liveboxandy/ZX-Max-128-Issue-5/ZX Max 128 Issue 5 PCB BTM.png

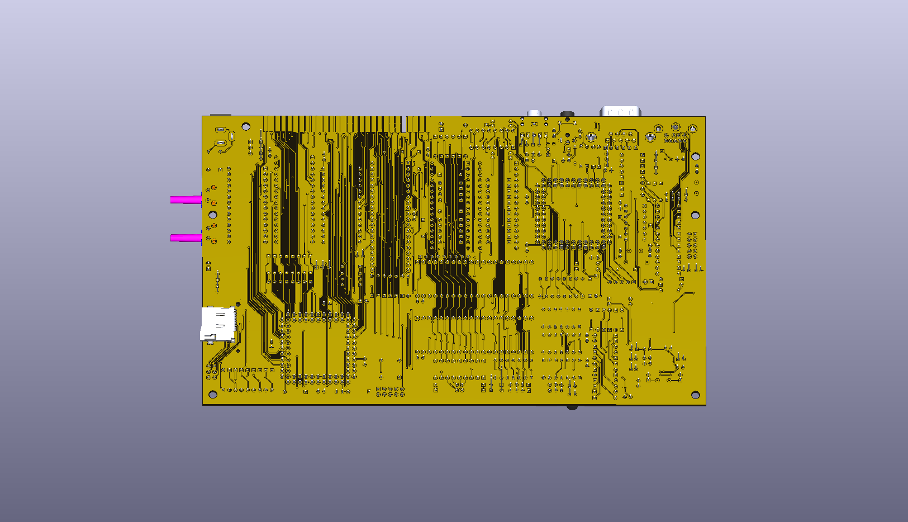
ZX Max 128 Issue 5 PCB BTM.png
