liveboxandy/ZX-Max-128-Issue-5/ZX Max 128 Issue 5 PCB.jpg

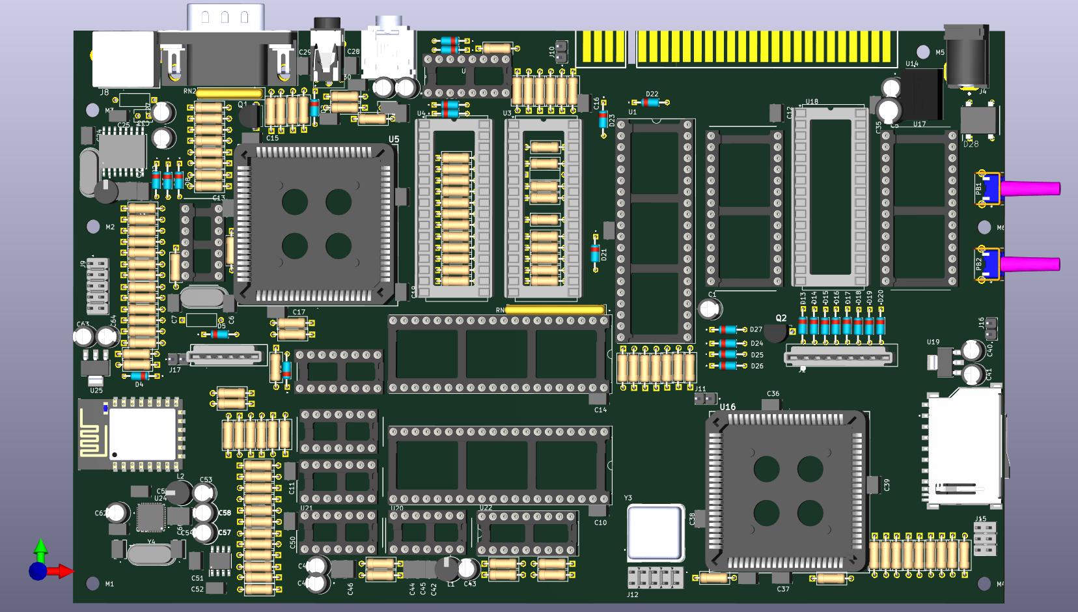
ZX Max 128 Issue 5 PCB.jpg
