liveboxandy/ZX-Max-128-Issue-5/Step/QFN-40 (6x6x0.9).step

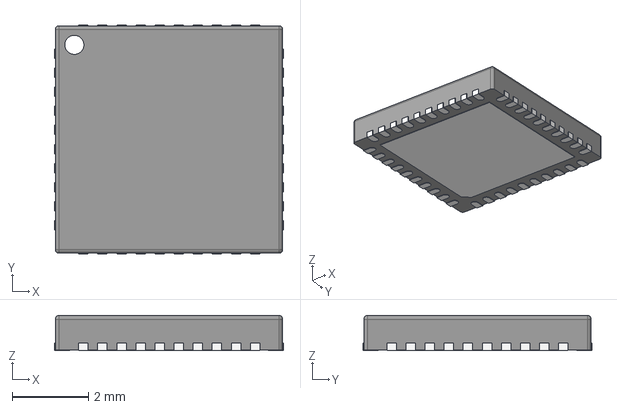
[picture p3: CAD file, 2026-07-04]
Step/QFN-40 (6x6x0.9).step
6.00 x 6.00 x 0.92 mm
