liveboxandy/ZX-Max-128-Issue-5/Step/D_DO-35_SOD27_P7.62mm_Horizontal.step

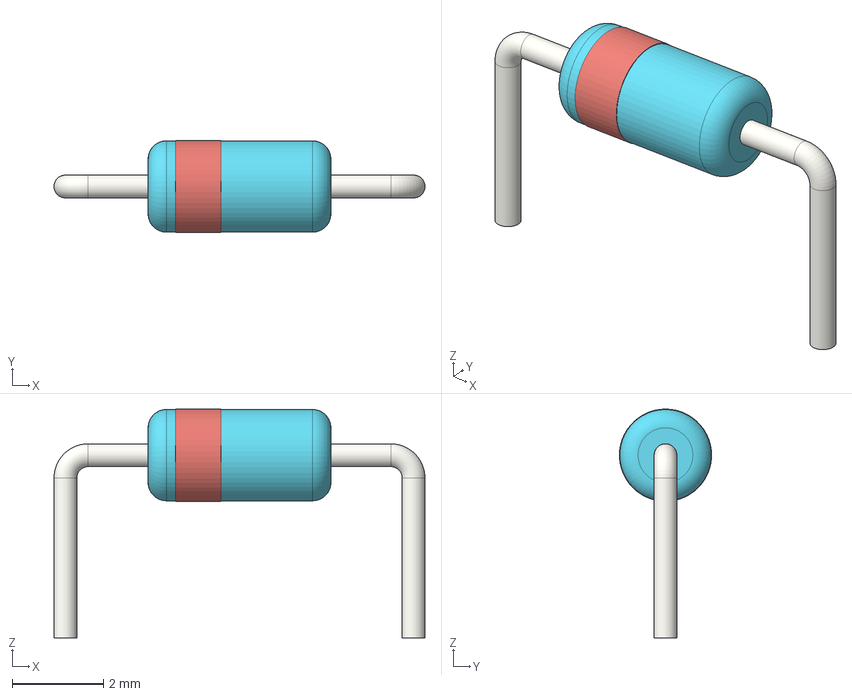
[picture p4: CAD file, 2026-07-04]
Step/D_DO-35_SOD27_P7.62mm_Horizontal.step
8.12 x 2.02 x 5.01 mm
