liveboxandy/ZX-Max-128-Issue-5/Step/Diode Bridge Rectifier DF02M.stp

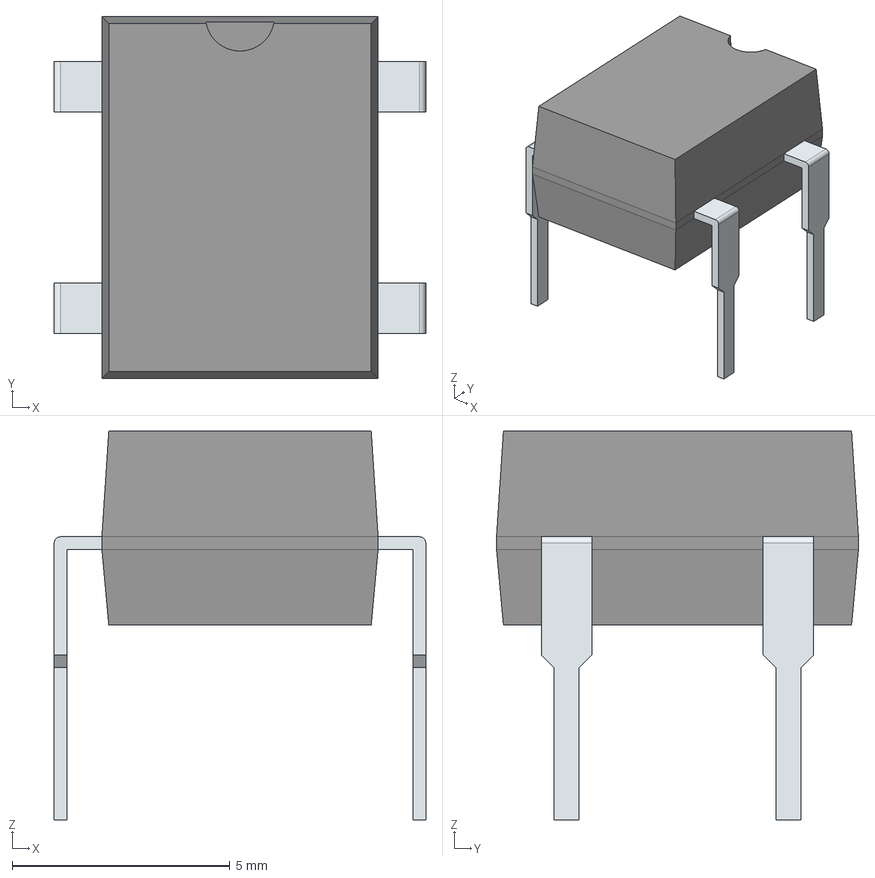
[picture p5: CAD file, 2026-07-04]
Step/Diode Bridge Rectifier DF02M.stp
8.54 x 8.32 x 8.93 mm
PinsArrayLR
