liveboxandy/ZX-Max-128-Issue-5/Step/DIP-40_W15.24mm.step

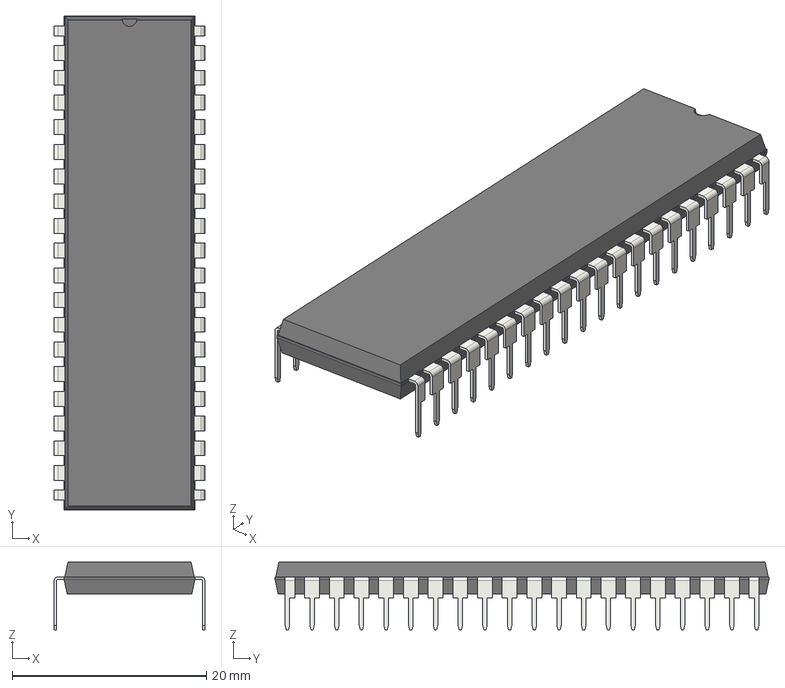
[picture p6: CAD file, 2026-07-04]
Step/DIP-40_W15.24mm.step
15.5 x 50.8 x 6.98 mm
