liveboxandy/ZX-Max-128-Issue-5/Step/Audio Connector SJ1-3525N.step

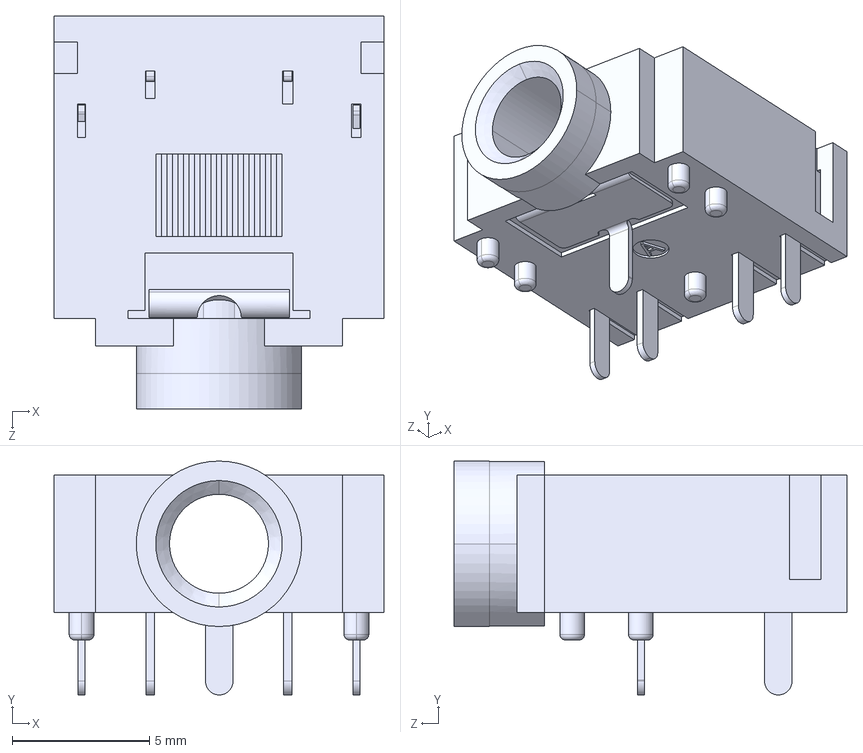
[picture p7: CAD file, 2026-07-04]
Step/Audio Connector SJ1-3525N.step
12.0 x 8.51 x 14.3 mm
