liveboxandy/ZX-Max-128-Issue-5/Step/R-78E5.0-1.0.step

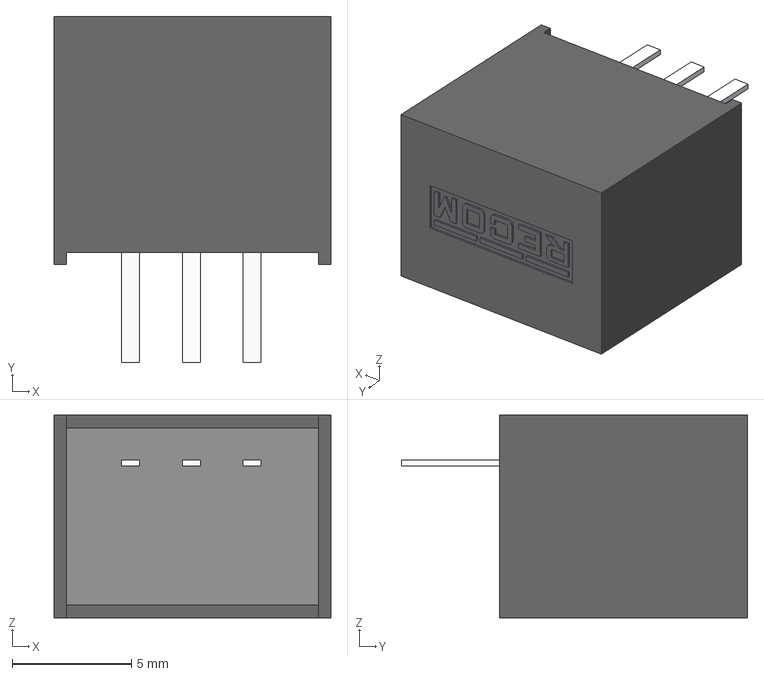
[picture p8: CAD file, 2026-07-04]
Step/R-78E5.0-1.0.step
11.6 x 14.5 x 8.50 mm
