liveboxandy/ZX-Max-128-Issue-5/Step/SN74HC04N.stp

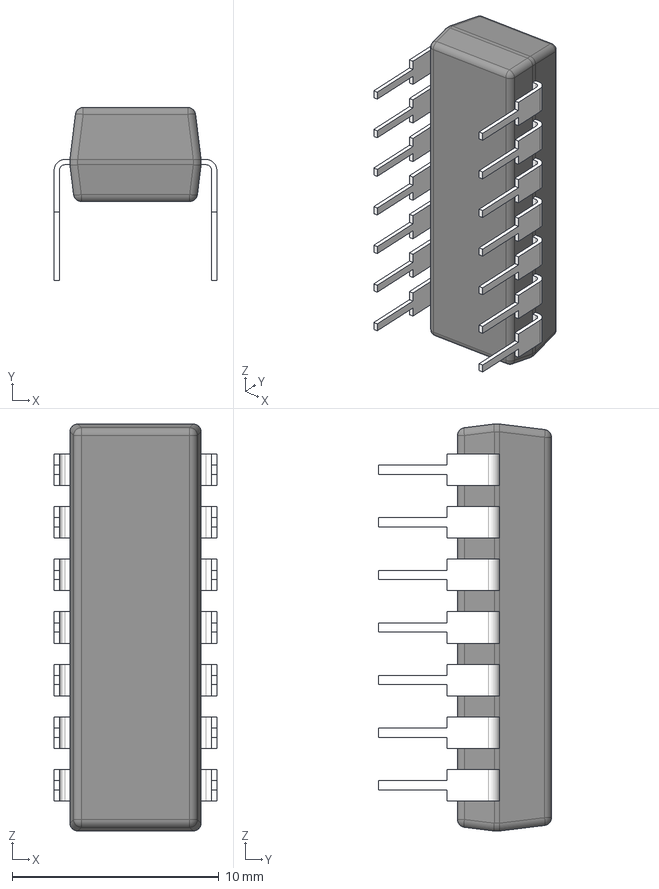
[picture p9: CAD file, 2026-07-04]
Step/SN74HC04N.stp
7.87 x 8.37 x 19.7 mm
BODY_N0014A_AF0
LEAD_N0014A_AF1
LEAD_N0014A x 10
LEAD_N0014A_AF3
LEAD_N0014A_AF0
LEAD_N0014A_AF2
