liveboxandy/ZX-Max-128-Issue-5/Step/Inductor rlb0608.stp

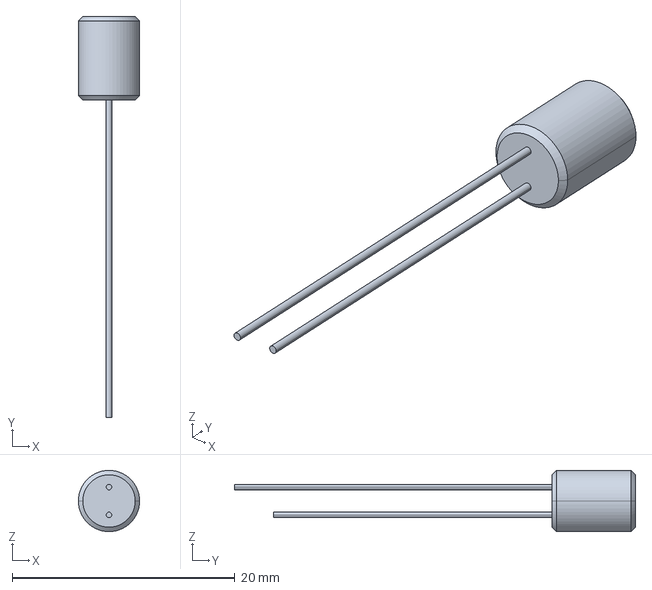
[picture p10: CAD file, 2026-07-04]
Step/Inductor rlb0608.stp
5.50 x 36.0 x 5.50 mm
