liveboxandy/ZX-Max-128-Issue-5/Step/4606X-101-103LF.STEP

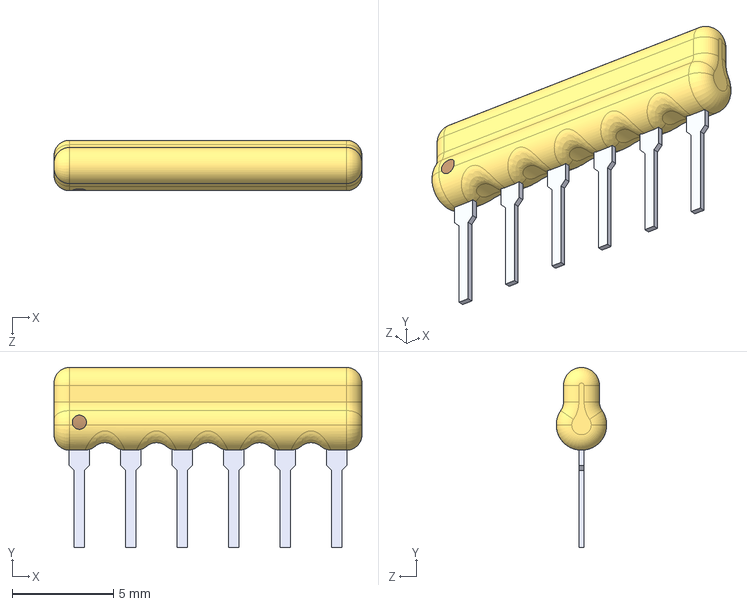
[picture p11: CAD file, 2026-07-04]
Step/4606X-101-103LF.STEP
15.2 x 8.88 x 2.49 mm
