liveboxandy/ZX-Max-128-Issue-5/Step/DIP-32_W15.24mm_Socket-1.stp

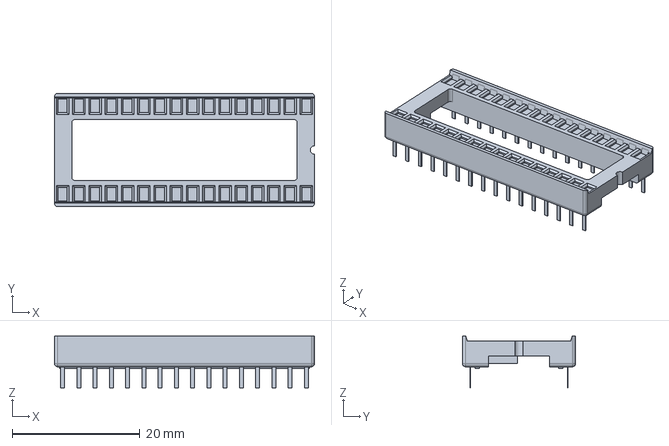
[picture p12: CAD file, 2026-07-04]
Step/DIP-32_W15.24mm_Socket-1.stp
40.6 x 17.7 x 8.10 mm
