liveboxandy/ZX-Max-128-Issue-5/Step/KMDGX-9S-BS-1.stp

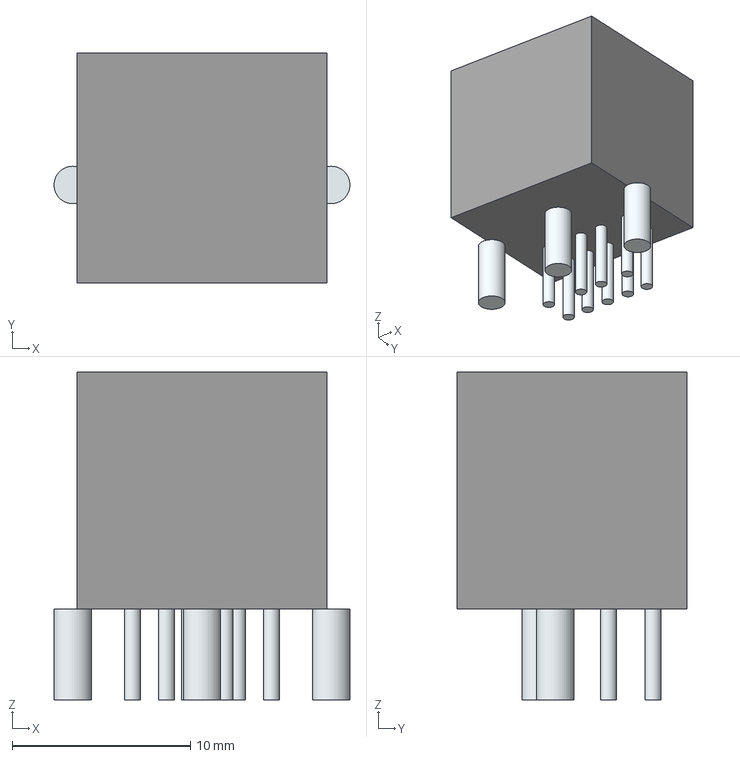
[picture p13: CAD file, 2026-07-04]
Step/KMDGX-9S-BS-1.stp
16.6 x 12.9 x 18.4 mm
Leads
