liveboxandy/ZX-Max-128-Issue-5/Step/Switch 6mm RA SKHHNHA010.stp

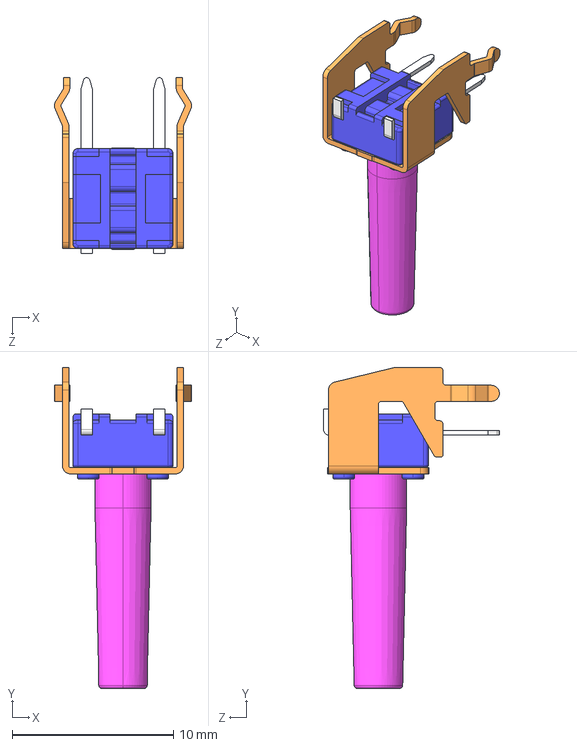
[picture p14: CAD file, 2026-07-04]
Step/Switch 6mm RA SKHHNHA010.stp
8.50 x 19.9 x 10.9 mm
