liveboxandy/ZX-Max-128-Issue-5/Step/Resistor.08.88.step

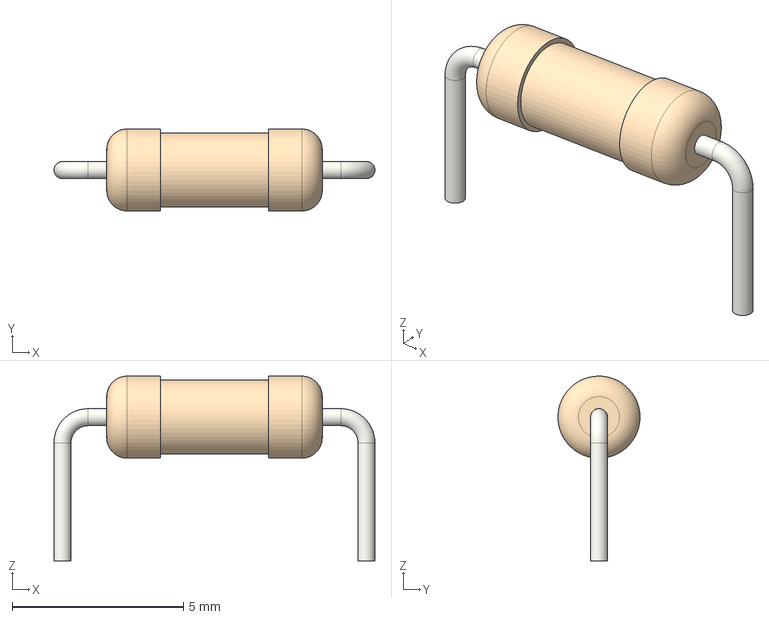
[picture p15: CAD file, 2026-07-04]
Step/Resistor.08.88.step
9.38 x 2.40 x 5.40 mm
