liveboxandy/ZX-Max-128-Issue-5/Step/ESP8266-12E_ESP-12E.step

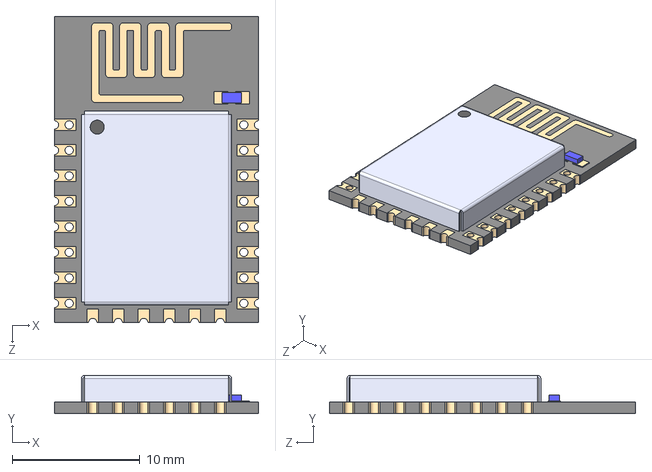
[picture p17: CAD file, 2026-07-04]
Step/ESP8266-12E_ESP-12E.step
16.0 x 3.00 x 24.0 mm
