liveboxandy/ZX-Max-128-Issue-5/Step/SN74HC174N.stp

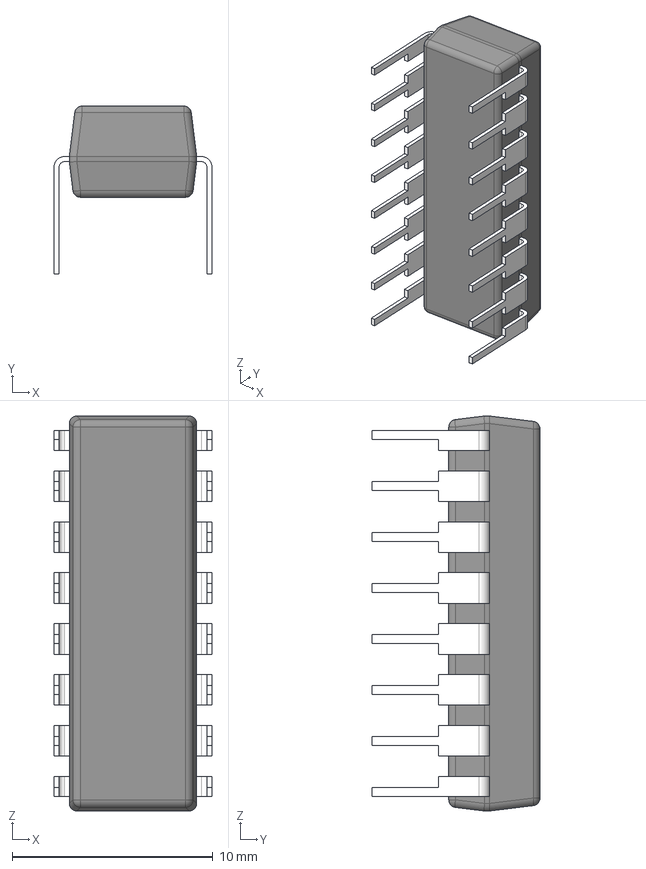
[picture p18: CAD file, 2026-07-04]
Step/SN74HC174N.stp
7.87 x 8.37 x 19.7 mm
BODY_N0016A_AF0
LEAD_N0016A_AF1
LEAD_N0016A x 10
LEAD_N0016A_AF3
LEAD_N0016A_AF5
LEAD_N0016A_AF0
LEAD_N0016A_AF2
LEAD_N0016A_AF4
