liveboxandy/ZX-Max-128-Issue-5/Step/SDCard ST-TF-003A.step

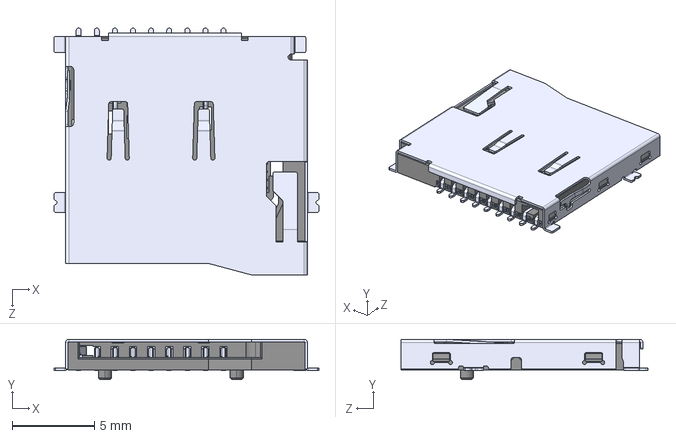
[picture p19: CAD file, 2026-07-04]
Step/SDCard ST-TF-003A.step
16.1 x 2.45 x 15.0 mm
