liveboxandy/ZX-Max-128-Issue-5/Step/IND_BOURNS_RLB0608.step

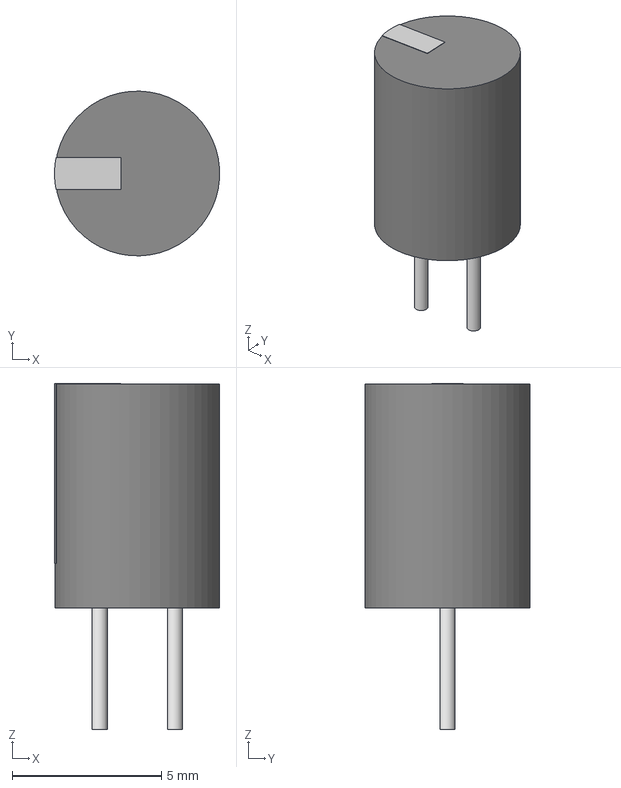
[picture p22: CAD file, 2026-07-04]
Step/IND_BOURNS_RLB0608.step
5.52 x 5.51 x 11.6 mm
