liveboxandy/ZX-Max-128-Issue-5/Step/KMDGX-9S-BS-1_A1.IGS

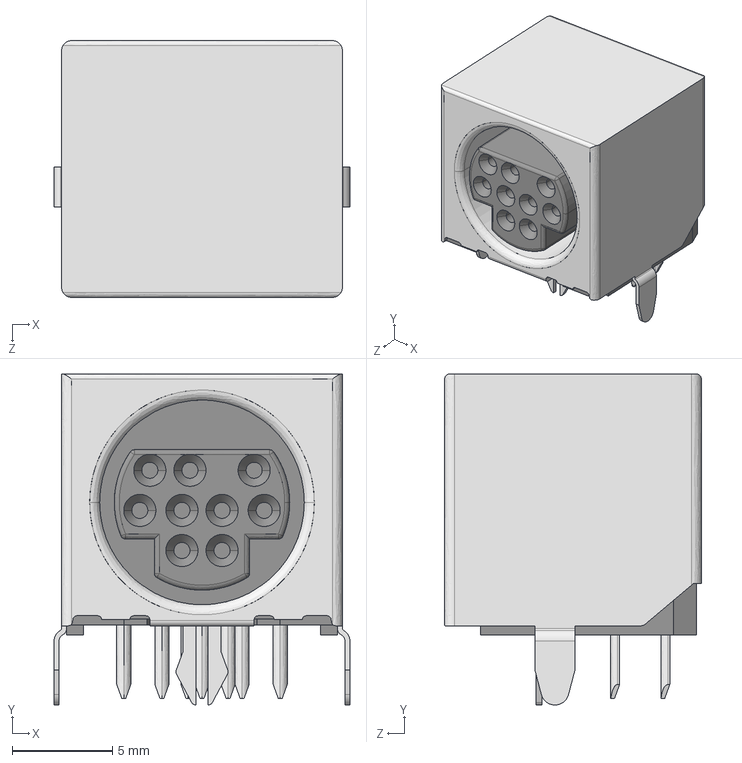
[picture p23: CAD file, 2026-07-04]
Step/KMDGX-9S-BS-1_A1.IGS
14.8 x 16.5 x 12.8 mm
