liveboxandy/ZX-Max-128-Issue-5/Step/DIP-40_W15.24mm_Socket.step

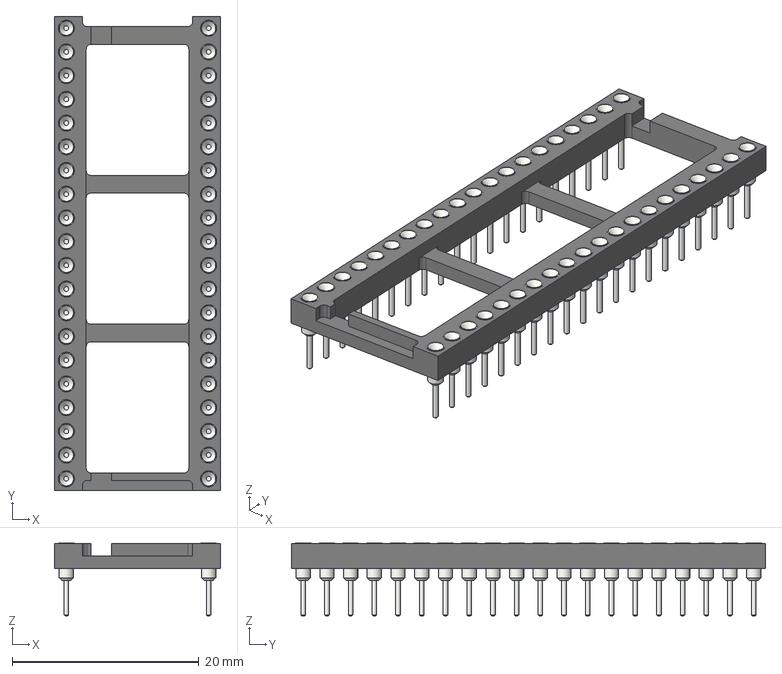
[picture p24: CAD file, 2026-07-04]
Step/DIP-40_W15.24mm_Socket.step
17.8 x 50.8 x 7.79 mm
