liveboxandy/ZX-Max-128-Issue-5/Step/9Pin D MRA Assmannn A-DS_09_A_KG-T4S.step

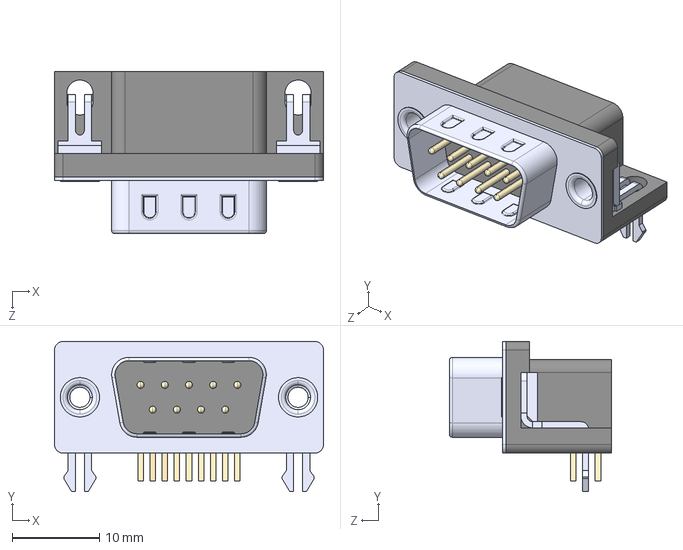
[picture p25: CAD file, 2026-07-04]
Step/9Pin D MRA Assmannn A-DS_09_A_KG-T4S.step
30.8 x 17.2 x 18.6 mm
