liveboxandy/ZX-Max-128-Issue-5/Step/PJ-322.step

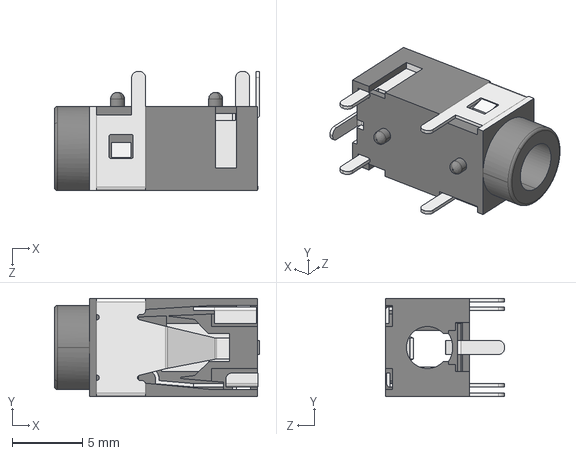
[picture p26: CAD file, 2026-07-04]
Step/PJ-322.step
14.6 x 7.00 x 8.50 mm
