liveboxandy/ZX-Max-128-Issue-5/Step/Voltage Regulator AZ1117IH-3.3TRG1.step

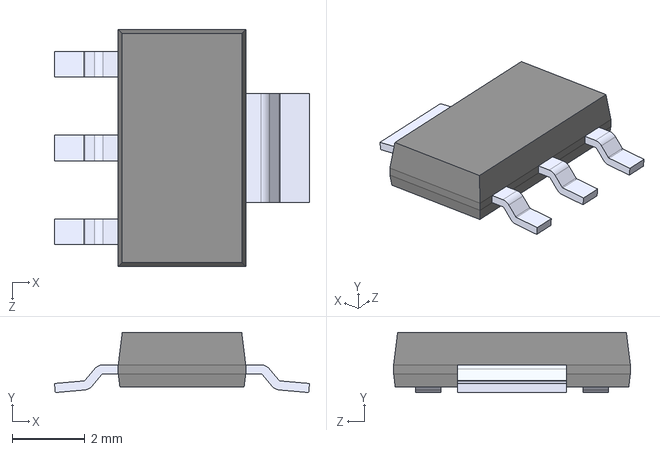
[picture p27: CAD file, 2026-07-04]
Step/Voltage Regulator AZ1117IH-3.3TRG1.step
7.00 x 1.65 x 6.50 mm
