liveboxandy/ZX-Max-128-Issue-5/Step/PLCC-84-AT.stp

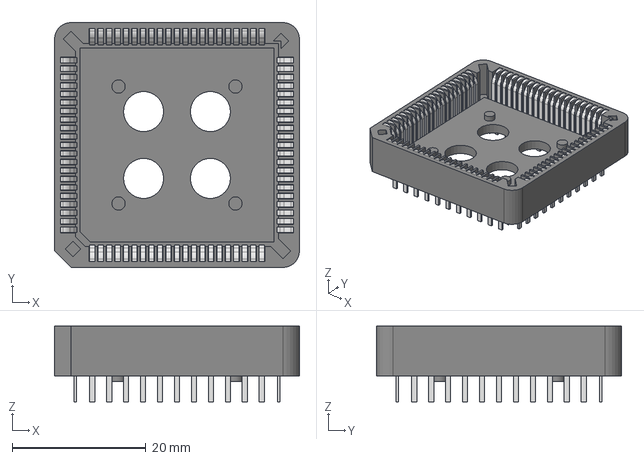
[picture p30: CAD file, 2026-07-04]
Step/PLCC-84-AT.stp
36.7 x 36.7 x 11.3 mm
