liveboxandy/ZX-Max-128-Issue-5/Step/SD Card Connector Wurth 693063020911 (rev1).stp

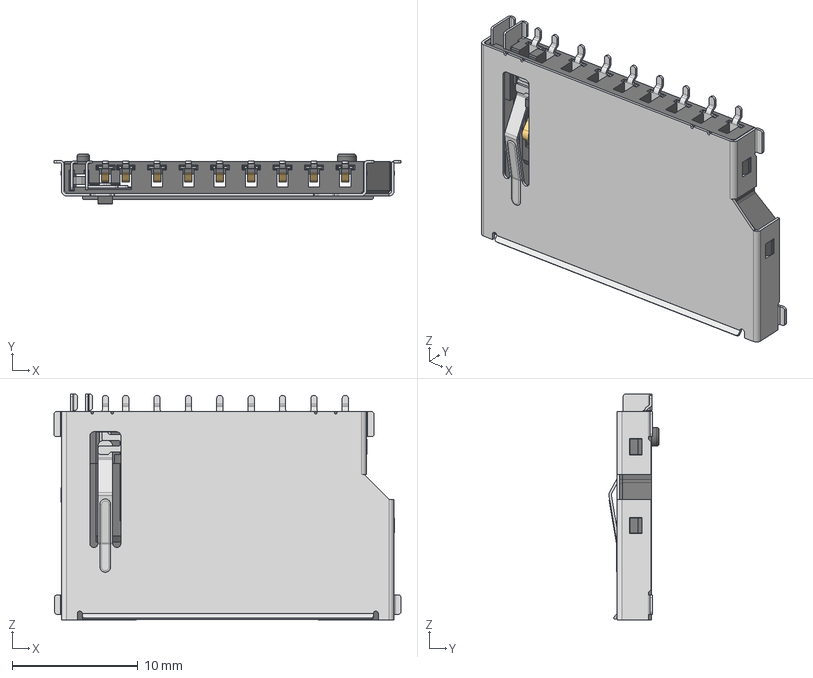
[picture p31: CAD file, 2026-07-04]
Step/SD Card Connector Wurth 693063020911 (rev1).stp
27.6 x 4.00 x 18.0 mm
693063020911_Housing
693063020911_PIN_CONTACT
693063020911_PIN_G x 2
693063020911_PIN_M
693063020911_PIN_P x 5
693063020911_PIN_TG
693063020911_PIN_RETENTION
693063020911_Shielding
