liveboxandy/ZX-Max-128-Issue-5/Step/5-520315-5.stp

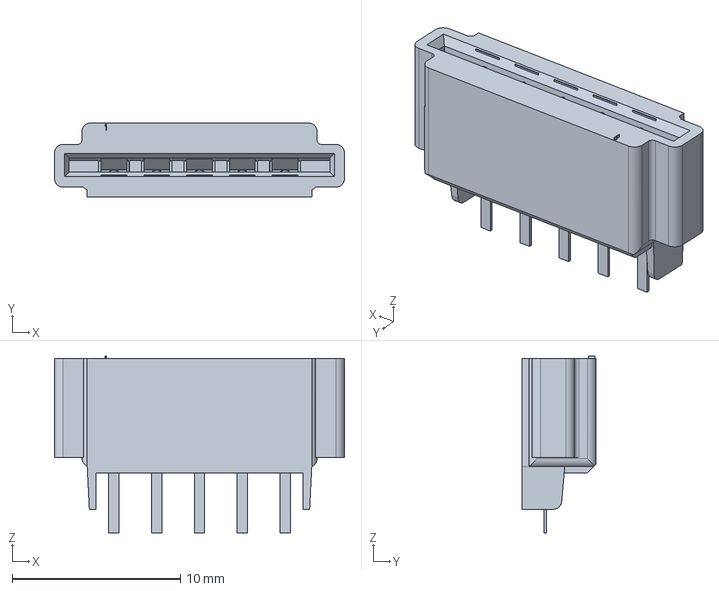
[picture p32: CAD file, 2026-07-04]
Step/5-520315-5.stp
17.2 x 4.39 x 10.5 mm
