liveboxandy/ZX-Max-128-Issue-5/Step/RW_16_ADI.step

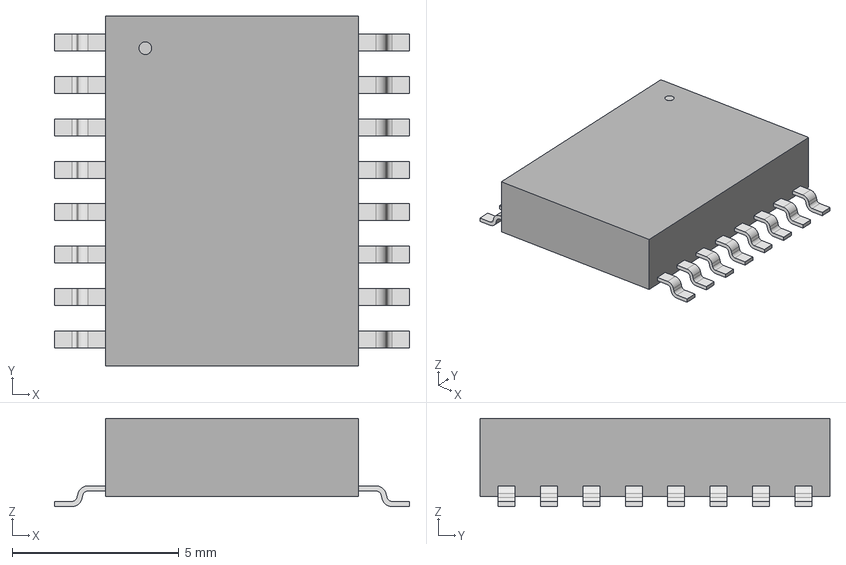
[picture p33: CAD file, 2026-07-04]
Step/RW_16_ADI.step
10.6 x 10.5 x 2.64 mm
