liveboxandy/ZX-Max-128-Issue-5/Step/DIP-16_W7.62mm.step

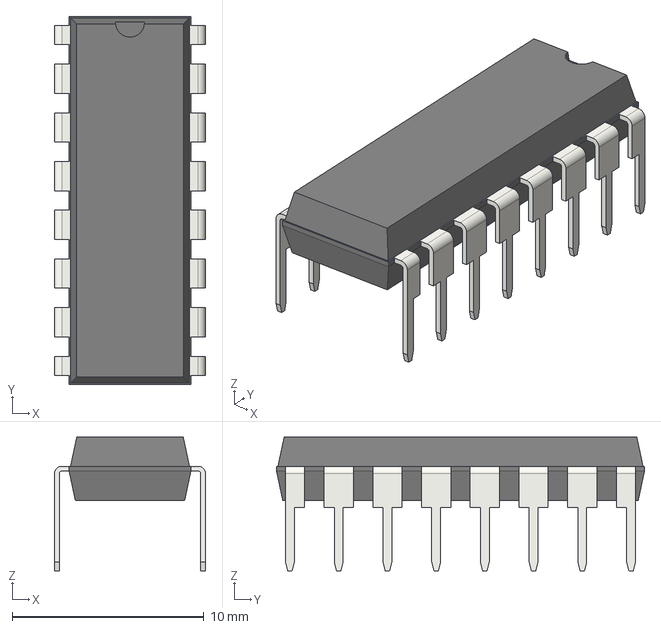
[picture p35: CAD file, 2026-07-04]
Step/DIP-16_W7.62mm.step
7.87 x 19.2 x 6.98 mm
