liveboxandy/ZX-Max-128-Issue-5/Step/DIP-28_W15.24mm.step

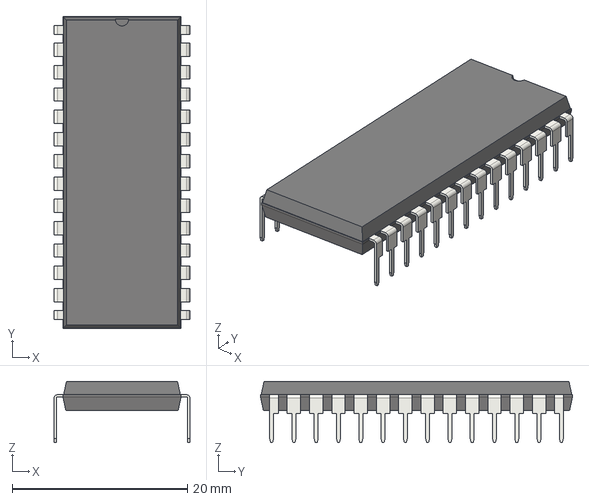
[picture p36: CAD file, 2026-07-04]
Step/DIP-28_W15.24mm.step
15.5 x 35.6 x 6.98 mm
