liveboxandy/ZX-Max-128-Issue-5/Step/Crystal_HC49-4H_Vertical.step

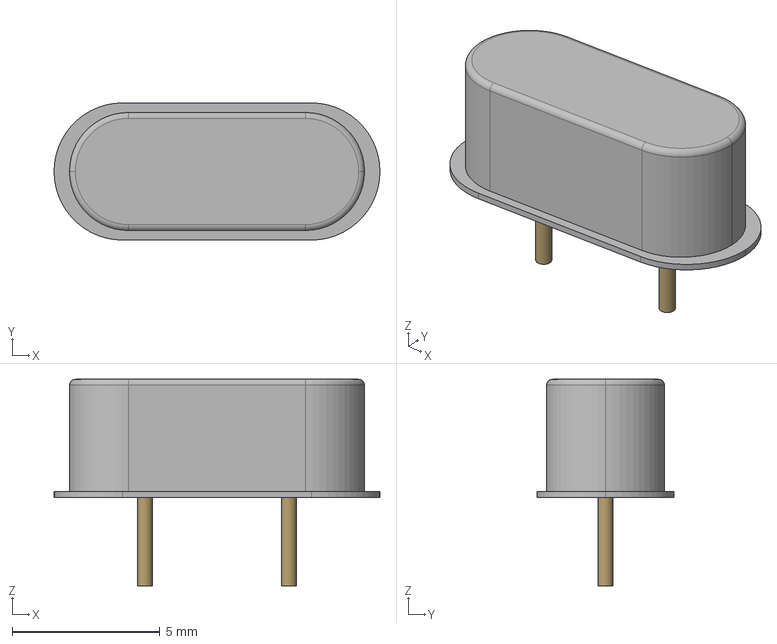
[picture p38: CAD file, 2026-07-04]
Step/Crystal_HC49-4H_Vertical.step
11.1 x 4.65 x 7.00 mm
