liveboxandy/ZX-Max-128-Issue-5/Step/84-PLCC_ALR.step

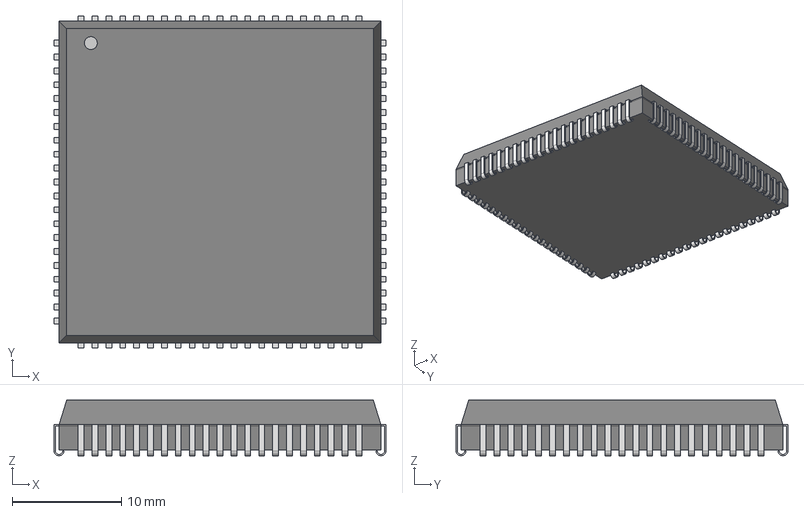
[picture p39: CAD file, 2026-07-04]
Step/84-PLCC_ALR.step
30.4 x 30.4 x 5.08 mm
