liveboxandy/ZX-Max-128-Issue-5/Step/MCP602-E_SN.stp

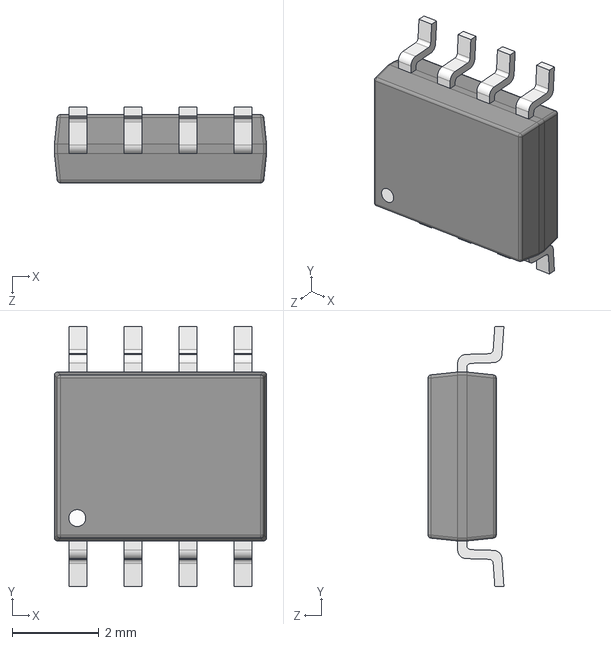
[picture p40: CAD file, 2026-07-04]
Step/MCP602-E_SN.stp
4.90 x 6.00 x 1.75 mm
