liveboxandy/ZX-Max-128-Issue-5/Step/DIP-18_W7.62mm_Socket.step

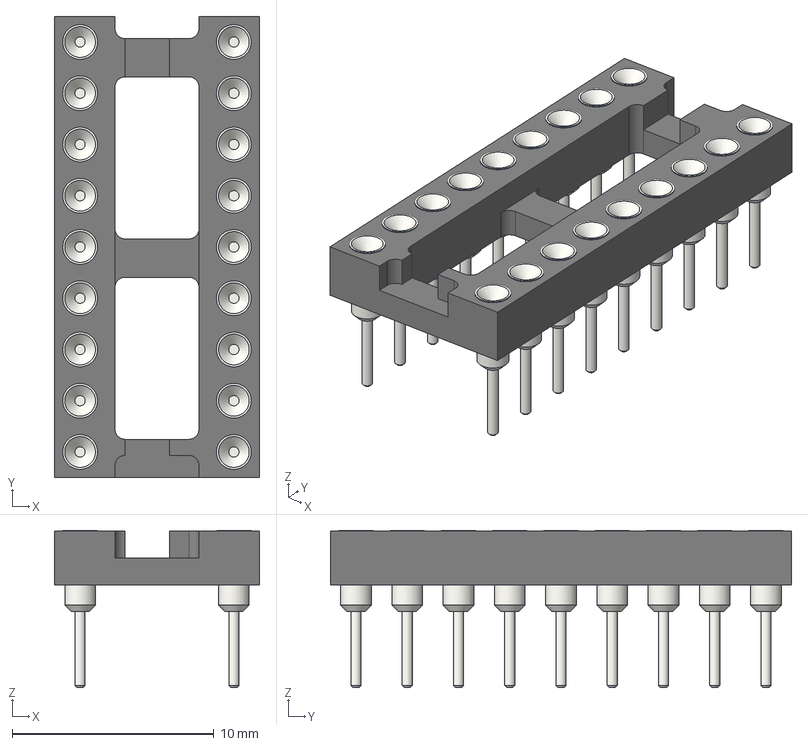
[picture p41: CAD file, 2026-07-04]
Step/DIP-18_W7.62mm_Socket.step
10.2 x 22.9 x 7.79 mm
