liveboxandy/ZX-Max-128-Issue-5/Step/Oscillator 4 Pin 8Mhz ECS-2100A-080.step

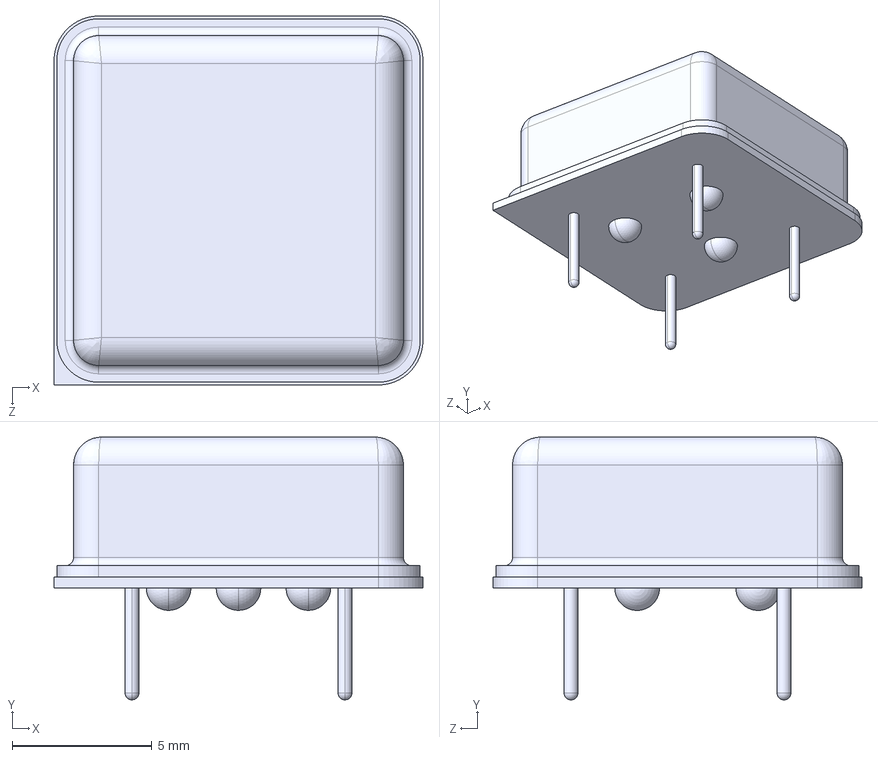
[picture p42: CAD file, 2026-07-04]
Step/Oscillator 4 Pin 8Mhz ECS-2100A-080.step
13.2 x 9.40 x 13.2 mm
