liveboxandy/ZX-Max-128-Issue-5/Step/4609X-101-103LF.step

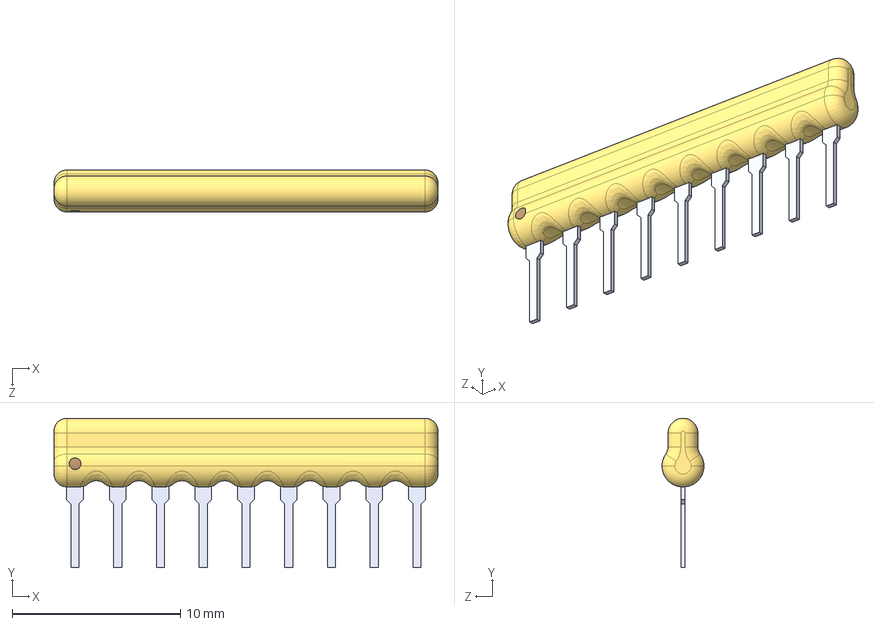
[picture p43: CAD file, 2026-07-04]
Step/4609X-101-103LF.step
22.8 x 8.88 x 2.49 mm
