liveboxandy/ZX-Max-128-Issue-5/Step/Connector Pin-Pin 1x2 M20-9990246.step

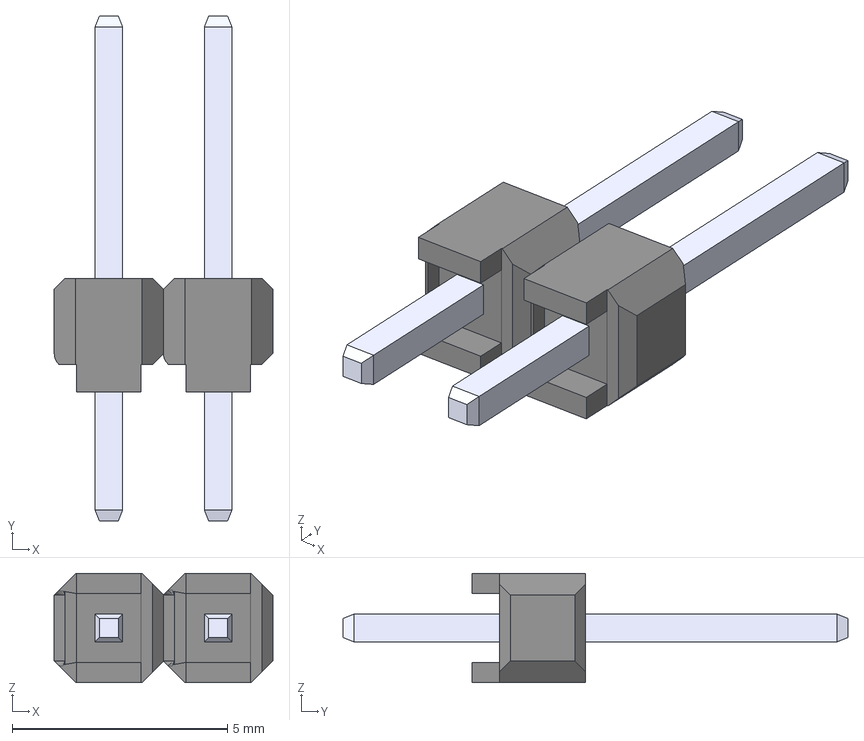
[picture p46: CAD file, 2026-07-04]
Step/Connector Pin-Pin 1x2 M20-9990246.step
5.08 x 11.7 x 2.54 mm
