liveboxandy/ZX-Max-128-Issue-5/Step/BC548BTA.stp

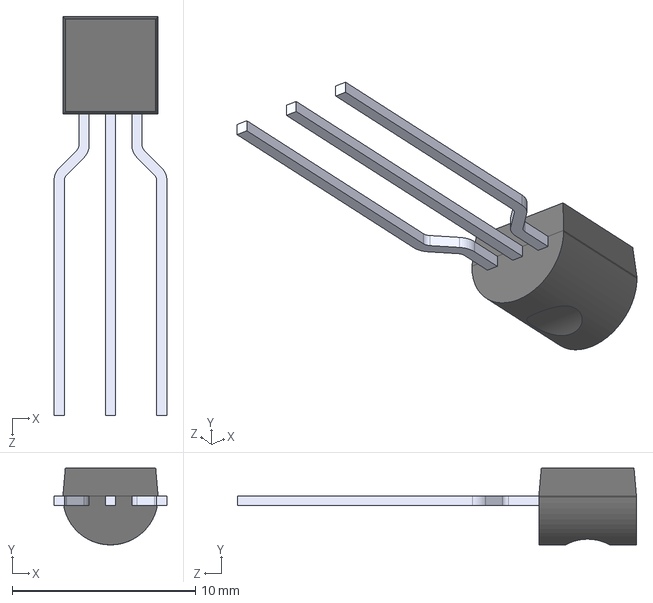
[picture p47: CAD file, 2026-07-04]
Step/BC548BTA.stp
6.16 x 4.19 x 21.8 mm
