liveboxandy/ZX-Max-128-Issue-5/Step/Capacitor 22uF 16V 5x7 EEAGA1C220H.step

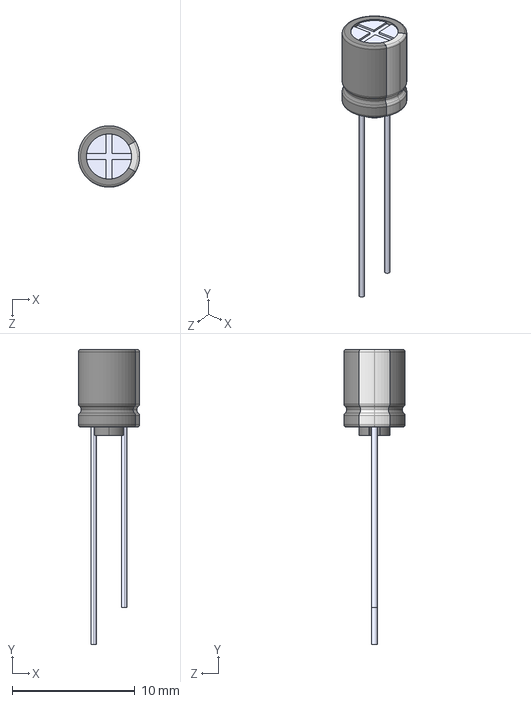
[picture p48: CAD file, 2026-07-04]
Step/Capacitor 22uF 16V 5x7 EEAGA1C220H.step
5.00 x 24.0 x 4.99 mm
