liveboxandy/ZX-Max-128-Issue-5/(list of files, cad)

Other CAD files:
Step/10129381-906002BLF.step
Step/10129381-910002BLF.step
