liveboxandy/ZX-Max-128-Issue-5/ZX Max 128 Issue 5 PCB.png

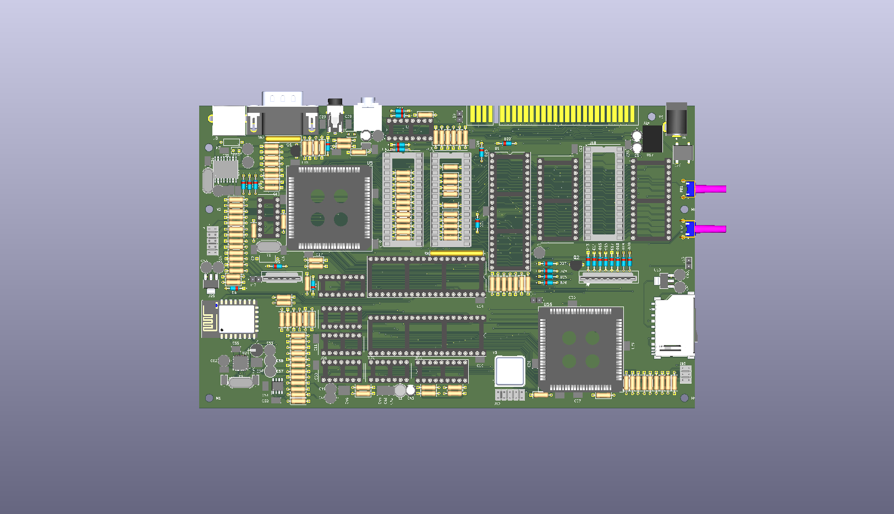
ZX Max 128 Issue 5 PCB.png
