liveboxandy/ZX-Max-128-Issue-5/ZX Max 128 Issue 5 PCB.pdf

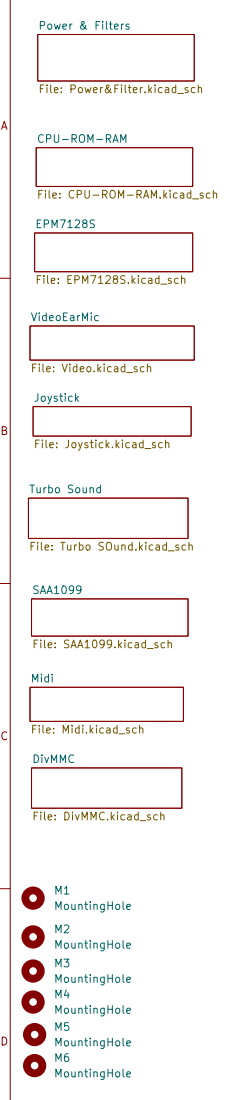
[picture p50: page 1]

File: EPM7128S.kicad_sch Power & Filters File: Power&Filter.kicad_sch DivMMC
Joystick File: Joystick.kicad_sch CPU-ROM-RAM

File: CPU-ROM-RAM.kicad_sch

Turbo Sound
File: SAA1099.kicad_sch M5 MountingHole M3 MountingHole M6 MountingHole M2 MountingHole M4 MountingHole M1 MountingHole

File: DivMMC.kicad_sch Midi File: Midi.kicad_sch SAA1099

Sheet: /
File: ZX Max 128 Issue 5 PCB.kicad_sch
Title:

Size: A4 | Rev:
KiCad E.D.A. 10.0.4 | Id: 1/10

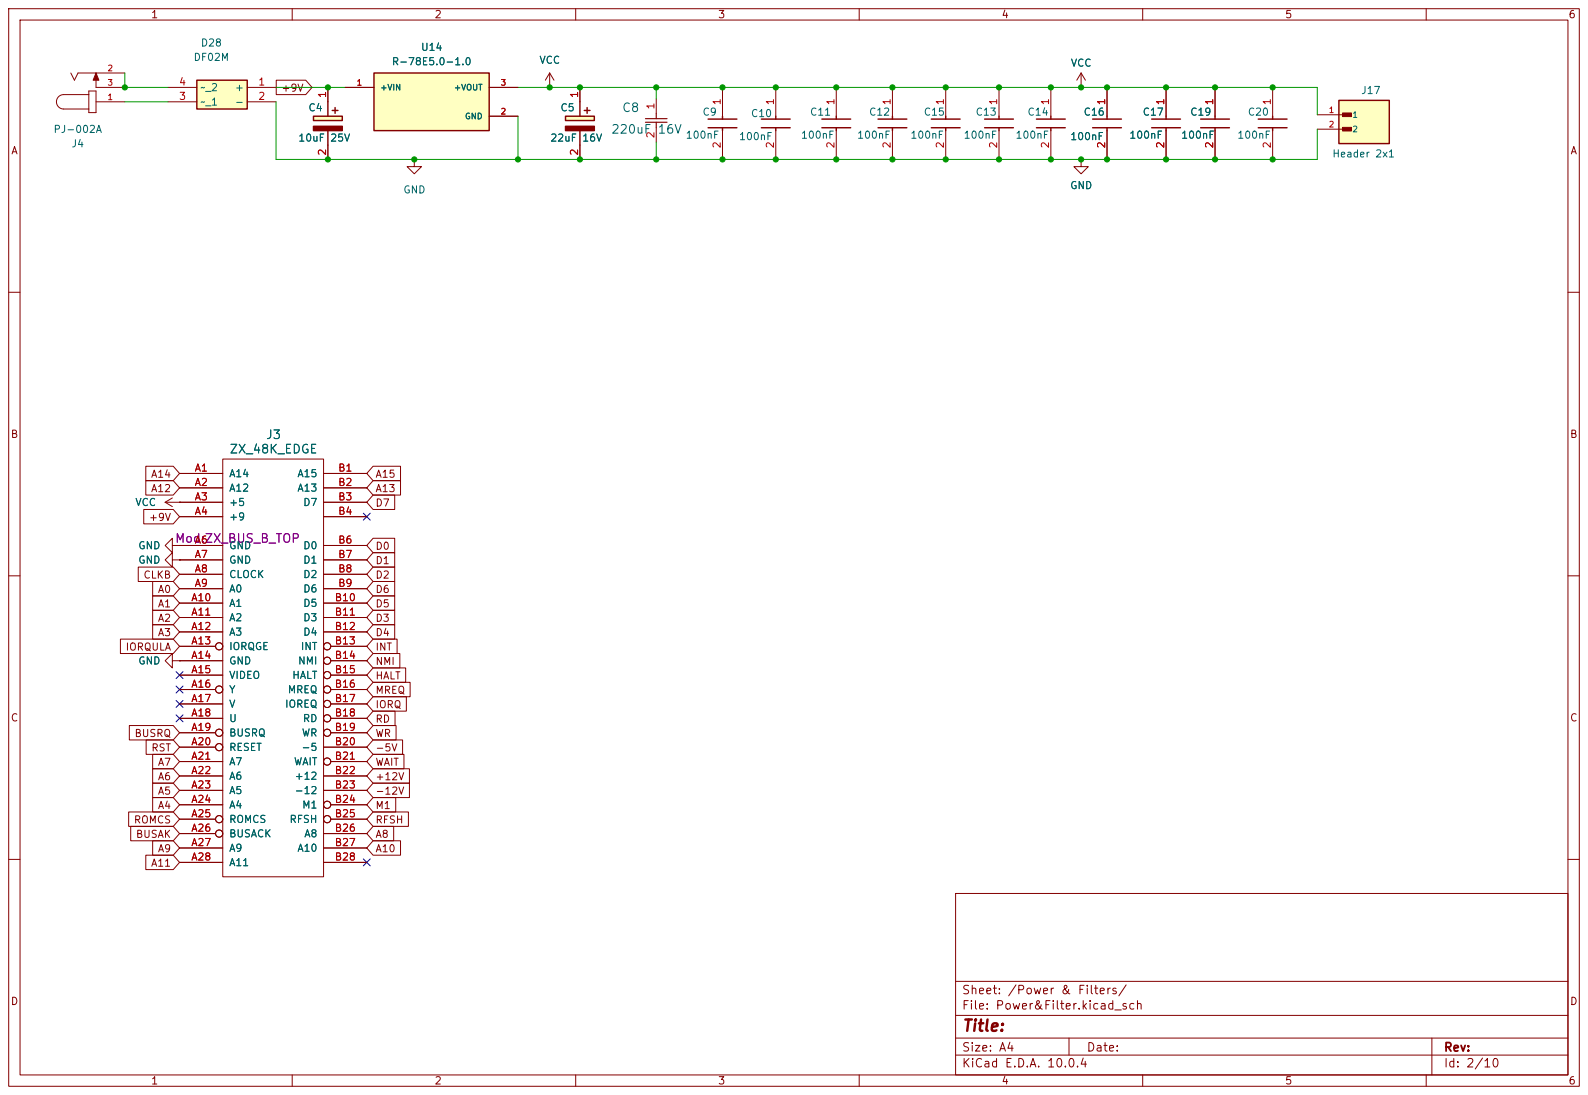
[picture p51: page 2]

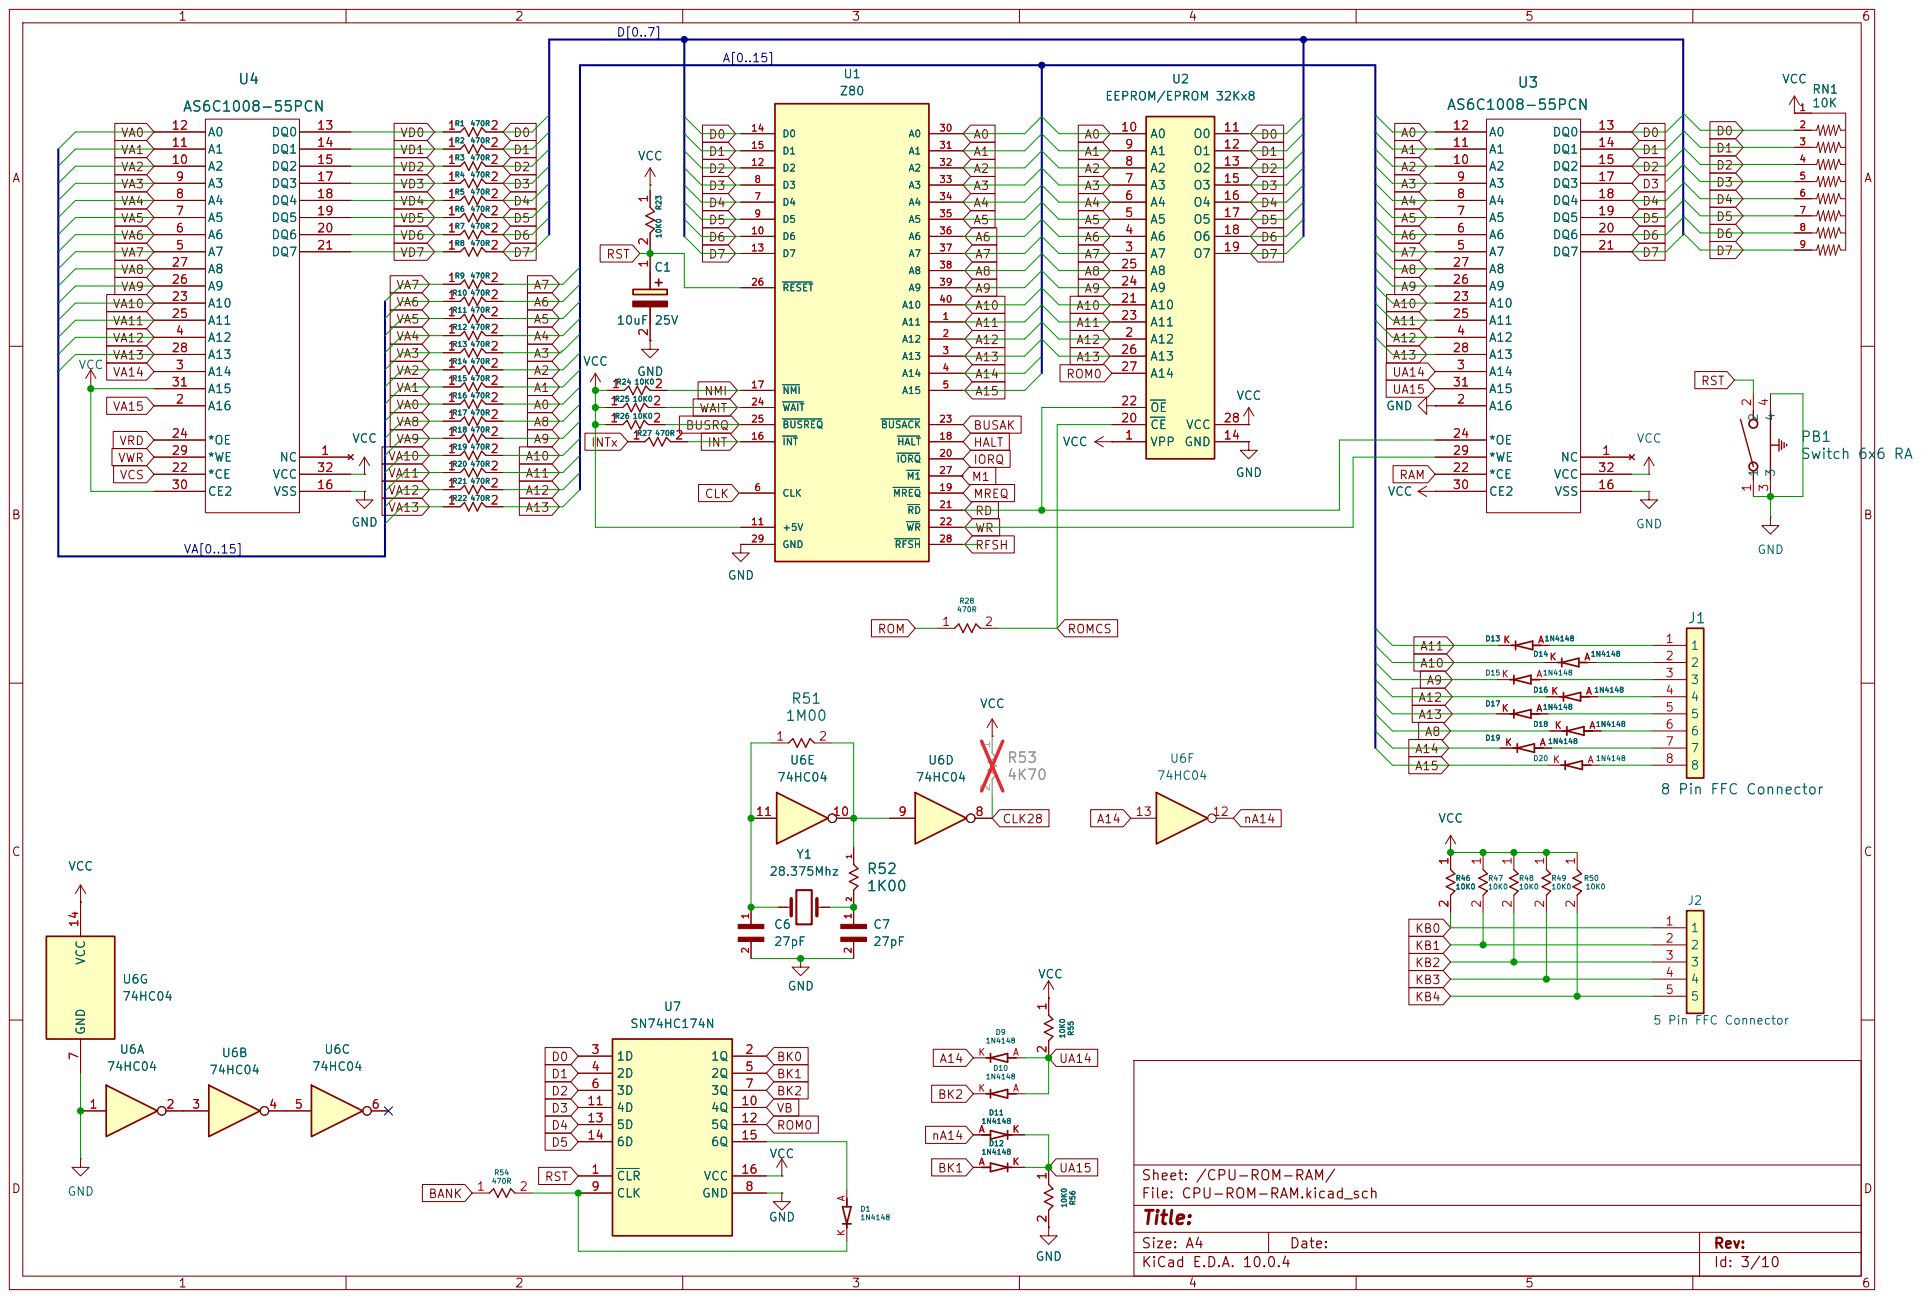
[picture p52: page 3]

Z80 | U2 EEPROM/EPROM 32Kx8 EEPROM/EPROM 32Kx8

8 Pin FFC Connector VCC

Sheet: /CPU-ROM-RAM/
File: CPU-ROM-RAM.kicad_sch
Title:

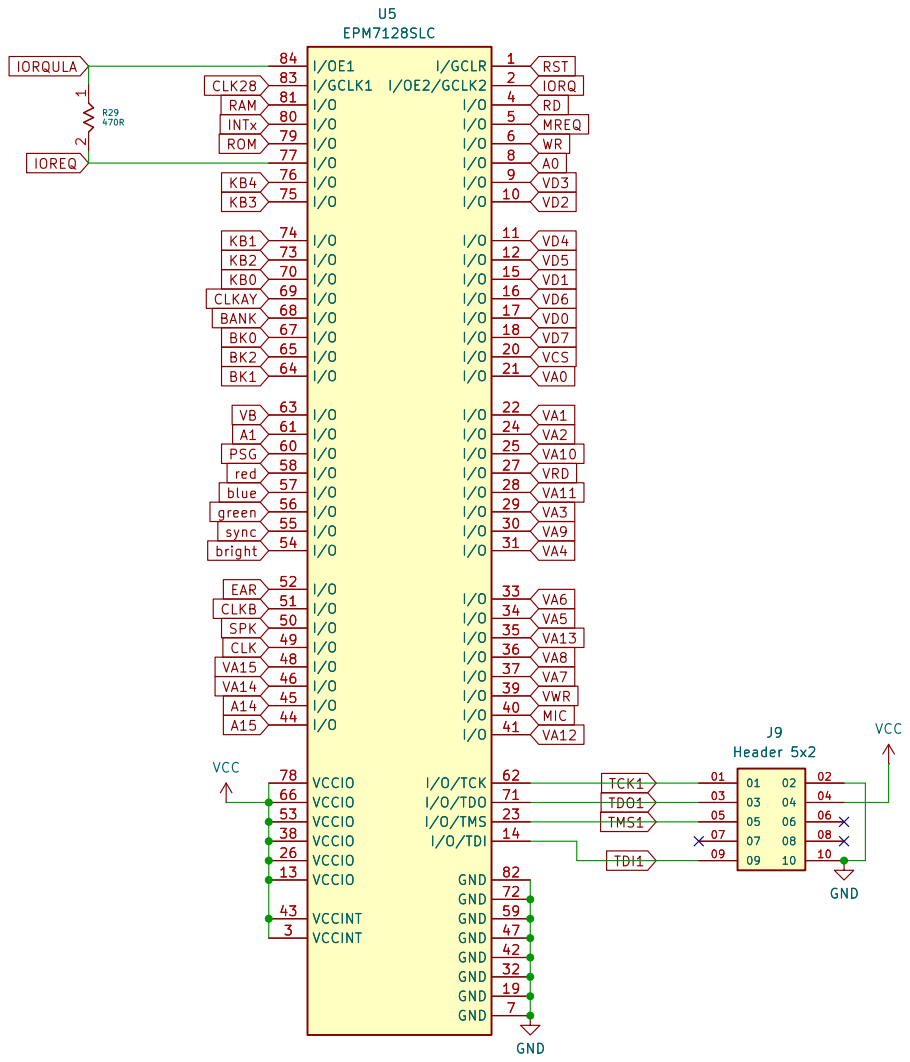
[picture p53: page 4]

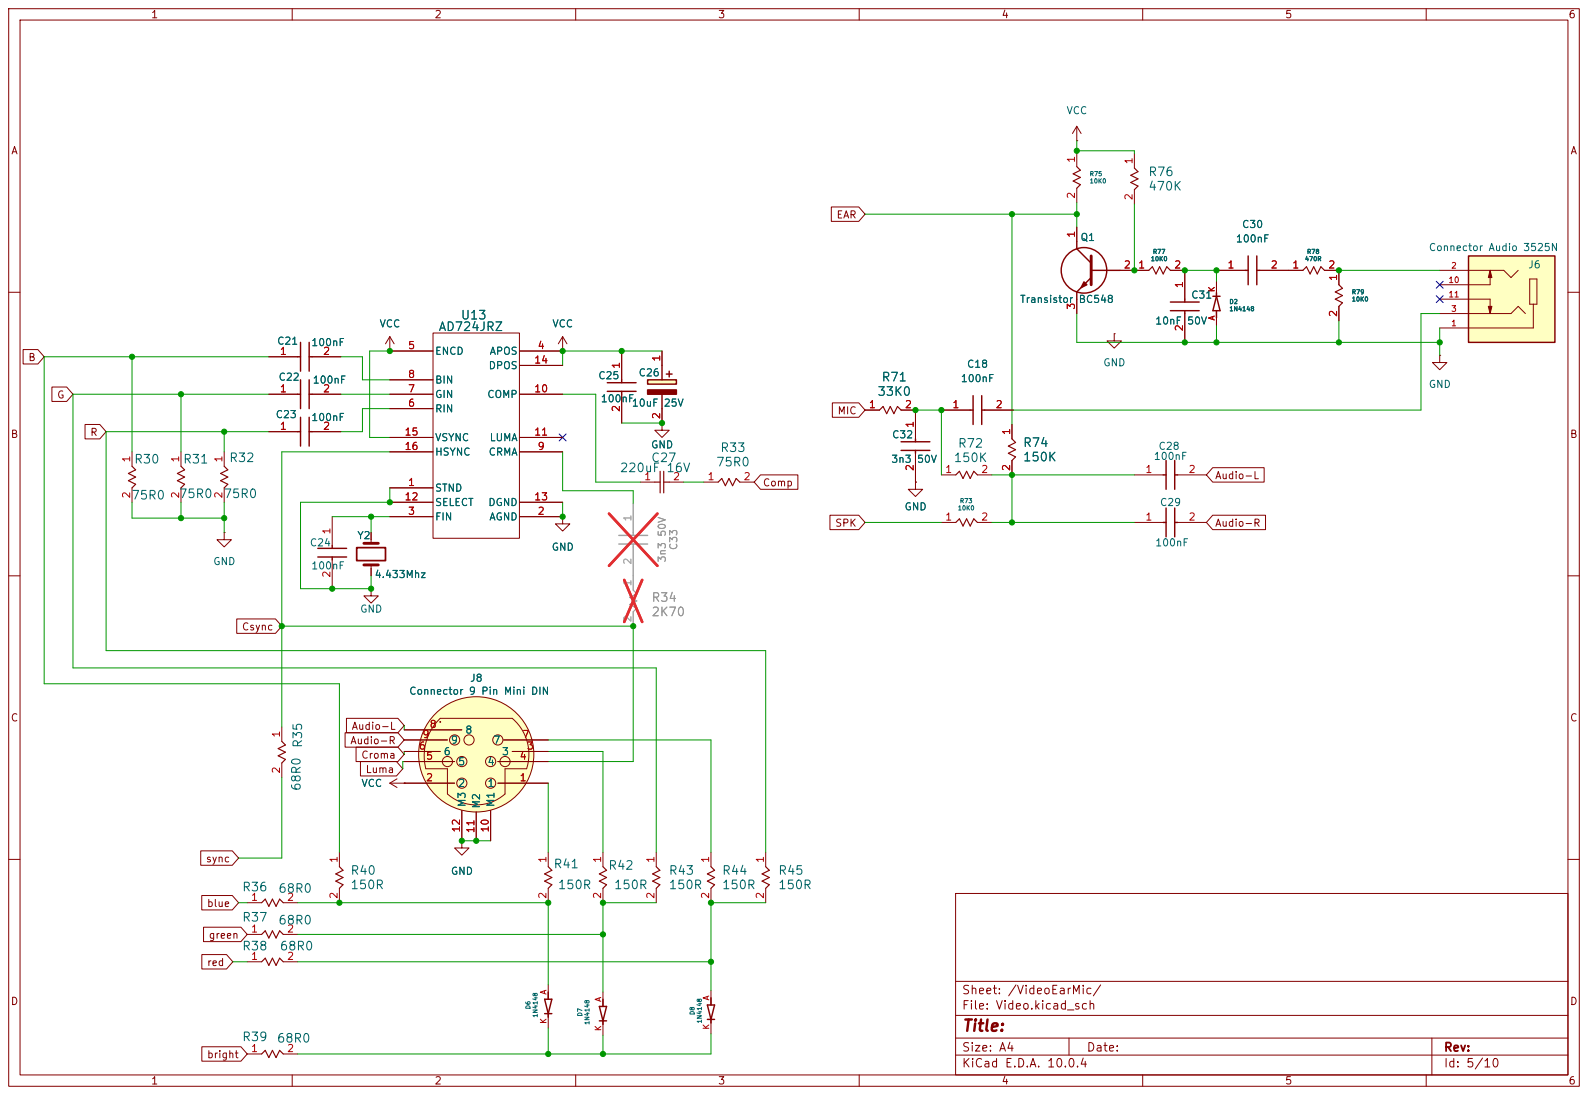
[picture p54: page 5]

J8 Connector 9 Pin Mini DIN

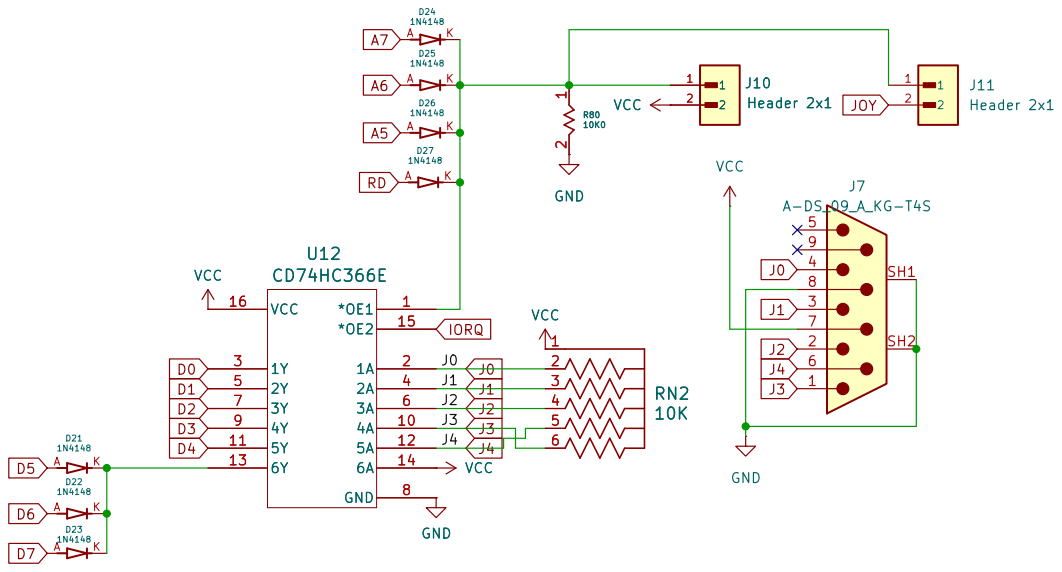
[picture p55: page 6]

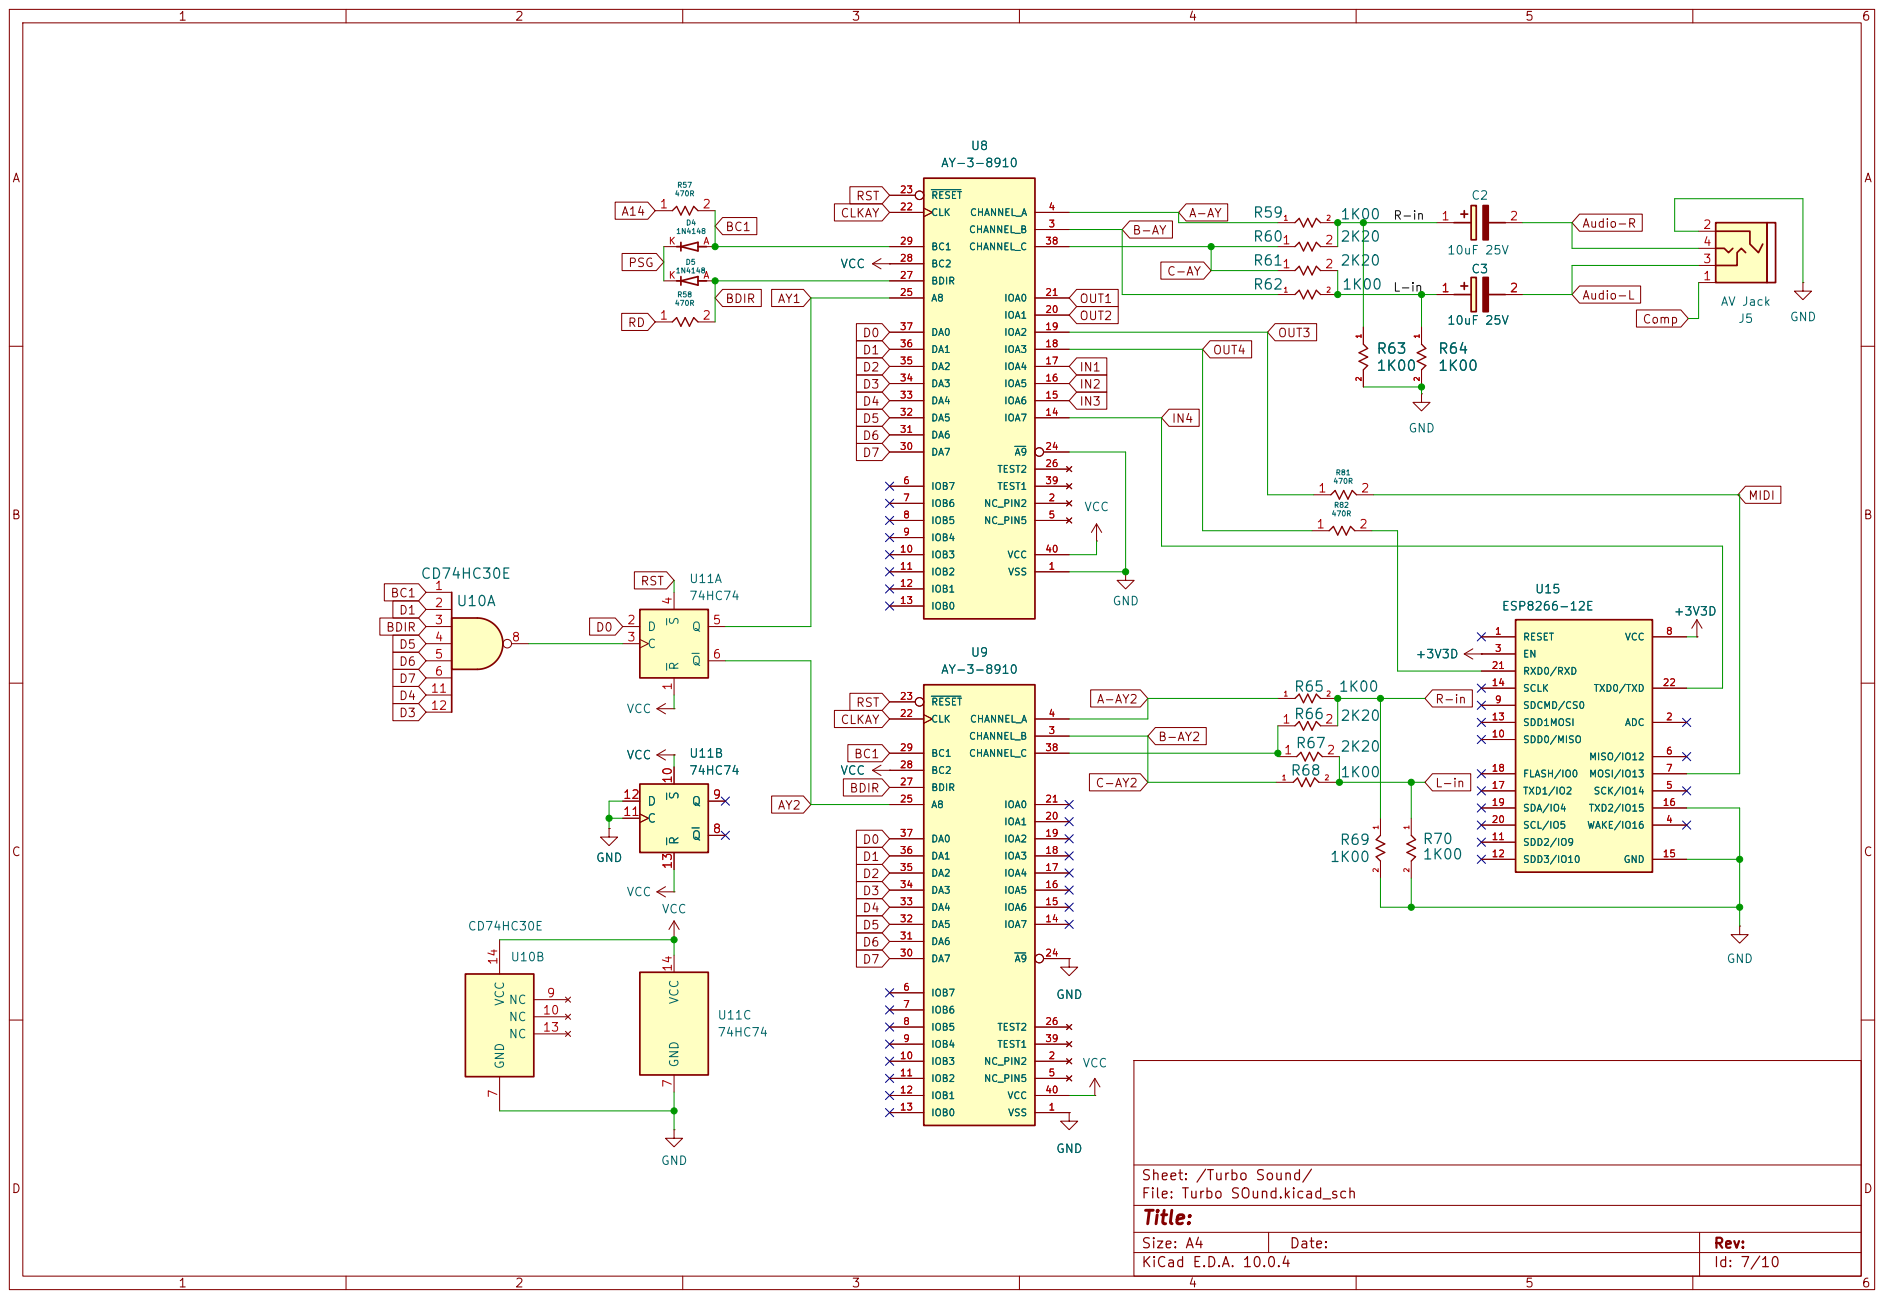
[picture p56: page 7]

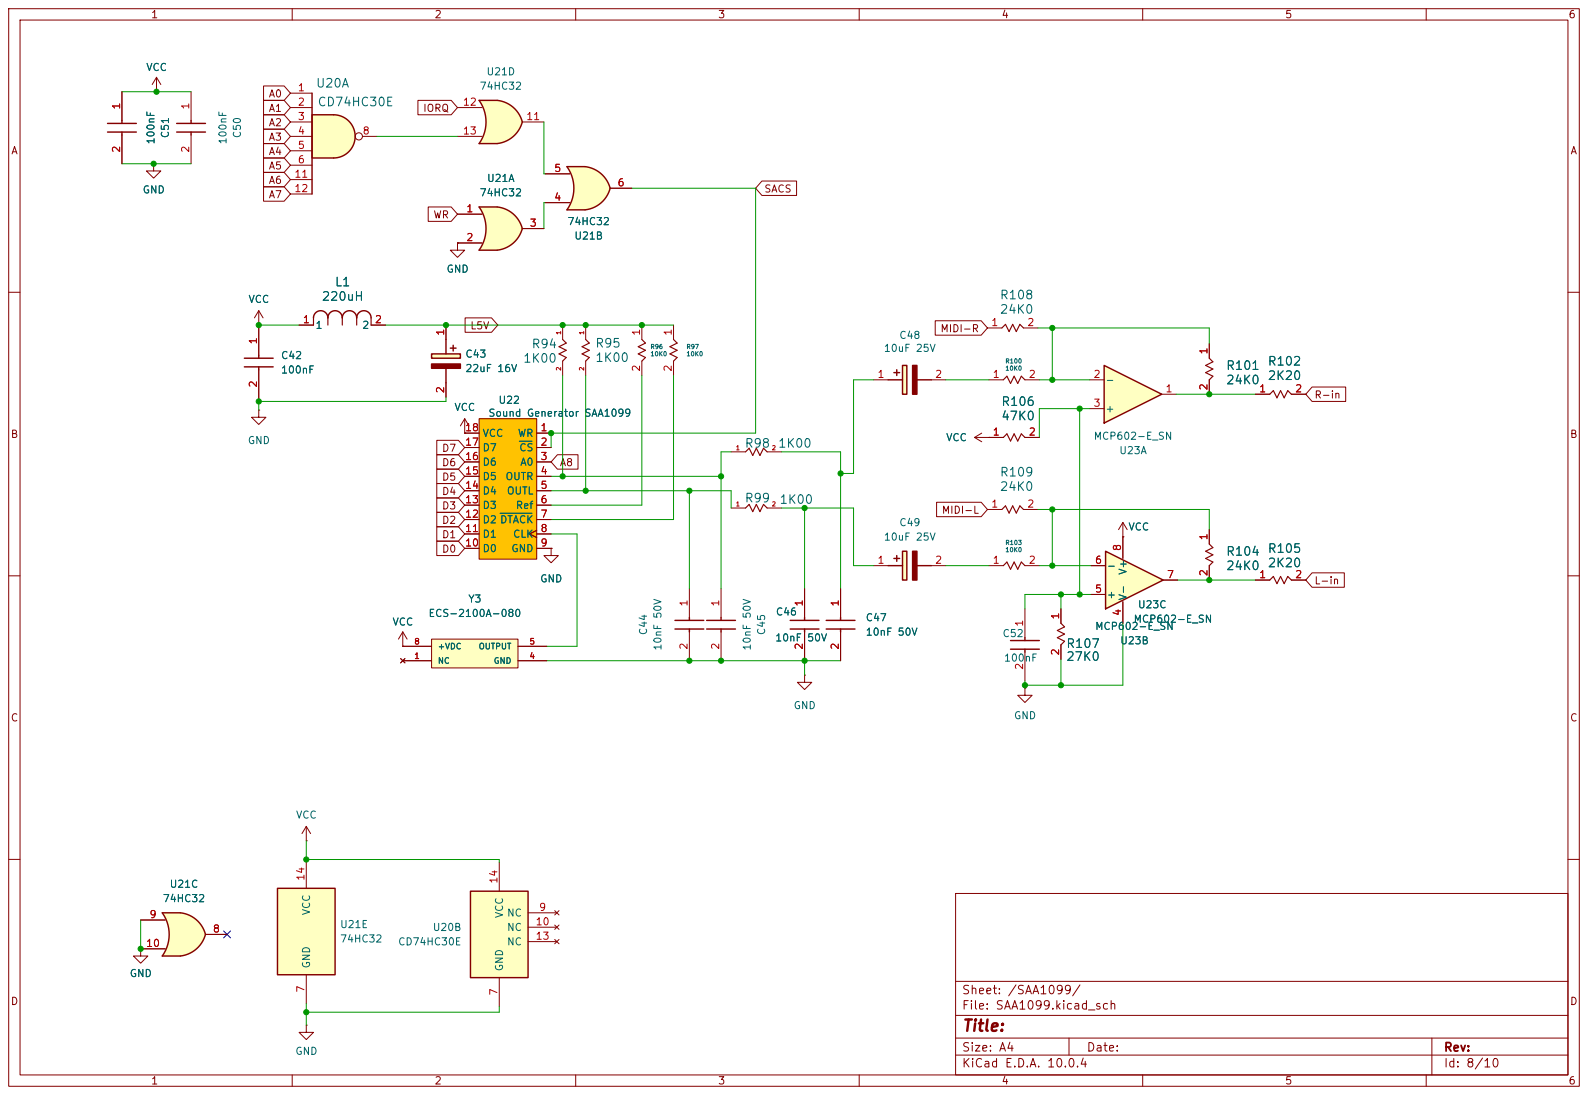
[picture p57: page 8]

7 NC 9 NC 10 NC 13 VCC 14 U20B

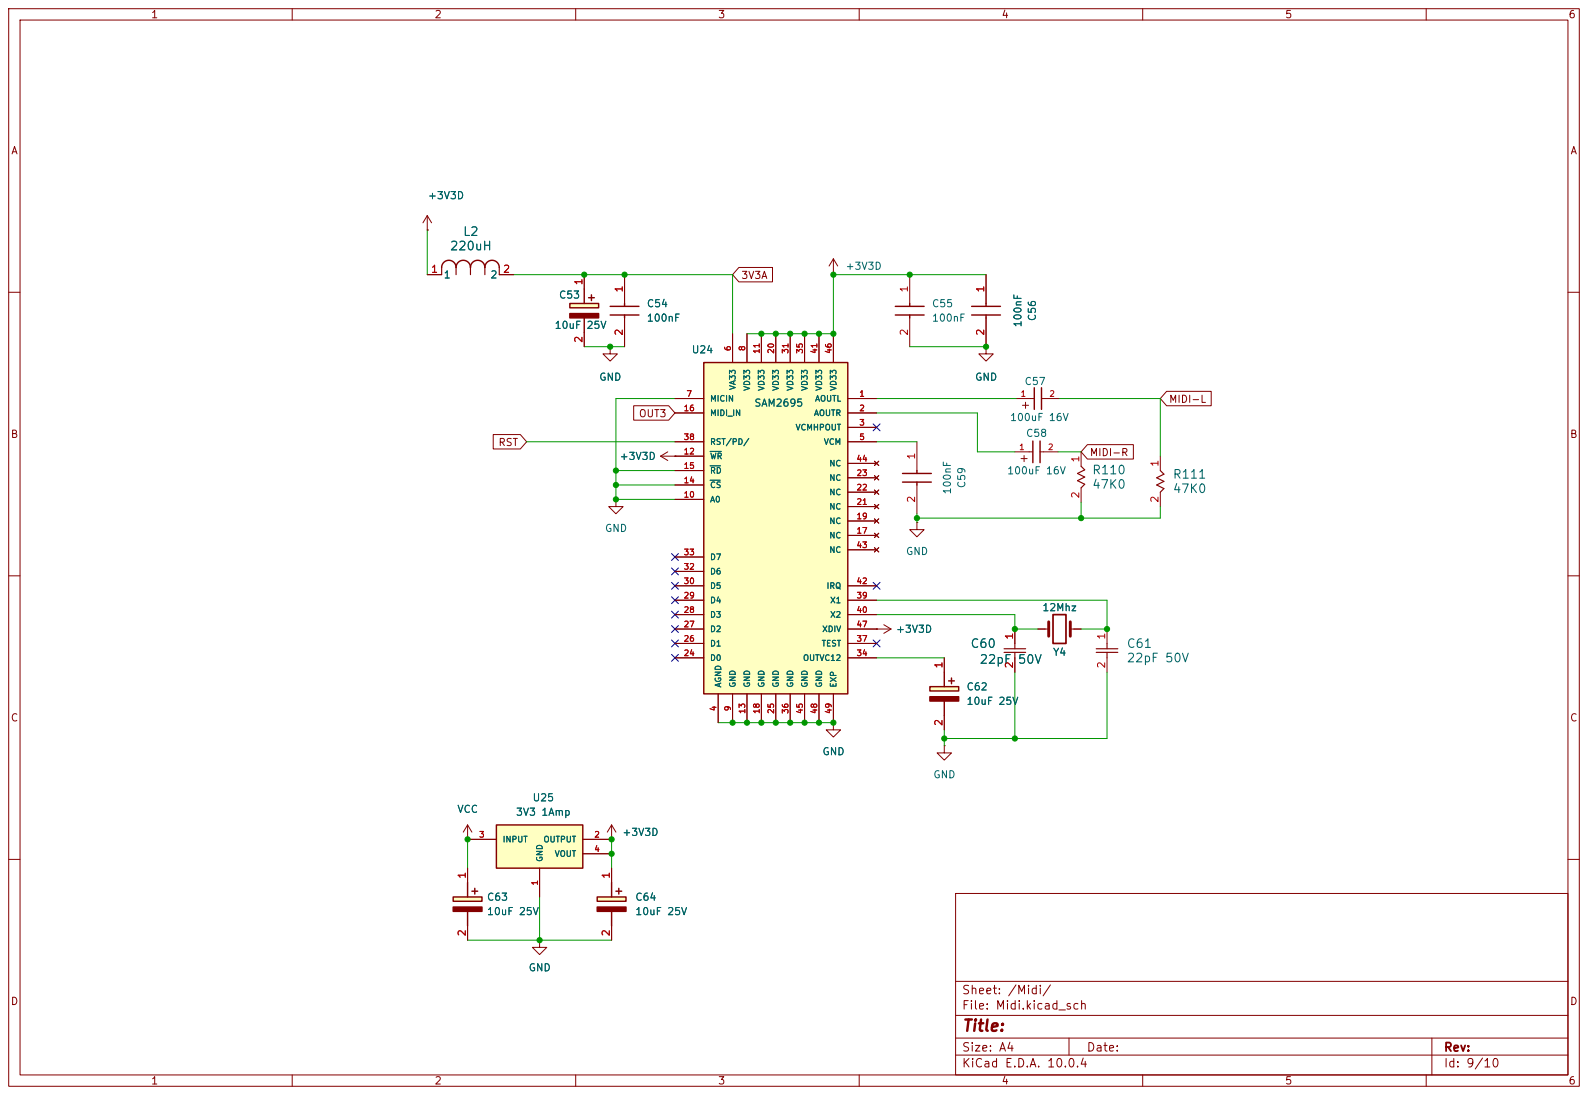
[picture p58: page 9]

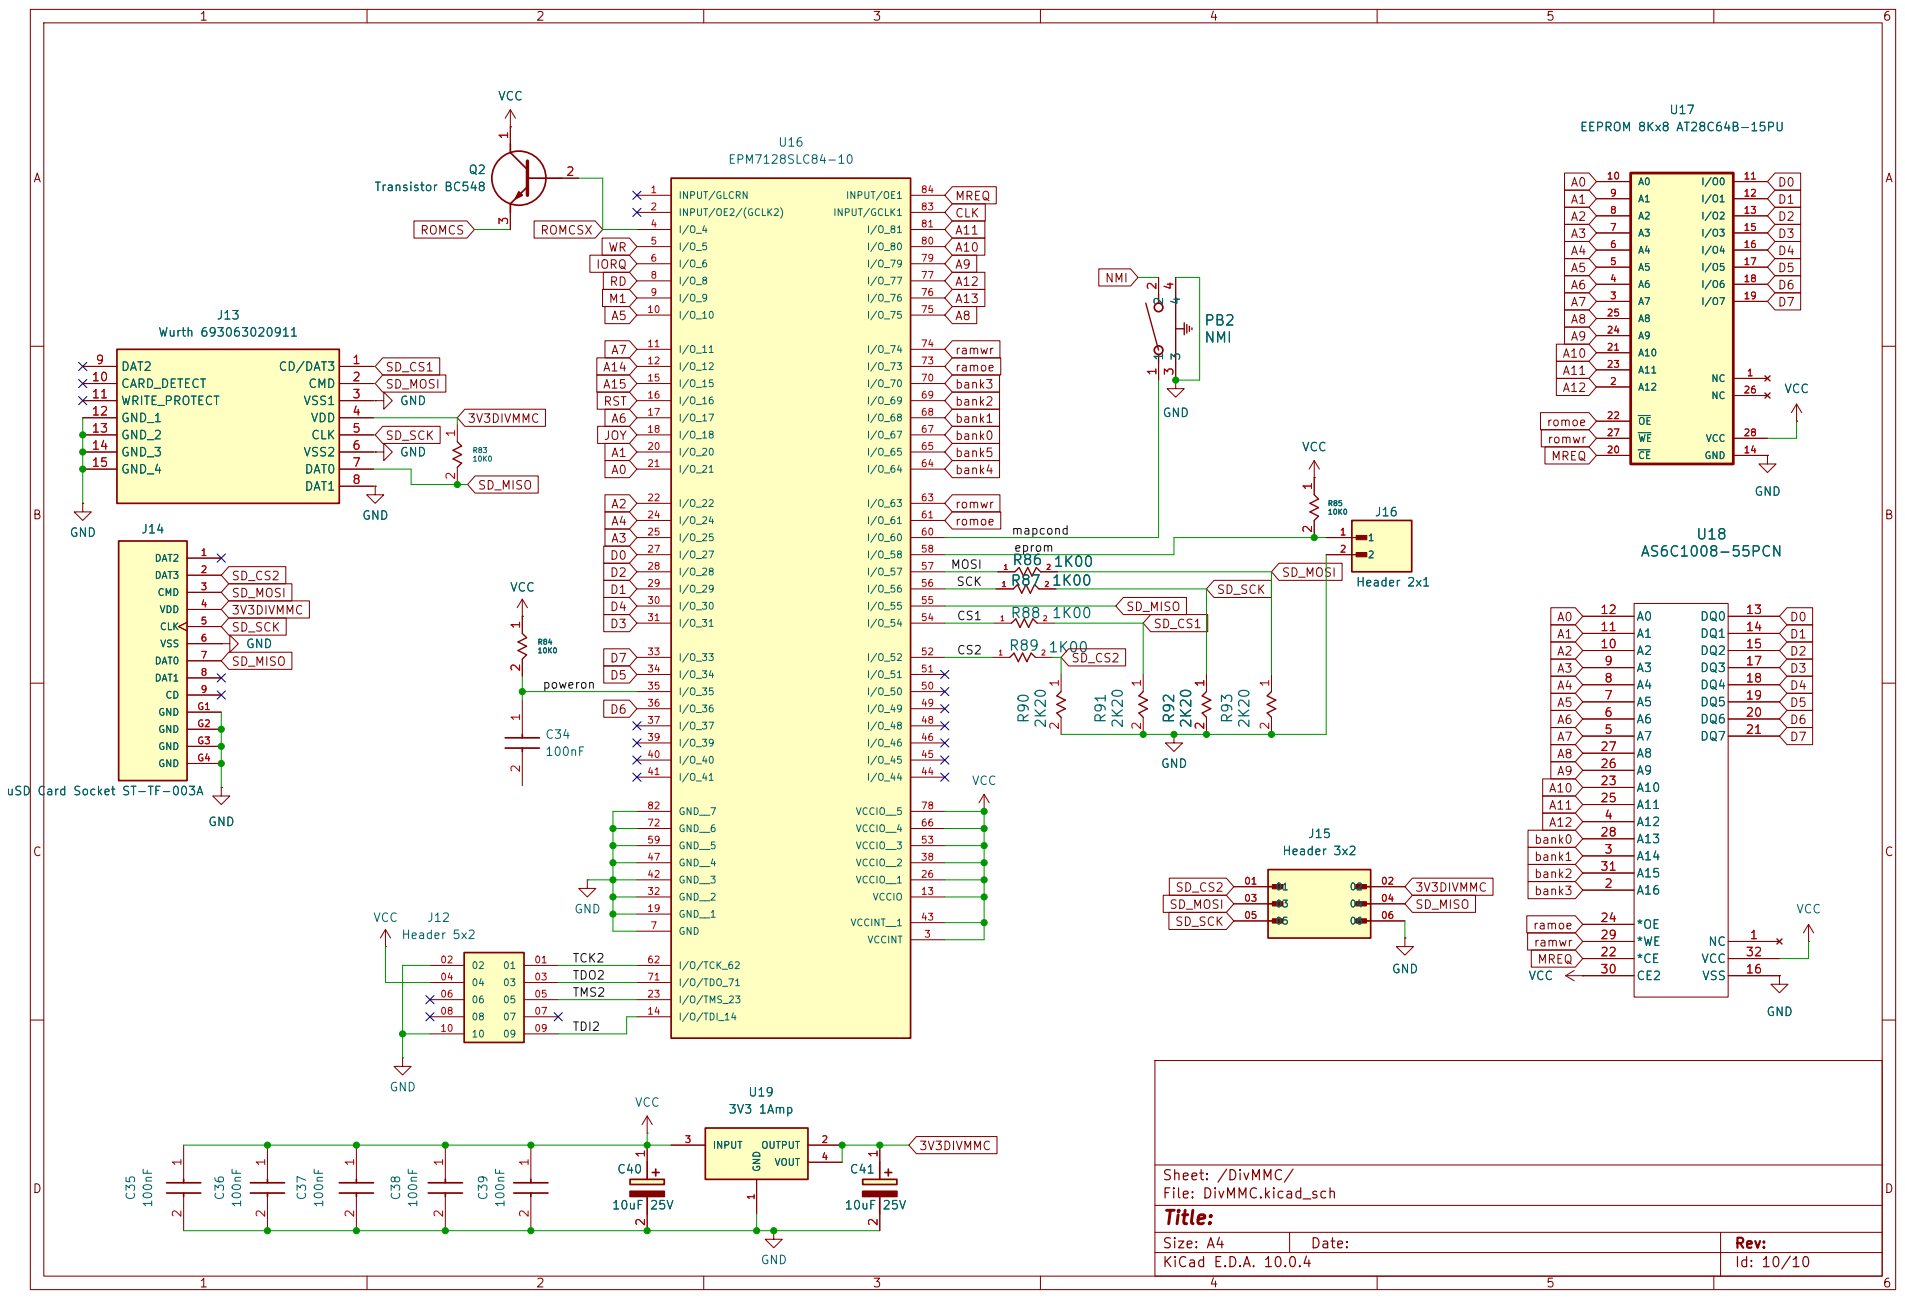
[picture p59: page 10]

uSD Card Socket ST-TF-003A
