liveboxandy/ZX-Max-128-Issue-5/ZX Max 128 Issue 5 PCB.kicad_pcb

## KiCad design ZX Max 128 Issue 5 PCB.kicad_pcb (2026-07-04)

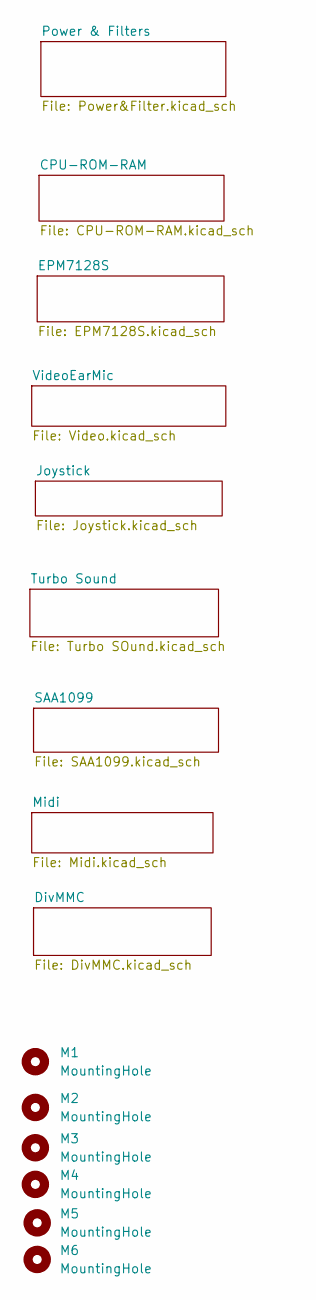
[picture p60: schematic ZX Max 128 Issue 5 PCB.kicad_sch]

Parts:
M1, M2, M3, M4, M5, M6: MountingHole; MountingHole_3.2mm_M3_DIN965

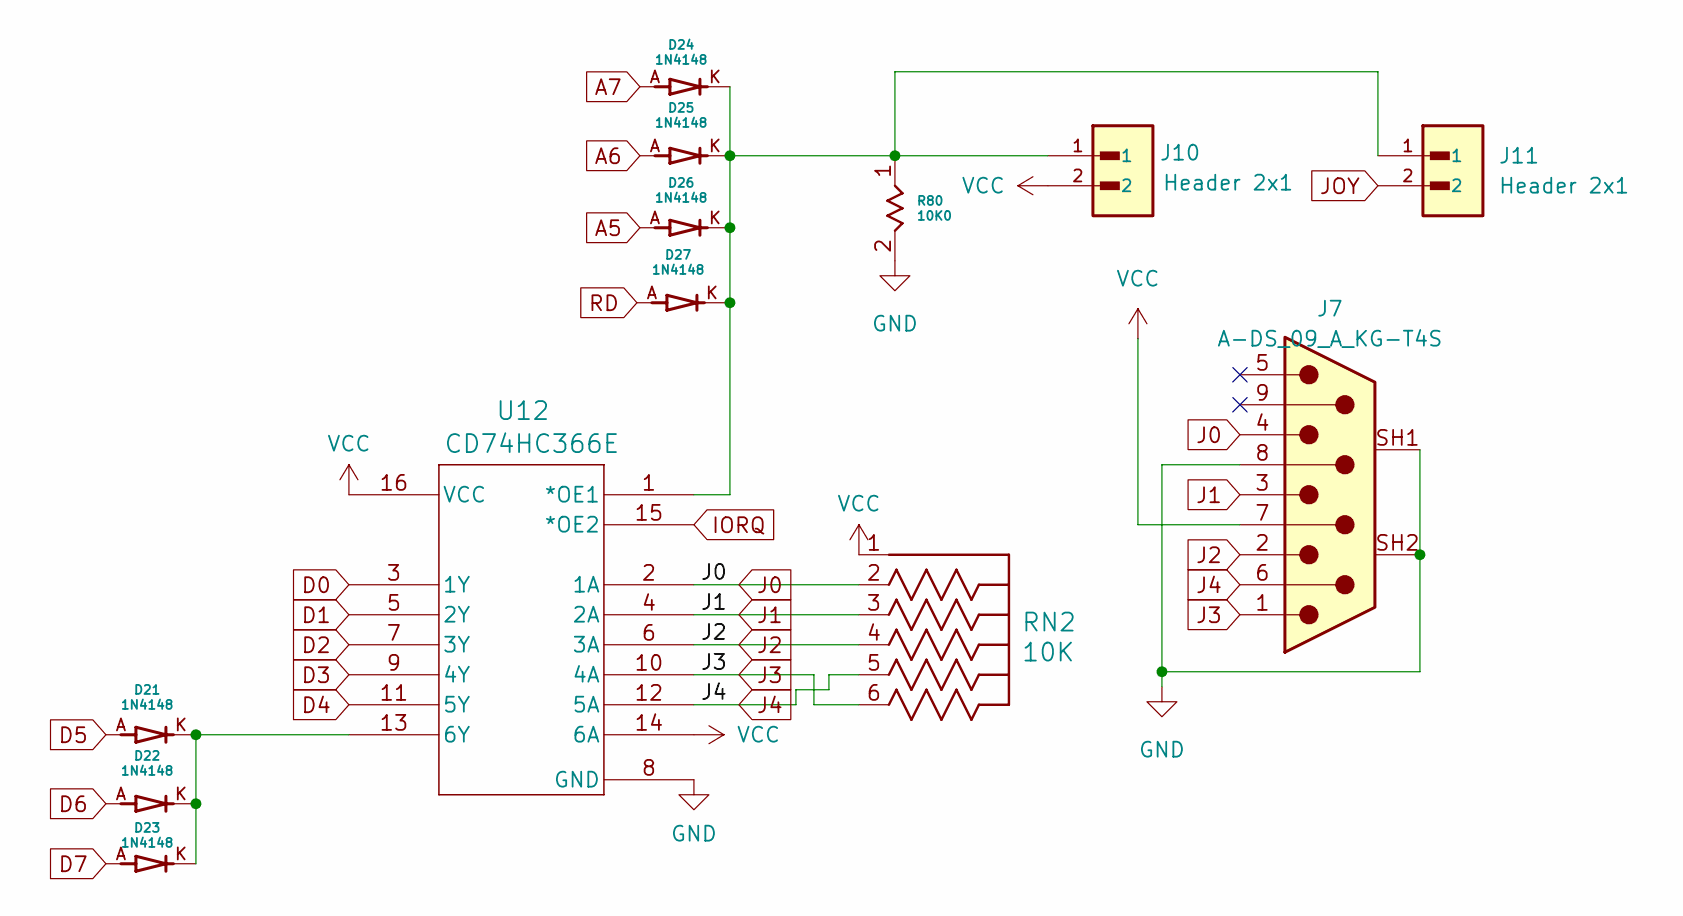
[picture p61: schematic Joystick.kicad_sch]

Parts:
D21, D22, D23, D24, D25, D26, D27: 1N4148; DIOAD753W49L380D172B; PARTREV 5
J7: A-DS_09_A_KG-T4S; ASSMANN_A-DS_09_A_KG-T4S; PARTREV 10
J10, J11: Header 2x1; HARWIN_M20-9990246; PARTREV 14
R80: 10K0; STA_CF14_STP
RN2: 10K; 4606X-101-103LF
U12: CD74HC366E

Connections:
A5: D26.A; also elsewhere on the board
A6: D25.A; also elsewhere on the board
A7: D24.A; also elsewhere on the board
D0: U12.3 (1Y); also elsewhere on the board
D1: U12.5 (2Y); also elsewhere on the board
D2: U12.7 (3Y); also elsewhere on the board
D3: U12.9 (4Y); also elsewhere on the board
D4: U12.11 (5Y); also elsewhere on the board
D5: D21.A; also elsewhere on the board
D6: D22.A; also elsewhere on the board
D7: D23.A; also elsewhere on the board
GND: J7.8, J7.SH1, J7.SH2, R80.2, U12.8 (GND); also elsewhere on the board
IORQ: U12.15 (*OE2); also elsewhere on the board
J0: J7.4, RN2.2, U12.2 (1A)
J1: J7.3, RN2.3, U12.4 (2A)
J2: J7.2, RN2.4, U12.6 (3A)
J3: J7.1, RN2.6, U12.10 (4A)
J4: J7.6, RN2.5, U12.12 (5A)
JOY: J11.2; also elsewhere on the board
unnamed: D21.K, D22.K, D23.K, U12.13 (6Y)
unnamed: D24.K, D25.K, D26.K, D27.K, J10.1, J11.1, R80.1, U12.1 (*OE1)
RD: D27.A; also elsewhere on the board
VCC: J7.7, J10.2, RN2.1, U12.14 (6A), U12.16 (VCC); also elsewhere on the board

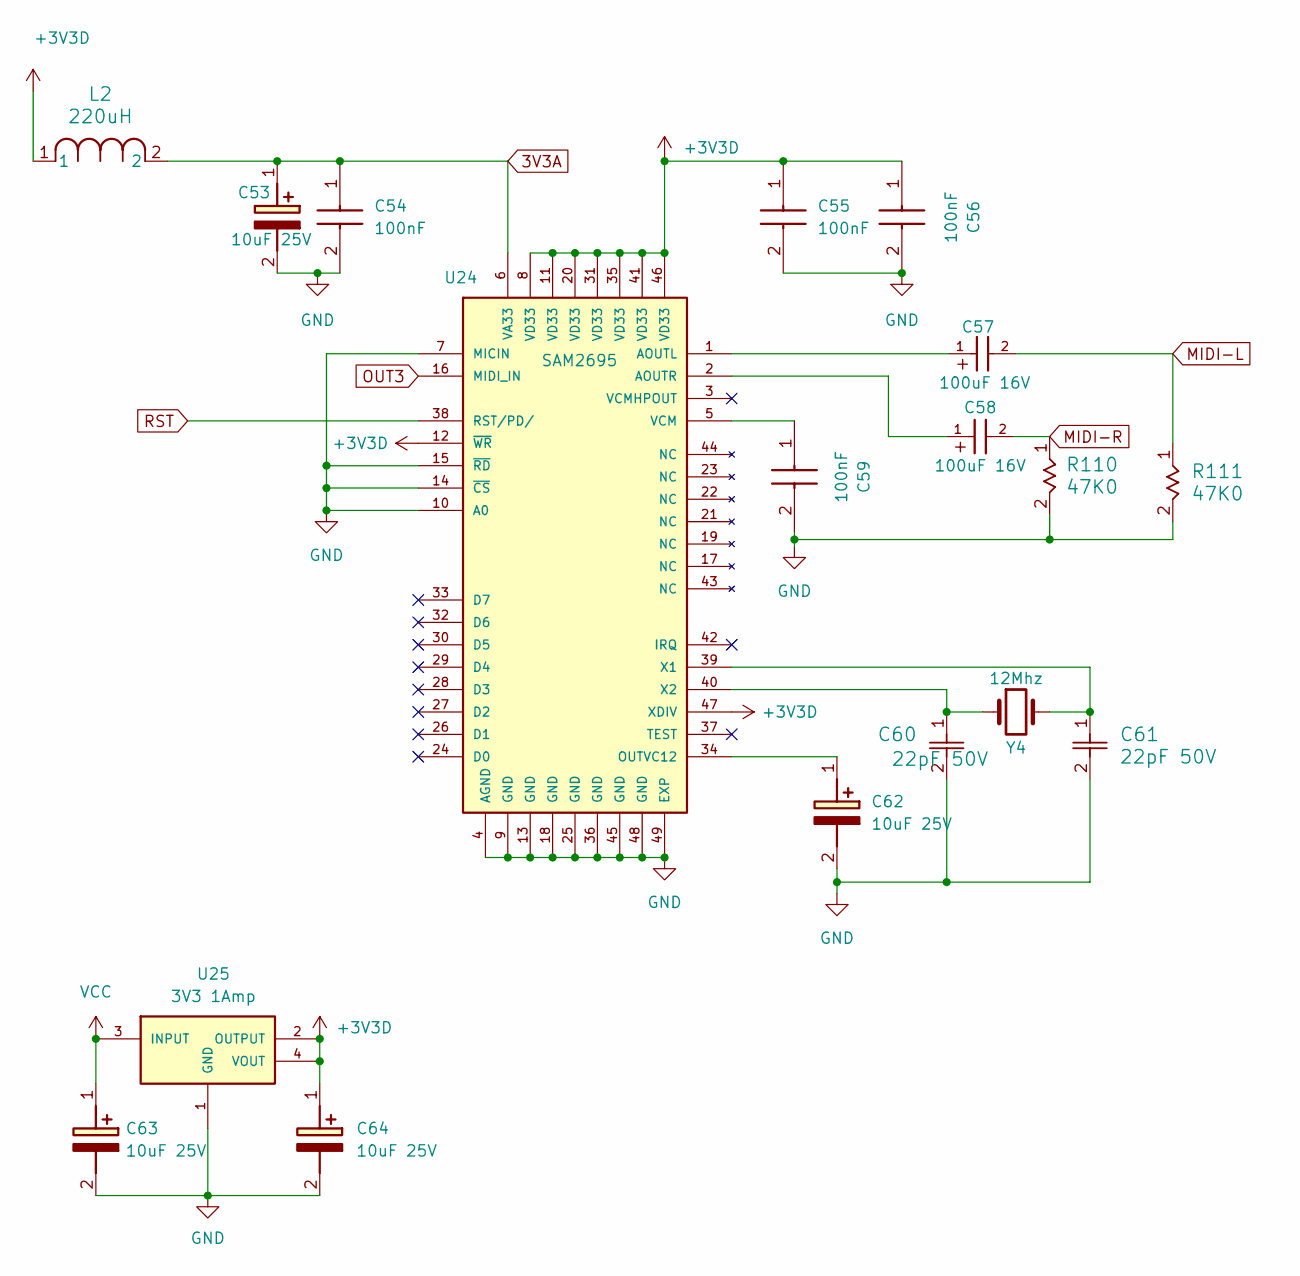
[picture p62: schematic Midi.kicad_sch]

Parts:
C53, C62, C63, C64: 10uF 25V; CAPPRD200W50D500H1100; Mouser Part Number 667-ECA-1EM100B
C54, C55, C56, C59: 100nF; CAPRB250W50L400T250H550; Mouser Part Number 594-K104Z15Y5VF5TL2
C57, C58: 100uF 16V; WCAP-ATG8_5X11_DXL_
C60, C61: 22pF 50V; CAP_K220J15C0GF53L2_VIS
L2: 220uH; IND_BOURNS_RLB0608
R110, R111: 47K0; STA_CF14_STP
U24: SAM2695; QFN40P600X600X90-49N; PARTREV N/A
U25: 3V3 1Amp; SOT230P700X185-4N
Y4: 12Mhz; Crystal_HC49-4H_Vertical

Connections:
3V3A: C53.1 (+), C54.1 (+), L2.2, U24.6 (VA33)
+3V3D: C55.1 (+), C56.1 (+), C64.1 (+), L2.1, U24.8 (VD33), U24.11 (VD33), U24.12 (~WR), U24.20 (VD33), U24.31 (VD33), U24.35 (VD33), U24.41 (VD33), U24.46 (VD33), U24.47 (XDIV), U25.2 (OUTPUT), U25.4 (VOUT); also elsewhere on the board
GND: C53.2 (-), C54.2 (-), C55.2 (-), C56.2 (-), C59.2 (-), C60.2, C61.2, C62.2 (-), C63.2 (-), C64.2 (-), R110.2, R111.2, U24.4 (AGND), U24.7 (MICIN), U24.9 (GND), U24.10 (A0), U24.13 (GND), U24.14 (~CS), U24.15 (~RD), U24.18 (GND), U24.25 (GND), U24.36 (GND), U24.45 (GND), U24.48 (GND), U24.49 (EXP), U25.1 (GND); also elsewhere on the board
MIDI-L: C57.2, R111.1; also elsewhere on the board
MIDI-R: C58.2, R110.1; also elsewhere on the board
unnamed: C59.1 (+), U24.5 (VCM)
unnamed: C62.1 (+), U24.34 (OUTVC12)
unnamed: C57.1, U24.1 (AOUTL)
unnamed: C58.1, U24.2 (AOUTR)
unnamed: C61.1, U24.39 (X1), Y4.2
unnamed: C60.1, U24.40 (X2), Y4.1
OUT3: U24.16 (MIDI_IN); also elsewhere on the board
RST: U24.38 (RST/PD/); also elsewhere on the board
VCC: C63.1 (+), U25.3 (INPUT); also elsewhere on the board

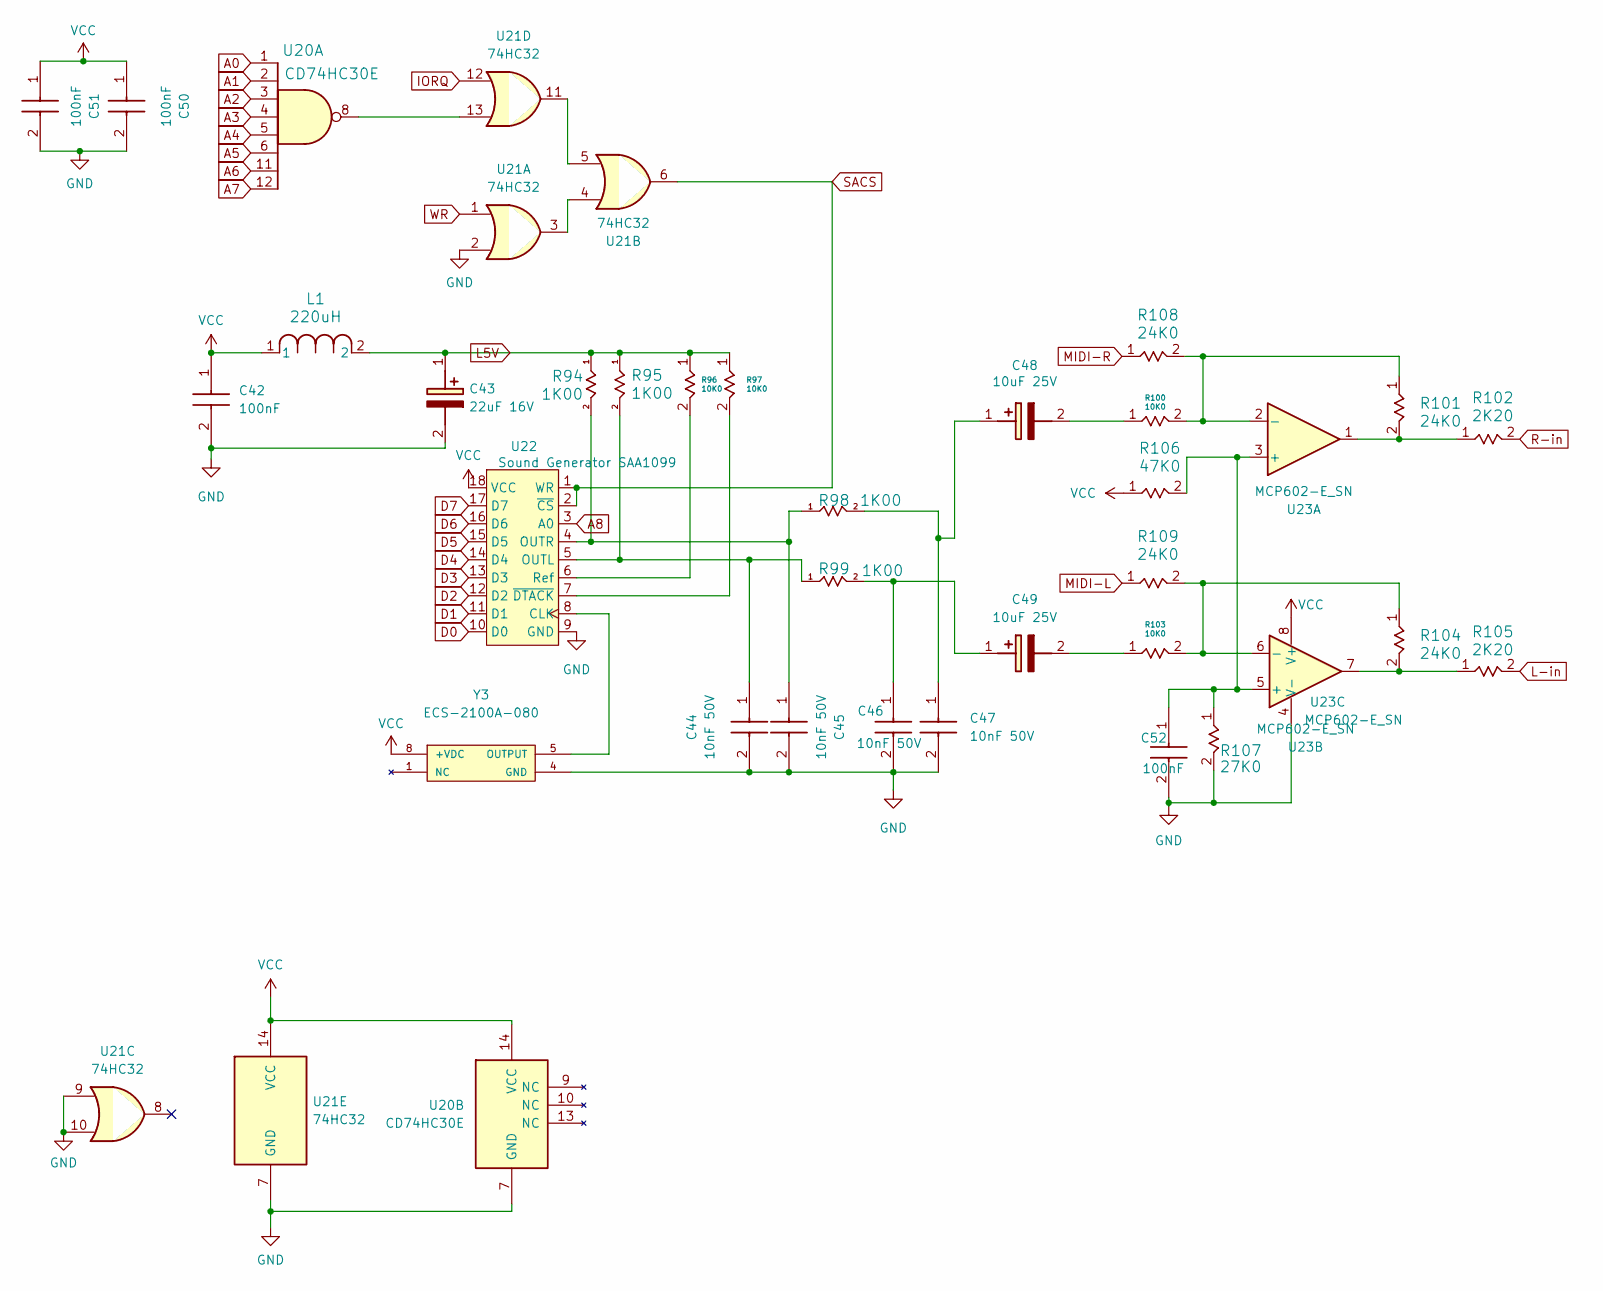
[picture p63: schematic SAA1099.kicad_sch]

Parts:
C42, C50, C51, C52: 100nF; CAPRB250W50L400T250H550; Mouser Part Number 594-K104Z15Y5VF5TL2
C43: 22uF 16V; CAPPRD200W50D500H1100; Mouser Part Number 667-ECA-1EM100B
C44, C45, C46, C47: 10nF 50V; CAPRB250W50L400T250H550; Mouser Part Number 594-K104Z15Y5VF5TL2
C48, C49: 10uF 25V; CAPPRD200W50D500H1100; Mouser Part Number 667-ECA-1EM100B
L1: 220uH; IND_BOURNS_RLB0608
R94, R95, R98, R99: 1K00; STA_CF14_STP
R96, R97, R100, R103: 10K0; STA_CF14_STP
R101, R104, R108, R109: 24K0; STA_CF14_STP
R102, R105: 2K20; STA_CF14_STP
R106: 47K0; STA_CF14_STP
R107: 27K0; STA_CF14_STP
U20: CD74HC30E; DIP794W53P254L1930H508Q14N
U21: 74HC32; DIP794W53P254L1930H508Q14N
U22: Sound Generator SAA1099; DIP-18_W7.62mm_Socket
U23: MCP602-E_SN; DIP787W46P254L927H533Q8
Y3: ECS-2100A-080; OSC_ECS-2100A-080; PARTREV N/A

Connections:
A0: U20.1; also elsewhere on the board
A1: U20.2; also elsewhere on the board
A2: U20.3; also elsewhere on the board
A3: U20.4; also elsewhere on the board
A4: U20.5; also elsewhere on the board
A5: U20.6; also elsewhere on the board
A6: U20.11; also elsewhere on the board
A7: U20.12; also elsewhere on the board
A8: U22.3 (A0); also elsewhere on the board
D0: U22.10 (D0); also elsewhere on the board
D1: U22.11 (D1); also elsewhere on the board
D2: U22.12 (D2); also elsewhere on the board
D3: U22.13 (D3); also elsewhere on the board
D4: U22.14 (D4); also elsewhere on the board
D5: U22.15 (D5); also elsewhere on the board
D6: U22.16 (D6); also elsewhere on the board
D7: U22.17 (D7); also elsewhere on the board
GND: C42.2 (-), C43.2 (-), C44.2 (-), C45.2 (-), C46.2 (-), C47.2 (-), C50.2 (-), C51.2 (-), C52.2 (-), R107.2, U20.7 (GND), U21.2, U21.7 (GND), U21.9, U21.10, U22.9 (GND), U23.4 (V-), Y3.4 (GND); also elsewhere on the board
IORQ: U21.12; also elsewhere on the board
L5V: C43.1 (+), L1.2, R94.1, R95.1, R96.1, R97.1
L-in: R105.2; also elsewhere on the board
MIDI-L: R109.1; also elsewhere on the board
MIDI-R: R108.1; also elsewhere on the board
unnamed: C44.1 (+), R95.2, R99.1, U22.5 (OUTL)
unnamed: C45.1 (+), R94.2, R98.1, U22.4 (OUTR)
unnamed: C46.1 (+), C49.1 (+), R99.2
unnamed: C47.1 (+), C48.1 (+), R98.2
unnamed: C48.2 (-), R100.1
unnamed: C49.2 (-), R103.1
unnamed: C52.1 (+), R106.2, R107.1, U23.3 (+), U23.5 (+)
unnamed: R101.2, R102.1, U23.1
unnamed: R104.2, R105.1, U23.7
unnamed: U20.8, U21.13
unnamed: U21.3, U21.4
unnamed: U21.5, U21.11
unnamed: U22.8 (CLK), Y3.5 (OUTPUT)
unnamed: R96.2, U22.6 (Ref)
unnamed: R97.2, U22.7 (~DTACK)
unnamed: R100.2, R101.1, R108.2, U23.2 (-)
unnamed: R103.2, R104.1, R109.2, U23.6 (-)
R-in: R102.2; also elsewhere on the board
SACS: U21.6, U22.1 (WR), U22.2 (~CS)
VCC: C42.1 (+), C50.1 (+), C51.1 (+), L1.1, R106.1, U20.14 (VCC), U21.14 (VCC), U22.18 (VCC), U23.8 (V+), Y3.8 (+VDC); also elsewhere on the board
WR: U21.1; also elsewhere on the board

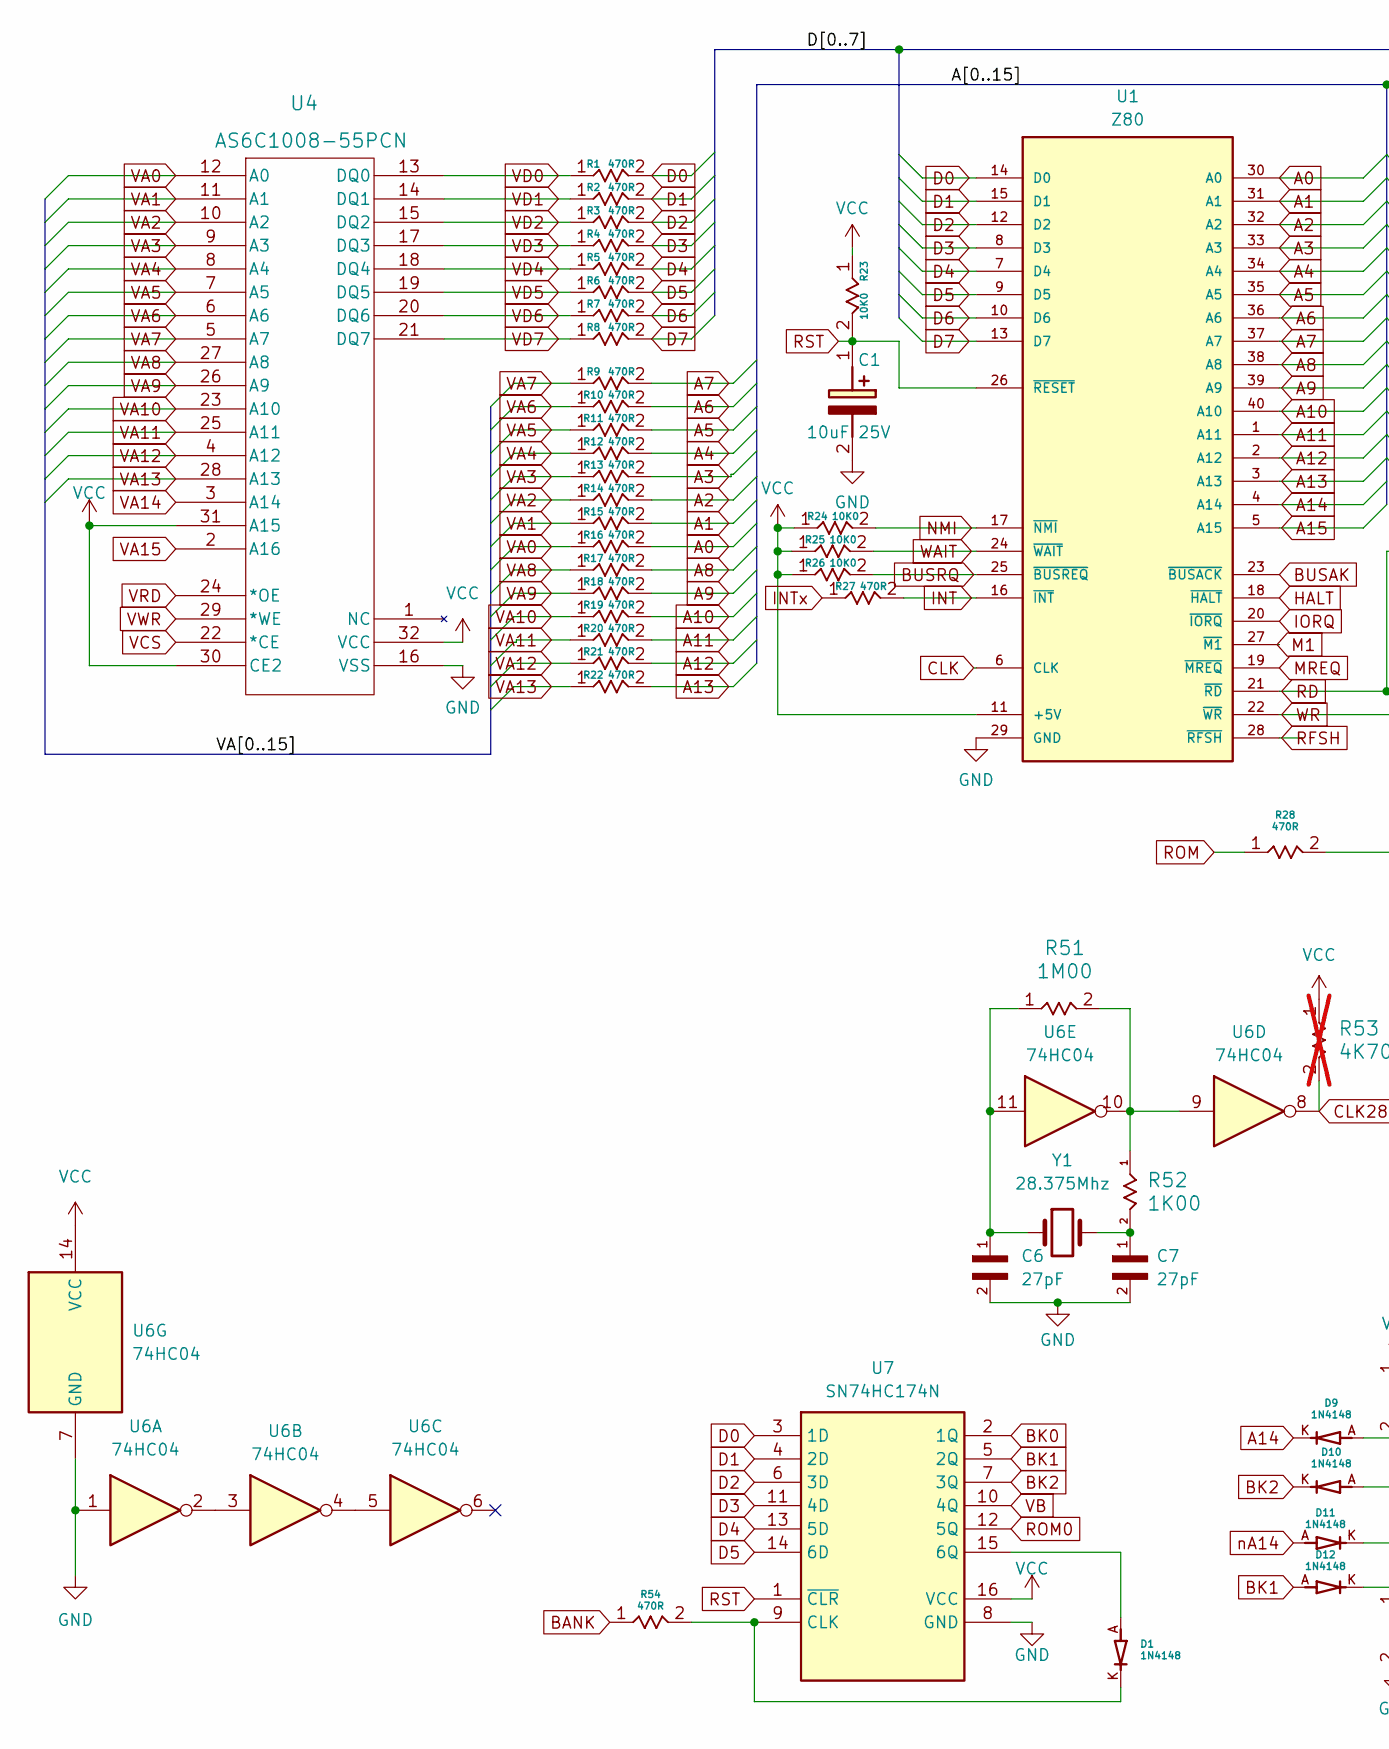
[picture p64: schematic CPU-ROM-RAM.kicad_sch, part in row 1, column 1]

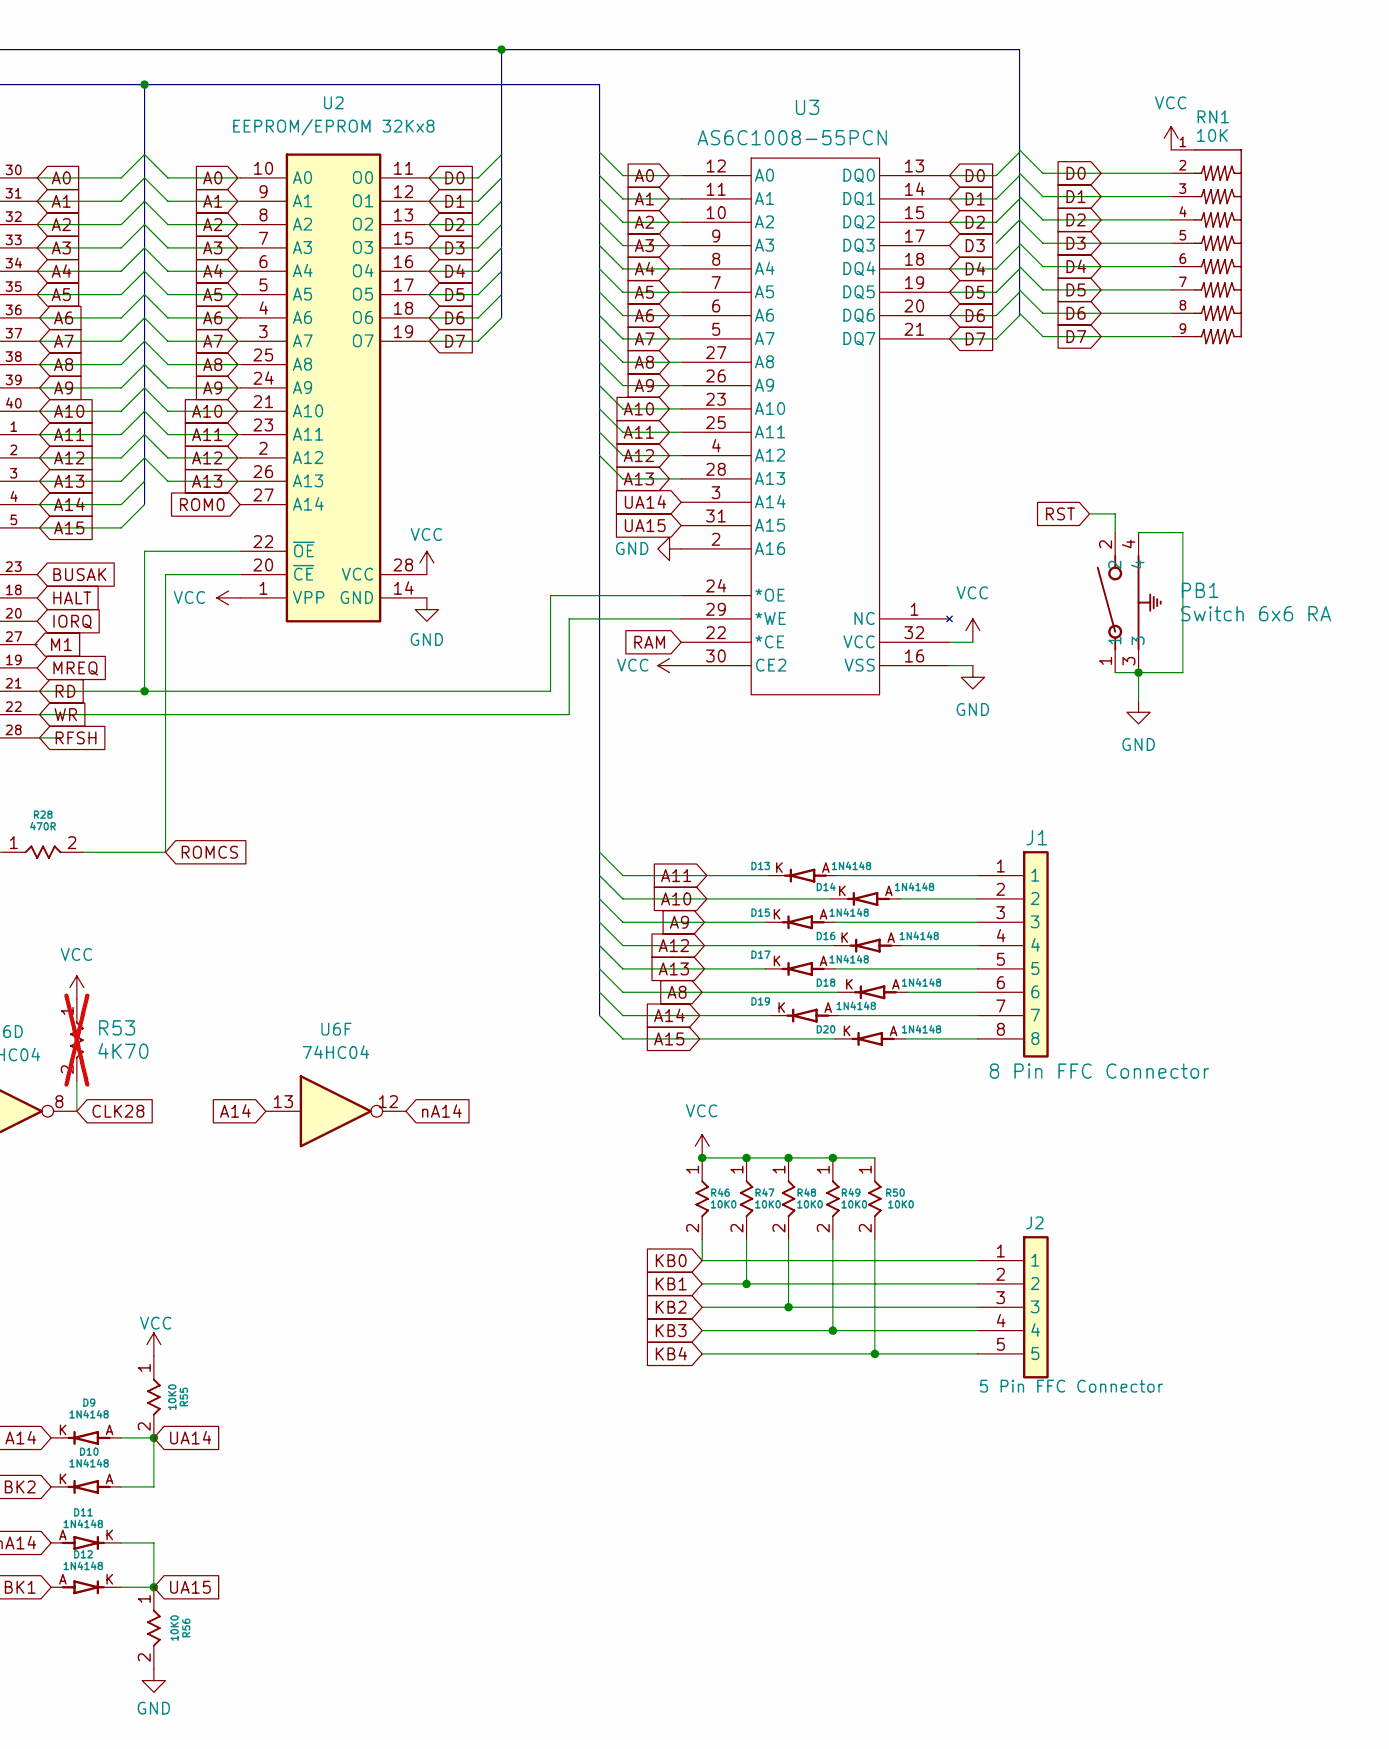
[picture p65: schematic CPU-ROM-RAM.kicad_sch, part in row 1, column 2]

Parts:
C1: 10uF 25V; CAPPRD200W50D500H1100; Mouser Part Number 667-ECA-1EM100B
C6, C7: 27pF; CAPRB250W50L400T250H550; PARTREV 20200310
D1, D9, D10, D11, D12, D13, D14, D15, D16, D17, D18, D19, D20: 1N4148; DIOAD753W49L380D172B; PARTREV 5
J1: 8 Pin FFC Connector; 55203155
J2: 5 Pin FFC Connector; 55203155; Mouser Part Number 571-5-520315-5
PB1: Switch 6x6 RA; SW2_1825027-G_TEC
R1, R2, R3, R4, R5, R6, R7, R8, R9, R10, R11, R12, R13, R14, R15, R16, R17, R18, R19, R20, R21, R22, R27, R28, R54: 470R; STA_CF14_STP
R23, R24, R25, R26, R46, R47, R48, R49, R50, R55, R56: 10K0; STA_CF14_STP
R51: 1M00; STA_CF14_STP
R52: 1K00; STA_CF14_STP
R53: 4K70; STA_CF14_STP; not fitted
RN1: 10K; SIP249W50P254L2281H508Q9; PARTREV 10/1/20
U1: Z80; Z80_Socket
U2: EEPROM/EPROM 32Kx8; DIP1556W56P254L3702H483Q28N; Mouser Part Number 556-AT27C256R-45PU
U3, U4: AS6C1008-55PCN; PDIP-32_MIL600_ALL
U6: 74HC04; DIP794W53P254L1930H508Q14N
U7: SN74HC174N; DIP794W53P254L1930H508Q16N; Mouser Part Number 595-SN74HC174N
Y1: 28.375Mhz; Crystal_HC49-4H_Vertical

Connections:
A0: R16.2, U1.30 (A0), U2.10 (A0), U3.12 (A0); also elsewhere on the board
A1: R15.2, U1.31 (A1), U2.9 (A1), U3.11 (A1); also elsewhere on the board
A2: R14.2, U1.32 (A2), U2.8 (A2), U3.10 (A2); also elsewhere on the board
A3: R13.2, U1.33 (A3), U2.7 (A3), U3.9 (A3); also elsewhere on the board
A4: R12.2, U1.34 (A4), U2.6 (A4), U3.8 (A4); also elsewhere on the board
A5: R11.2, U1.35 (A5), U2.5 (A5), U3.7 (A5); also elsewhere on the board
A6: R10.2, U1.36 (A6), U2.4 (A6), U3.6 (A6); also elsewhere on the board
A7: R9.2, U1.37 (A7), U2.3 (A7), U3.5 (A7); also elsewhere on the board
A8: D18.K, R17.2, U1.38 (A8), U2.25 (A8), U3.27 (A8); also elsewhere on the board
A9: D15.K, R18.2, U1.39 (A9), U2.24 (A9), U3.26 (A9); also elsewhere on the board
A10: D14.K, R19.2, U1.40 (A10), U2.21 (A10), U3.23 (A10); also elsewhere on the board
A11: D13.K, R20.2, U1.1 (A11), U2.23 (A11), U3.25 (A11); also elsewhere on the board
A12: D16.K, R21.2, U1.2 (A12), U2.2 (A12), U3.4 (A12); also elsewhere on the board
A13: D17.K, R22.2, U1.3 (A13), U2.26 (A13), U3.28 (A13); also elsewhere on the board
A14: D9.K, D19.K, U1.4 (A14), U6.13; also elsewhere on the board
A15: D20.K, U1.5 (A15); also elsewhere on the board
BANK: R54.1; also elsewhere on the board
BK0: U7.2 (1Q); also elsewhere on the board
BK1: D12.A, U7.5 (2Q); also elsewhere on the board
BK2: D10.K, U7.7 (3Q); also elsewhere on the board
BUSAK: U1.23 (~BUSACK); also elsewhere on the board
BUSRQ: R26.2, U1.25 (~BUSREQ); also elsewhere on the board
CLK: U1.6 (CLK); also elsewhere on the board
CLK28: R53.2, U6.8; also elsewhere on the board
D0: R1.2, RN1.2, U1.14 (D0), U2.11 (O0), U3.13 (DQ0), U7.3 (1D); also elsewhere on the board
D1: R2.2, RN1.3, U1.15 (D1), U2.12 (O1), U3.14 (DQ1), U7.4 (2D); also elsewhere on the board
D2: R3.2, RN1.4, U1.12 (D2), U2.13 (O2), U3.15 (DQ2), U7.6 (3D); also elsewhere on the board
D3: R4.2, RN1.5, U1.8 (D3), U2.15 (O3), U3.17 (DQ3), U7.11 (4D); also elsewhere on the board
D4: R5.2, RN1.6, U1.7 (D4), U2.16 (O4), U3.18 (DQ4), U7.13 (5D); also elsewhere on the board
D5: R6.2, RN1.7, U1.9 (D5), U2.17 (O5), U3.19 (DQ5), U7.14 (6D); also elsewhere on the board
D6: R7.2, RN1.8, U1.10 (D6), U2.18 (O6), U3.20 (DQ6); also elsewhere on the board
D7: R8.2, RN1.9, U1.13 (D7), U2.19 (O7), U3.21 (DQ7); also elsewhere on the board
GND: C1.2 (-), C6.2, C7.2, PB1.1, PB1.3, PB1.4, R56.2, U1.29 (GND), U2.14 (GND), U3.2 (A16), U3.16 (VSS), U4.16 (VSS), U6.1, U6.7 (GND), U7.8 (GND); also elsewhere on the board
HALT: U1.18 (~HALT); also elsewhere on the board
INT: R27.2, U1.16 (~INT); also elsewhere on the board
INTx: R27.1; also elsewhere on the board
IORQ: U1.20 (~IORQ); also elsewhere on the board
KB0: J2.1, R46.2; also elsewhere on the board
KB1: J2.2, R47.2; also elsewhere on the board
KB2: J2.3, R48.2; also elsewhere on the board
KB3: J2.4, R49.2; also elsewhere on the board
KB4: J2.5, R50.2; also elsewhere on the board
M1: U1.27 (~M1); also elsewhere on the board
MREQ: U1.19 (~MREQ); also elsewhere on the board
NMI: R24.2, U1.17 (~NMI); also elsewhere on the board
unnamed: C6.1, R51.1, U6.11, Y1.1
unnamed: C7.1, R52.2, Y1.2
unnamed: D13.A, J1.1
unnamed: D14.A, J1.2
unnamed: D15.A, J1.3
unnamed: D16.A, J1.4
unnamed: D17.A, J1.5
unnamed: D18.A, J1.6
unnamed: D19.A, J1.7
unnamed: D20.A, J1.8
unnamed: R51.2, R52.1, U6.9, U6.10
unnamed: U6.2, U6.3
unnamed: U6.4, U6.5
unnamed: D1.A, U7.15 (6Q)
unnamed: D1.K, R54.2, U7.9 (CLK)
RAM: U3.22 (*CE); also elsewhere on the board
RD: U1.21 (~RD), U2.22 (~OE), U3.24 (*OE); also elsewhere on the board
RFSH: U1.28 (~RFSH); also elsewhere on the board
ROM: R28.1; also elsewhere on the board
ROM0: U2.27 (A14), U7.12 (5Q)
ROMCS: R28.2, U2.20 (~CE); also elsewhere on the board
RST: C1.1 (+), PB1.2, R23.2, U1.26 (~RESET), U7.1 (~CLR); also elsewhere on the board
UA14: D9.A, D10.A, R55.2, U3.3 (A14)
UA15: D11.K, D12.K, R56.1, U3.31 (A15)
VA0: R16.1, U4.12 (A0); also elsewhere on the board
VA1: R15.1, U4.11 (A1); also elsewhere on the board
VA2: R14.1, U4.10 (A2); also elsewhere on the board
VA3: R13.1, U4.9 (A3); also elsewhere on the board
VA4: R12.1, U4.8 (A4); also elsewhere on the board
VA5: R11.1, U4.7 (A5); also elsewhere on the board
VA6: R10.1, U4.6 (A6); also elsewhere on the board
VA7: R9.1, U4.5 (A7); also elsewhere on the board
VA8: R17.1, U4.27 (A8); also elsewhere on the board
VA9: R18.1, U4.26 (A9); also elsewhere on the board
VA10: R19.1, U4.23 (A10); also elsewhere on the board
VA11: R20.1, U4.25 (A11); also elsewhere on the board
VA12: R21.1, U4.4 (A12); also elsewhere on the board
VA13: R22.1, U4.28 (A13); also elsewhere on the board
VA14: U4.3 (A14); also elsewhere on the board
VA15: U4.2 (A16); also elsewhere on the board
VB: U7.10 (4Q); also elsewhere on the board
VCC: R23.1, R24.1, R25.1, R26.1, R46.1, R47.1, R48.1, R49.1, R50.1, R53.1, R55.1, RN1.1, U1.11 (+5V), U2.1 (VPP), U2.28 (VCC), U3.30 (CE2), U3.32 (VCC), U4.30 (CE2), U4.31 (A15), U4.32 (VCC), U6.14 (VCC), U7.16 (VCC); also elsewhere on the board
VCS: U4.22 (*CE); also elsewhere on the board
VD0: R1.1, U4.13 (DQ0); also elsewhere on the board
VD1: R2.1, U4.14 (DQ1); also elsewhere on the board
VD2: R3.1, U4.15 (DQ2); also elsewhere on the board
VD3: R4.1, U4.17 (DQ3); also elsewhere on the board
VD4: R5.1, U4.18 (DQ4); also elsewhere on the board
VD5: R6.1, U4.19 (DQ5); also elsewhere on the board
VD6: R7.1, U4.20 (DQ6); also elsewhere on the board
VD7: R8.1, U4.21 (DQ7); also elsewhere on the board
VRD: U4.24 (*OE); also elsewhere on the board
VWR: U4.29 (*WE); also elsewhere on the board
WAIT: R25.2, U1.24 (~WAIT); also elsewhere on the board
WR: U1.22 (~WR), U3.29 (*WE); also elsewhere on the board
nA14: D11.A, U6.12

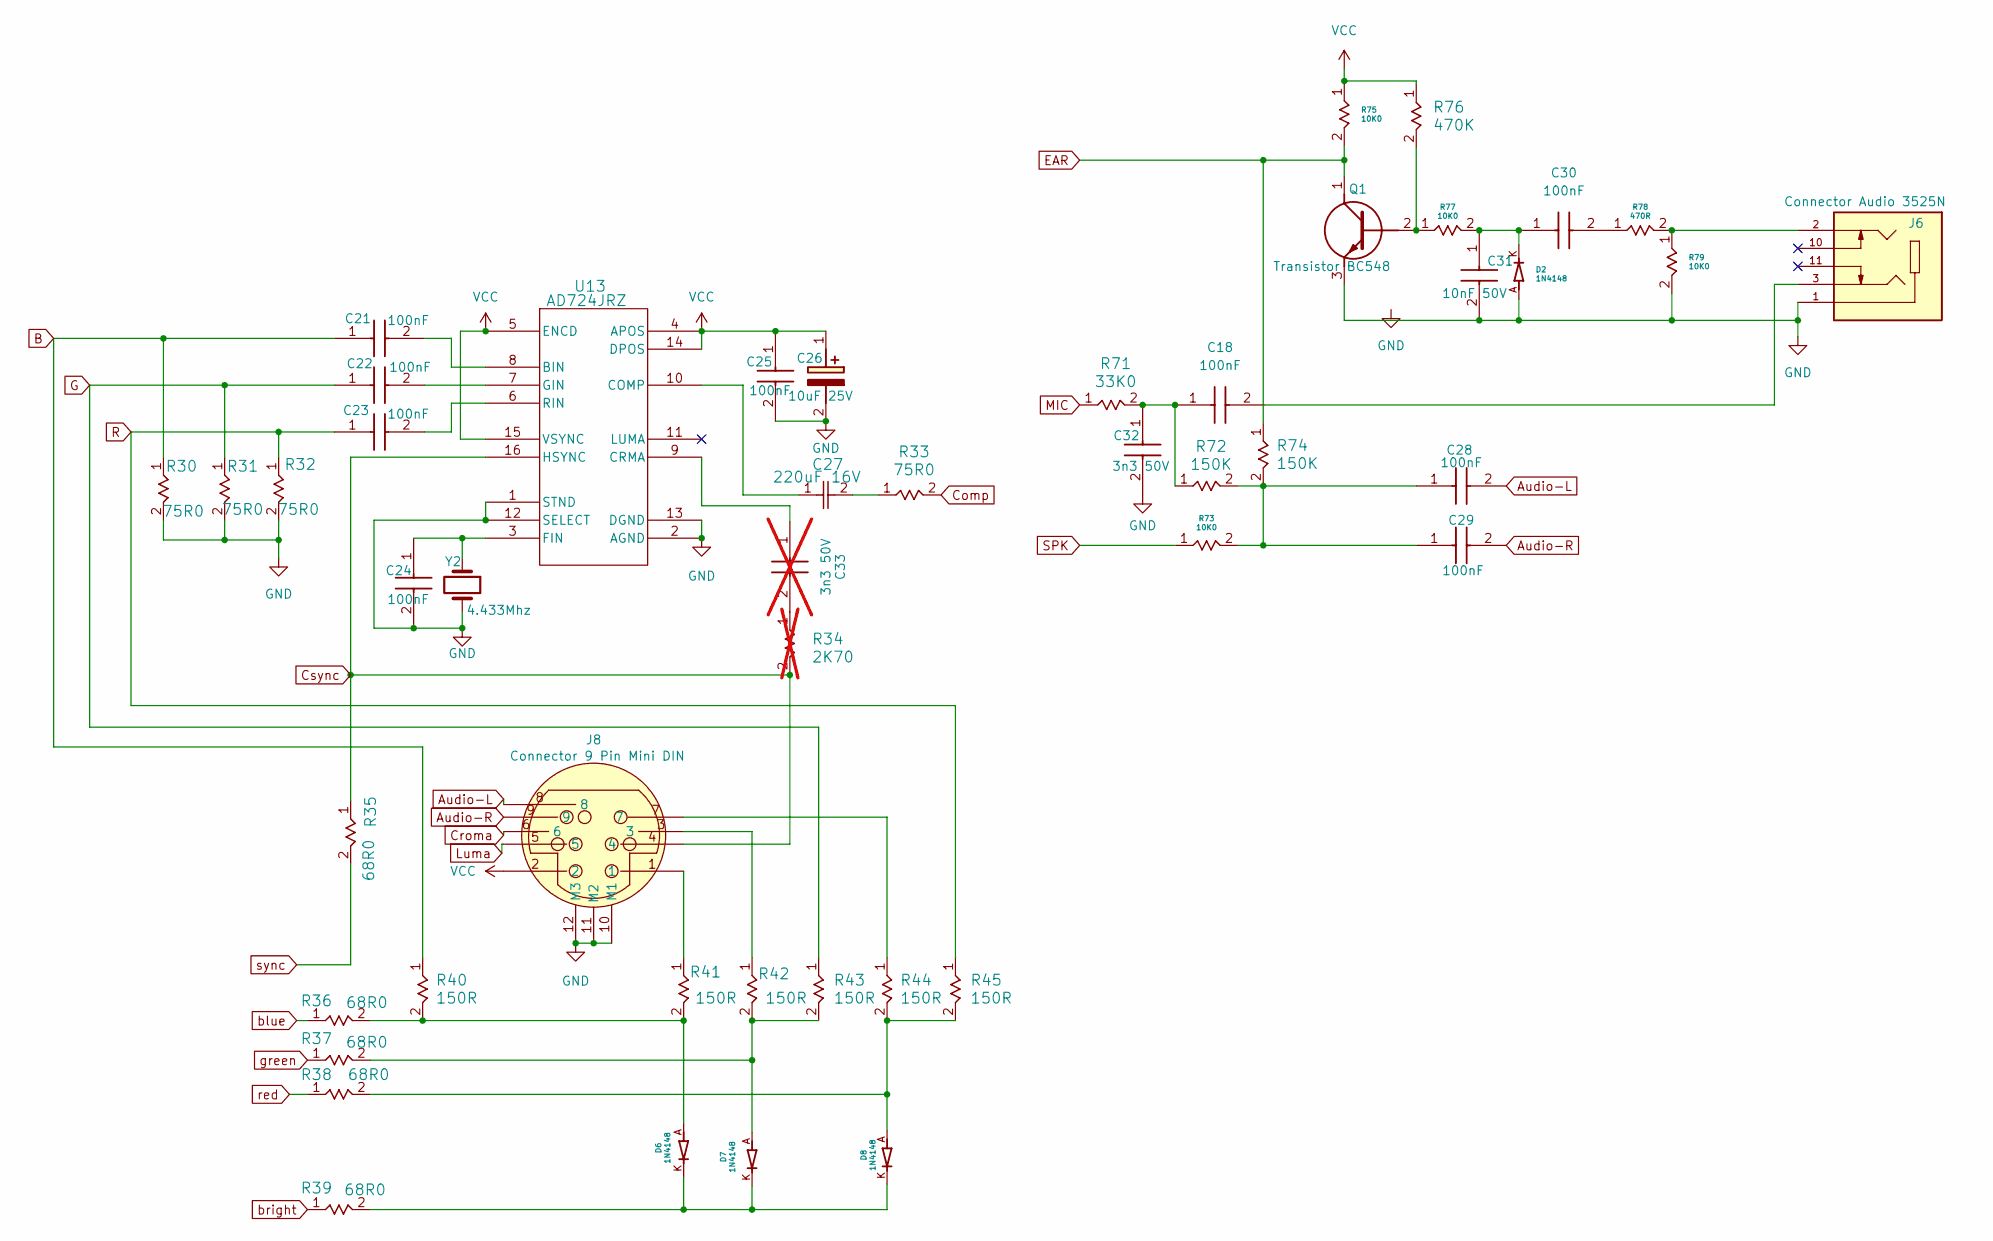
[picture p66: schematic Video.kicad_sch]

Parts:
C18, C21, C22, C23, C24, C25, C28, C29, C30: 100nF; CAPRB250W50L400T250H550; Mouser Part Number 594-K104Z15Y5VF5TL2
C26: 10uF 25V; CAPPRD200W50D500H1100; Mouser Part Number 667-ECA-1EM100B
C27: 220uF 16V; CAPPRD200W50D500H1100
C31: 10nF 50V; CAPRB250W50L400T250H550; Mouser Part Number 594-K104Z15Y5VF5TL2
C32: 3n3 50V; CAPRB250W50L400T250H550; Mouser Part Number 594-K104Z15Y5VF5TL2
C33: 3n3 50V; CAPRB250W50L400T250H550; Mouser Part Number 594-K104Z15Y5VF5TL2; not fitted
D2, D6, D7, D8: 1N4148; DIOAD753W49L380D172B; PARTREV 5
J6: Connector Audio 3525N; CUI_SJ1-3525N
J8: Connector 9 Pin Mini DIN; KMDGX9SBS1
Q1: Transistor BC548; BC548BTA
R30, R31, R32, R33: 75R0; STA_CF14_STP
R34: 2K70; STA_CF14_STP; not fitted
R35, R36, R37, R38, R39: 68R0; STA_CF14_STP
R40, R41, R42, R43, R44, R45: 150R; STA_CF14_STP
R71: 33K0; STA_CF14_STP
R72, R74: 150K; STA_CF14_STP
R73, R75, R77, R79: 10K0; STA_CF14_STP
R76: 470K; STA_CF14_STP
R78: 470R; STA_CF14_STP
U13: AD724JRZ; RW_16_ADI
Y2: 4.433Mhz; Crystal_HC49-4H_Vertical

Connections:
Audio-L: C28.2 (-), J8.8; also elsewhere on the board
Audio-R: C29.2 (-), J8.9; also elsewhere on the board
B: C21.1 (+), R30.1, R40.1
Comp: R33.2; also elsewhere on the board
Croma: J8.6
Csync: J8.4, R34.2, R35.1, U13.16 (HSYNC)
EAR: Q1.1 (C), R74.1, R75.2; also elsewhere on the board
G: C22.1 (+), R31.1, R43.1
GND: C24.2 (-), C25.2 (-), C26.2 (-), C31.2 (-), C32.2 (-), D2.A, J6.1, J8.10 (M1), J8.11 (M2), J8.12 (M3), Q1.3 (E), R30.2, R31.2, R32.2, R79.2, U13.1 (STND), U13.2 (AGND), U13.12 (SELECT), U13.13 (DGND), Y2.2; also elsewhere on the board
Luma: J8.5
MIC: R71.1; also elsewhere on the board
unnamed: C18.1 (+), C32.1 (+), R71.2, R72.1
unnamed: C18.2 (-), J6.3
unnamed: C21.2 (-), U13.8 (BIN)
unnamed: C22.2 (-), U13.7 (GIN)
unnamed: C23.2 (-), U13.6 (RIN)
unnamed: C24.1 (+), U13.3 (FIN), Y2.1
unnamed: C27.2, R33.1
unnamed: C28.1 (+), C29.1 (+), R72.2, R73.2, R74.2
unnamed: C30.1 (+), C31.1 (+), D2.K, R77.2
unnamed: C30.2 (-), R78.1
unnamed: C33.1 (+), U13.9 (CRMA)
unnamed: C33.2 (-), R34.1
unnamed: D6.A, R36.2, R40.2, R41.2
unnamed: D6.K, D7.K, D8.K, R39.2
unnamed: D7.A, R37.2, R42.2, R43.2
unnamed: D8.A, R38.2, R44.2, R45.2
unnamed: J6.2, R78.2, R79.1
unnamed: J8.1, R41.1
unnamed: J8.3, R42.1
unnamed: J8.7, R44.1
unnamed: Q1.2 (B), R76.2, R77.1
unnamed: C27.1, U13.10 (COMP)
R: C23.1 (+), R32.1, R45.1
SPK: R73.1; also elsewhere on the board
VCC: C25.1 (+), C26.1 (+), J8.2, R75.1, R76.1, U13.4 (APOS), U13.5 (ENCD), U13.14 (DPOS), U13.15 (VSYNC); also elsewhere on the board
blue: R36.1; also elsewhere on the board
bright: R39.1; also elsewhere on the board
green: R37.1; also elsewhere on the board
red: R38.1; also elsewhere on the board
sync: R35.2; also elsewhere on the board
