liveboxandy/ZX-Max-128-Issue-5/ZX Max 128 Issue 5 PCB.kicad_pcb

## KiCad design ZX Max 128 Issue 5 PCB.kicad_pcb (continued)

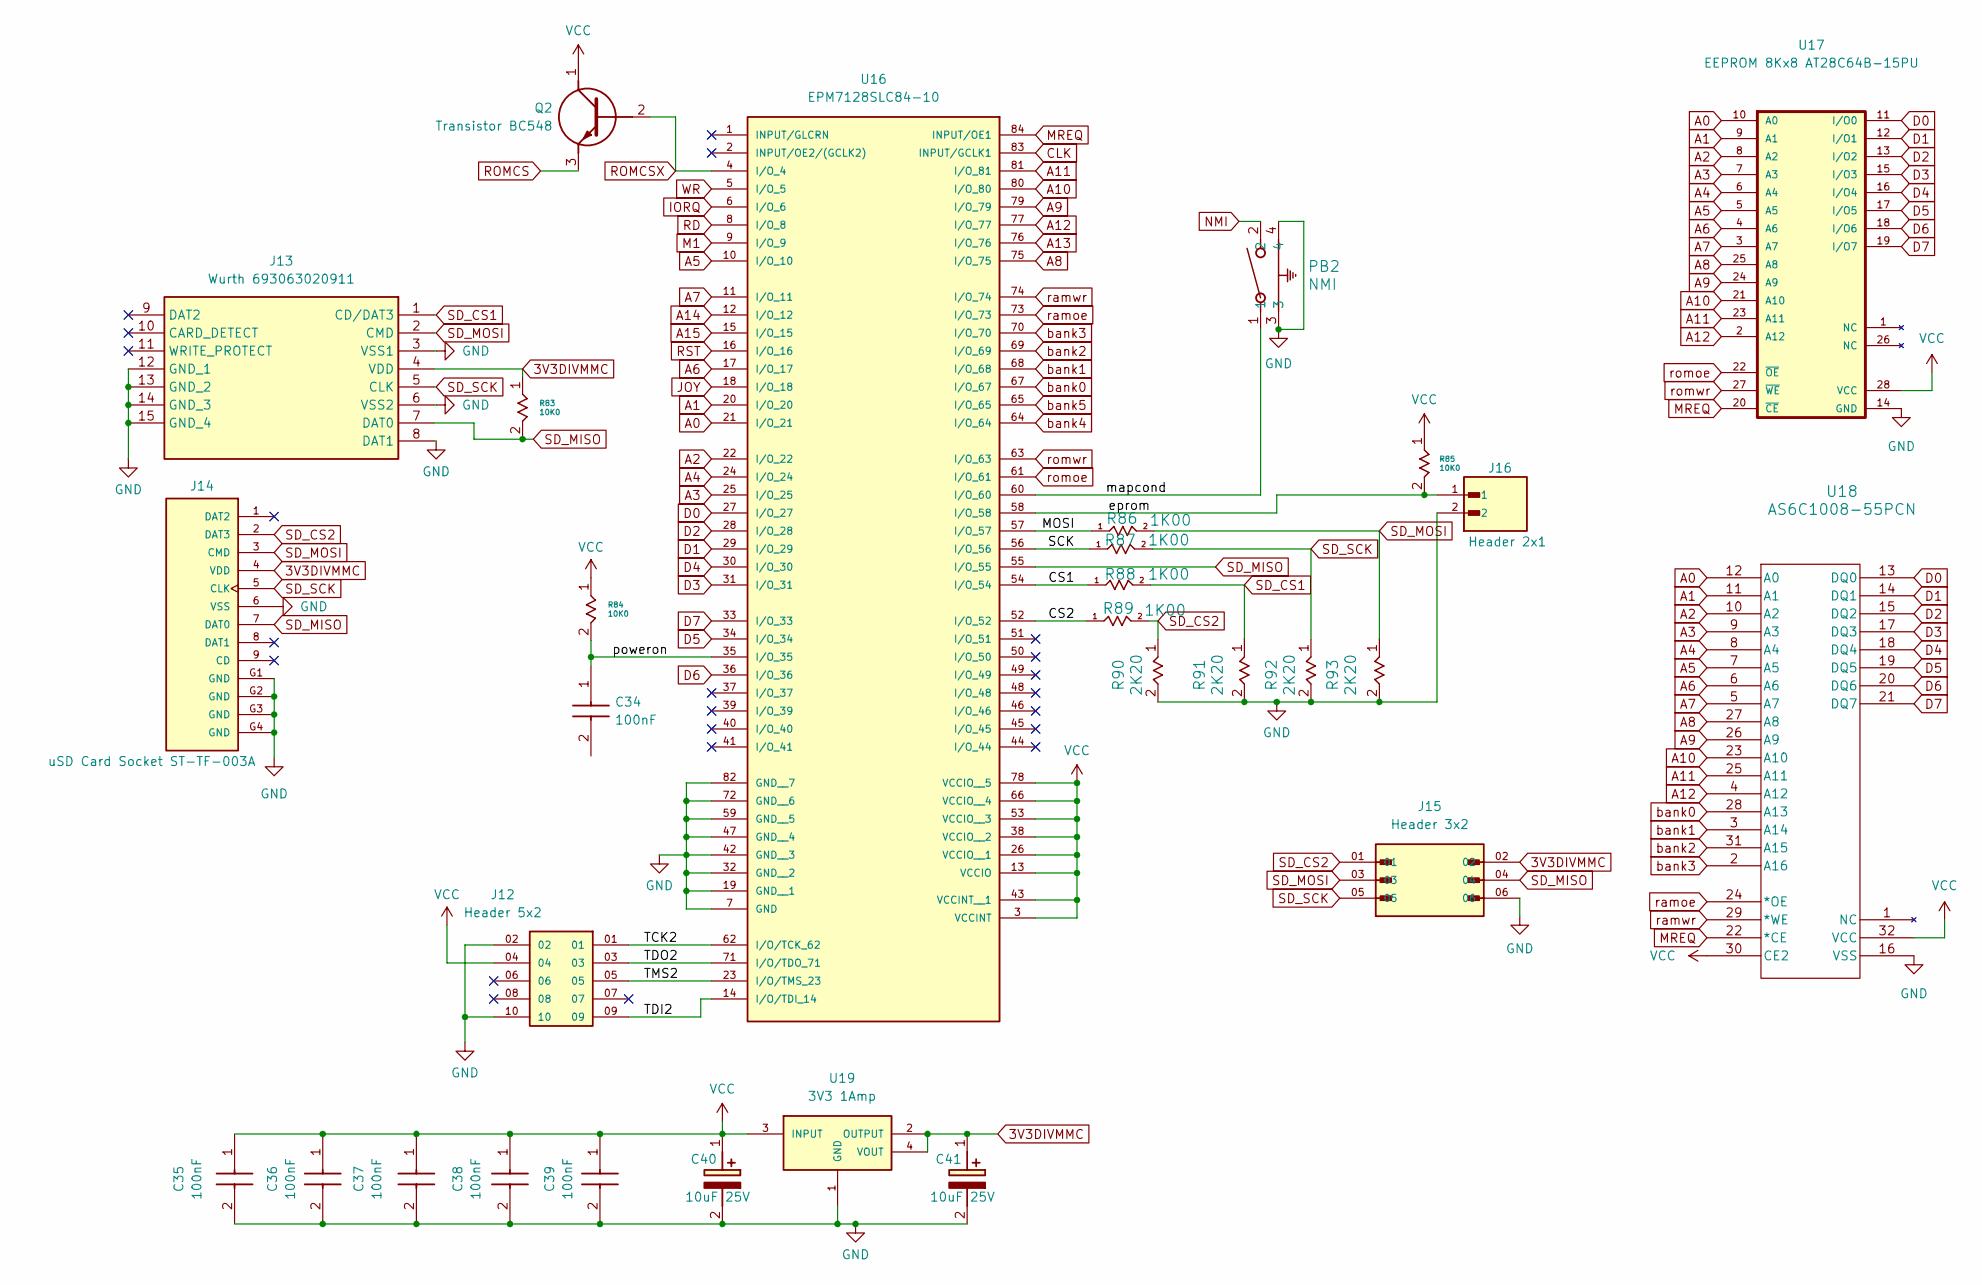
[picture p67: schematic DivMMC.kicad_sch]

Parts:
C34, C35, C36, C37, C38, C39: 100nF; CAPRB250W50L400T250H550; Mouser Part Number 594-K104Z15Y5VF5TL2
C40, C41: 10uF 25V; CAPPRD200W50D500H1100; Mouser Part Number 667-ECA-1EM100B
J12: Header 5x2; AMPHENOL_10129381-910002BLF; PARTREV D
J13: Wurth 693063020911; SD Card Connector Wurth 693063020911; Mouser Part Number 710-693063020911
J14: uSD Card Socket ST-TF-003A; SUNTECH_ST-TF-003A
J15: Header 3x2; AMPHENOL_10129381-906002BLF
J16: Header 2x1; HARWIN_M20-9990246; PARTREV 14
PB2: NMI; SW2_1825027-G_TEC
Q2: Transistor BC548; BC548BTA
R83, R84, R85: 10K0; STA_CF14_STP
R86, R87, R88, R89: 1K00; STA_CF14_STP
R90, R91, R92, R93: 2K20; STA_CF14_STP
U16: EPM7128SLC84-10; PLCC84AT
U17: EEPROM 8Kx8 AT28C64B-15PU; DIP1555W45P254L3733H482Q28
U18: AS6C1008-55PCN; PDIP-32_MIL600_ALL
U19: 3V3 1Amp; SOT230P700X185-4N

Connections:
3V3DIVMMC: C41.1 (+), J13.4 (VDD), J14.4 (VDD), J15.02, R83.1, U19.2 (OUTPUT), U19.4 (VOUT)
/DivMMC/CS1: R88.1, U16.54 (I/O_54)
/DivMMC/CS2: R89.1, U16.52 (I/O_52)
/DivMMC/MOSI: R86.1, U16.57 (I/O_57)
/DivMMC/SCK: R87.1, U16.56 (I/O_56)
/DivMMC/TCK2: J12.01, U16.62 (I/O/TCK_62)
/DivMMC/TDI2: J12.09, U16.14 (I/O/TDI_14)
/DivMMC/TDO2: J12.03, U16.71 (I/O/TDO_71)
/DivMMC/TMS2: J12.05, U16.23 (I/O/TMS_23)
/DivMMC/eprom: J16.1, R85.2, U16.58 (I/O_58)
/DivMMC/mapcond: PB2.1, U16.60 (I/O_60)
/DivMMC/poweron: C34.1 (+_1), R84.2, U16.35 (I/O_35)
A0: U16.21 (I/O_21), U17.10 (A0), U18.12 (A0); also elsewhere on the board
A1: U16.20 (I/O_20), U17.9 (A1), U18.11 (A1); also elsewhere on the board
A2: U16.22 (I/O_22), U17.8 (A2), U18.10 (A2); also elsewhere on the board
A3: U16.25 (I/O_25), U17.7 (A3), U18.9 (A3); also elsewhere on the board
A4: U16.24 (I/O_24), U17.6 (A4), U18.8 (A4); also elsewhere on the board
A5: U16.10 (I/O_10), U17.5 (A5), U18.7 (A5); also elsewhere on the board
A6: U16.17 (I/O_17), U17.4 (A6), U18.6 (A6); also elsewhere on the board
A7: U16.11 (I/O_11), U17.3 (A7), U18.5 (A7); also elsewhere on the board
A8: U16.75 (I/O_75), U17.25 (A8), U18.27 (A8); also elsewhere on the board
A9: U16.79 (I/O_79), U17.24 (A9), U18.26 (A9); also elsewhere on the board
A10: U16.80 (I/O_80), U17.21 (A10), U18.23 (A10); also elsewhere on the board
A11: U16.81 (I/O_81), U17.23 (A11), U18.25 (A11); also elsewhere on the board
A12: U16.77 (I/O_77), U17.2 (A12), U18.4 (A12); also elsewhere on the board
A13: U16.76 (I/O_76); also elsewhere on the board
A14: U16.12 (I/O_12); also elsewhere on the board
A15: U16.15 (I/O_15); also elsewhere on the board
CLK: U16.83 (INPUT/GCLK1); also elsewhere on the board
D0: U16.27 (I/O_27), U17.11 (I/O0), U18.13 (DQ0); also elsewhere on the board
D1: U16.29 (I/O_29), U17.12 (I/O1), U18.14 (DQ1); also elsewhere on the board
D2: U16.28 (I/O_28), U17.13 (I/O2), U18.15 (DQ2); also elsewhere on the board
D3: U16.31 (I/O_31), U17.15 (I/O3), U18.17 (DQ3); also elsewhere on the board
D4: U16.30 (I/O_30), U17.16 (I/O4), U18.18 (DQ4); also elsewhere on the board
D5: U16.34 (I/O_34), U17.17 (I/O5), U18.19 (DQ5); also elsewhere on the board
D6: U16.36 (I/O_36), U17.18 (I/O6), U18.20 (DQ6); also elsewhere on the board
D7: U16.33 (I/O_33), U17.19 (I/O7), U18.21 (DQ7); also elsewhere on the board
GND: C35.2 (-), C36.2 (-), C37.2 (-), C38.2 (-), C39.2 (-), C40.2 (-), C41.2 (-), J12.02, J12.10, J13.3 (VSS1), J13.6 (VSS2), J13.8 (DAT1), J13.12 (GND_1), J13.13 (GND_2), J13.14 (GND_3), J13.15 (GND_4), J14.6 (VSS), J14.G1 (GND), J14.G2 (GND), J14.G3 (GND), J14.G4 (GND), J15.06, J16.2, PB2.3, PB2.4, R90.2, R91.2, R92.2, R93.2, U16.7 (GND), U16.19 (GND__1), U16.32 (GND__2), U16.42 (GND__3), U16.47 (GND__4), U16.59 (GND__5), U16.72 (GND__6), U16.82 (GND__7), U17.14 (GND), U18.16 (VSS), U19.1 (GND); also elsewhere on the board
IORQ: U16.6 (I/O_6); also elsewhere on the board
JOY: U16.18 (I/O_18); also elsewhere on the board
M1: U16.9 (I/O_9); also elsewhere on the board
MREQ: U16.84 (INPUT/OE1), U17.20 (~CE), U18.22 (*CE); also elsewhere on the board
NMI: PB2.2; also elsewhere on the board
RD: U16.8 (I/O_8); also elsewhere on the board
ROMCS: Q2.3 (E); also elsewhere on the board
ROMCSX: Q2.2 (B), U16.4 (I/O_4)
RST: U16.16 (I/O_16); also elsewhere on the board
SD_CS1: J13.1 (CD/DAT3), R88.2, R91.1
SD_CS2: J14.2 (DAT3), J15.01, R89.2, R90.1
SD_MISO: J13.7 (DAT0), J14.7 (DAT0), J15.04, R83.2, U16.55 (I/O_55)
SD_MOSI: J13.2 (CMD), J14.3 (CMD), J15.03, R86.2, R93.1
SD_SCK: J13.5 (CLK), J14.5 (CLK), J15.05, R87.2, R92.1
VCC: C35.1 (+), C36.1 (+), C37.1 (+), C38.1 (+), C39.1 (+), C40.1 (+), J12.04, Q2.1 (C), R84.1, R85.1, U16.3 (VCCINT), U16.13 (VCCIO), U16.26 (VCCIO__1), U16.38 (VCCIO__2), U16.43 (VCCINT__1), U16.53 (VCCIO__3), U16.66 (VCCIO__4), U16.78 (VCCIO__5), U17.28 (VCC), U18.30 (CE2), U18.32 (VCC), U19.3 (INPUT); also elsewhere on the board
WR: U16.5 (I/O_5); also elsewhere on the board
bank0: U16.67 (I/O_67), U18.28 (A13)
bank1: U16.68 (I/O_68), U18.3 (A14)
bank2: U16.69 (I/O_69), U18.31 (A15)
bank3: U16.70 (I/O_70), U18.2 (A16)
bank4: U16.64 (I/O_64)
bank5: U16.65 (I/O_65)
ramoe: U16.73 (I/O_73), U18.24 (*OE)
ramwr: U16.74 (I/O_74), U18.29 (*WE)
romoe: U16.61 (I/O_61), U17.22 (~OE)
romwr: U16.63 (I/O_63), U17.27 (~WE)

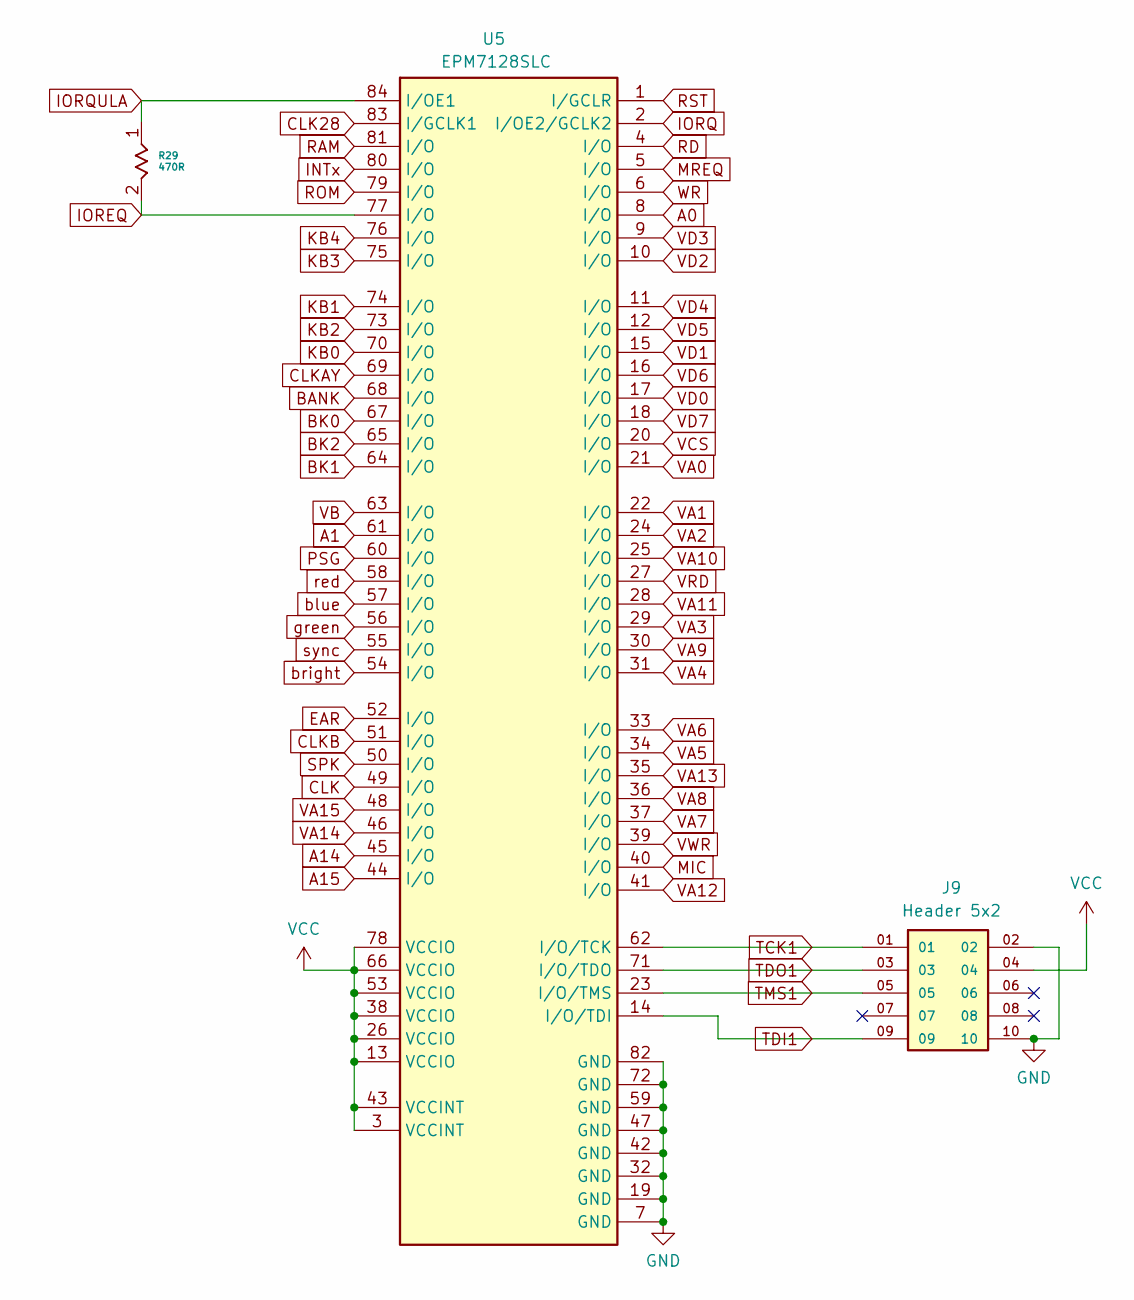
[picture p68: schematic EPM7128S.kicad_sch]

Parts:
J9: Header 5x2; AMPHENOL_10129381-910002BLF; PARTREV D
R29: 470R; STA_CF14_STP
U5: EPM7128SLC; PLCC84AT

Connections:
A0: U5.8 (I/O); also elsewhere on the board
A1: U5.61 (I/O); also elsewhere on the board
A14: U5.45 (I/O); also elsewhere on the board
A15: U5.44 (I/O); also elsewhere on the board
BANK: U5.68 (I/O); also elsewhere on the board
BK0: U5.67 (I/O); also elsewhere on the board
BK1: U5.64 (I/O); also elsewhere on the board
BK2: U5.65 (I/O); also elsewhere on the board
CLK: U5.49 (I/O); also elsewhere on the board
CLK28: U5.83 (I/GCLK1); also elsewhere on the board
CLKAY: U5.69 (I/O); also elsewhere on the board
CLKB: U5.51 (I/O); also elsewhere on the board
EAR: U5.52 (I/O); also elsewhere on the board
GND: J9.02, J9.10, U5.7 (GND), U5.19 (GND), U5.32 (GND), U5.42 (GND), U5.47 (GND), U5.59 (GND), U5.72 (GND), U5.82 (GND); also elsewhere on the board
INTx: U5.80 (I/O); also elsewhere on the board
IOREQ: R29.2, U5.77 (I/O)
IORQ: U5.2 (I/OE2/GCLK2); also elsewhere on the board
IORQULA: R29.1, U5.84 (I/OE1); also elsewhere on the board
KB0: U5.70 (I/O); also elsewhere on the board
KB1: U5.74 (I/O); also elsewhere on the board
KB2: U5.73 (I/O); also elsewhere on the board
KB3: U5.75 (I/O); also elsewhere on the board
KB4: U5.76 (I/O); also elsewhere on the board
MIC: U5.40 (I/O); also elsewhere on the board
MREQ: U5.5 (I/O); also elsewhere on the board
PSG: U5.60 (I/O); also elsewhere on the board
RAM: U5.81 (I/O); also elsewhere on the board
RD: U5.4 (I/O); also elsewhere on the board
ROM: U5.79 (I/O); also elsewhere on the board
RST: U5.1 (I/GCLR); also elsewhere on the board
SPK: U5.50 (I/O); also elsewhere on the board
TCK1: J9.01, U5.62 (I/O/TCK)
TDI1: J9.09, U5.14 (I/O/TDI)
TDO1: J9.03, U5.71 (I/O/TDO)
TMS1: J9.05, U5.23 (I/O/TMS)
VA0: U5.21 (I/O); also elsewhere on the board
VA1: U5.22 (I/O); also elsewhere on the board
VA2: U5.24 (I/O); also elsewhere on the board
VA3: U5.29 (I/O); also elsewhere on the board
VA4: U5.31 (I/O); also elsewhere on the board
VA5: U5.34 (I/O); also elsewhere on the board
VA6: U5.33 (I/O); also elsewhere on the board
VA7: U5.37 (I/O); also elsewhere on the board
VA8: U5.36 (I/O); also elsewhere on the board
VA9: U5.30 (I/O); also elsewhere on the board
VA10: U5.25 (I/O); also elsewhere on the board
VA11: U5.28 (I/O); also elsewhere on the board
VA12: U5.41 (I/O); also elsewhere on the board
VA13: U5.35 (I/O); also elsewhere on the board
VA14: U5.46 (I/O); also elsewhere on the board
VA15: U5.48 (I/O); also elsewhere on the board
VB: U5.63 (I/O); also elsewhere on the board
VCC: J9.04, U5.3 (VCCINT), U5.13 (VCCIO), U5.26 (VCCIO), U5.38 (VCCIO), U5.43 (VCCINT), U5.53 (VCCIO), U5.66 (VCCIO), U5.78 (VCCIO); also elsewhere on the board
VCS: U5.20 (I/O); also elsewhere on the board
VD0: U5.17 (I/O); also elsewhere on the board
VD1: U5.15 (I/O); also elsewhere on the board
VD2: U5.10 (I/O); also elsewhere on the board
VD3: U5.9 (I/O); also elsewhere on the board
VD4: U5.11 (I/O); also elsewhere on the board
VD5: U5.12 (I/O); also elsewhere on the board
VD6: U5.16 (I/O); also elsewhere on the board
VD7: U5.18 (I/O); also elsewhere on the board
VRD: U5.27 (I/O); also elsewhere on the board
VWR: U5.39 (I/O); also elsewhere on the board
WR: U5.6 (I/O); also elsewhere on the board
blue: U5.57 (I/O); also elsewhere on the board
bright: U5.54 (I/O); also elsewhere on the board
green: U5.56 (I/O); also elsewhere on the board
red: U5.58 (I/O); also elsewhere on the board
sync: U5.55 (I/O); also elsewhere on the board

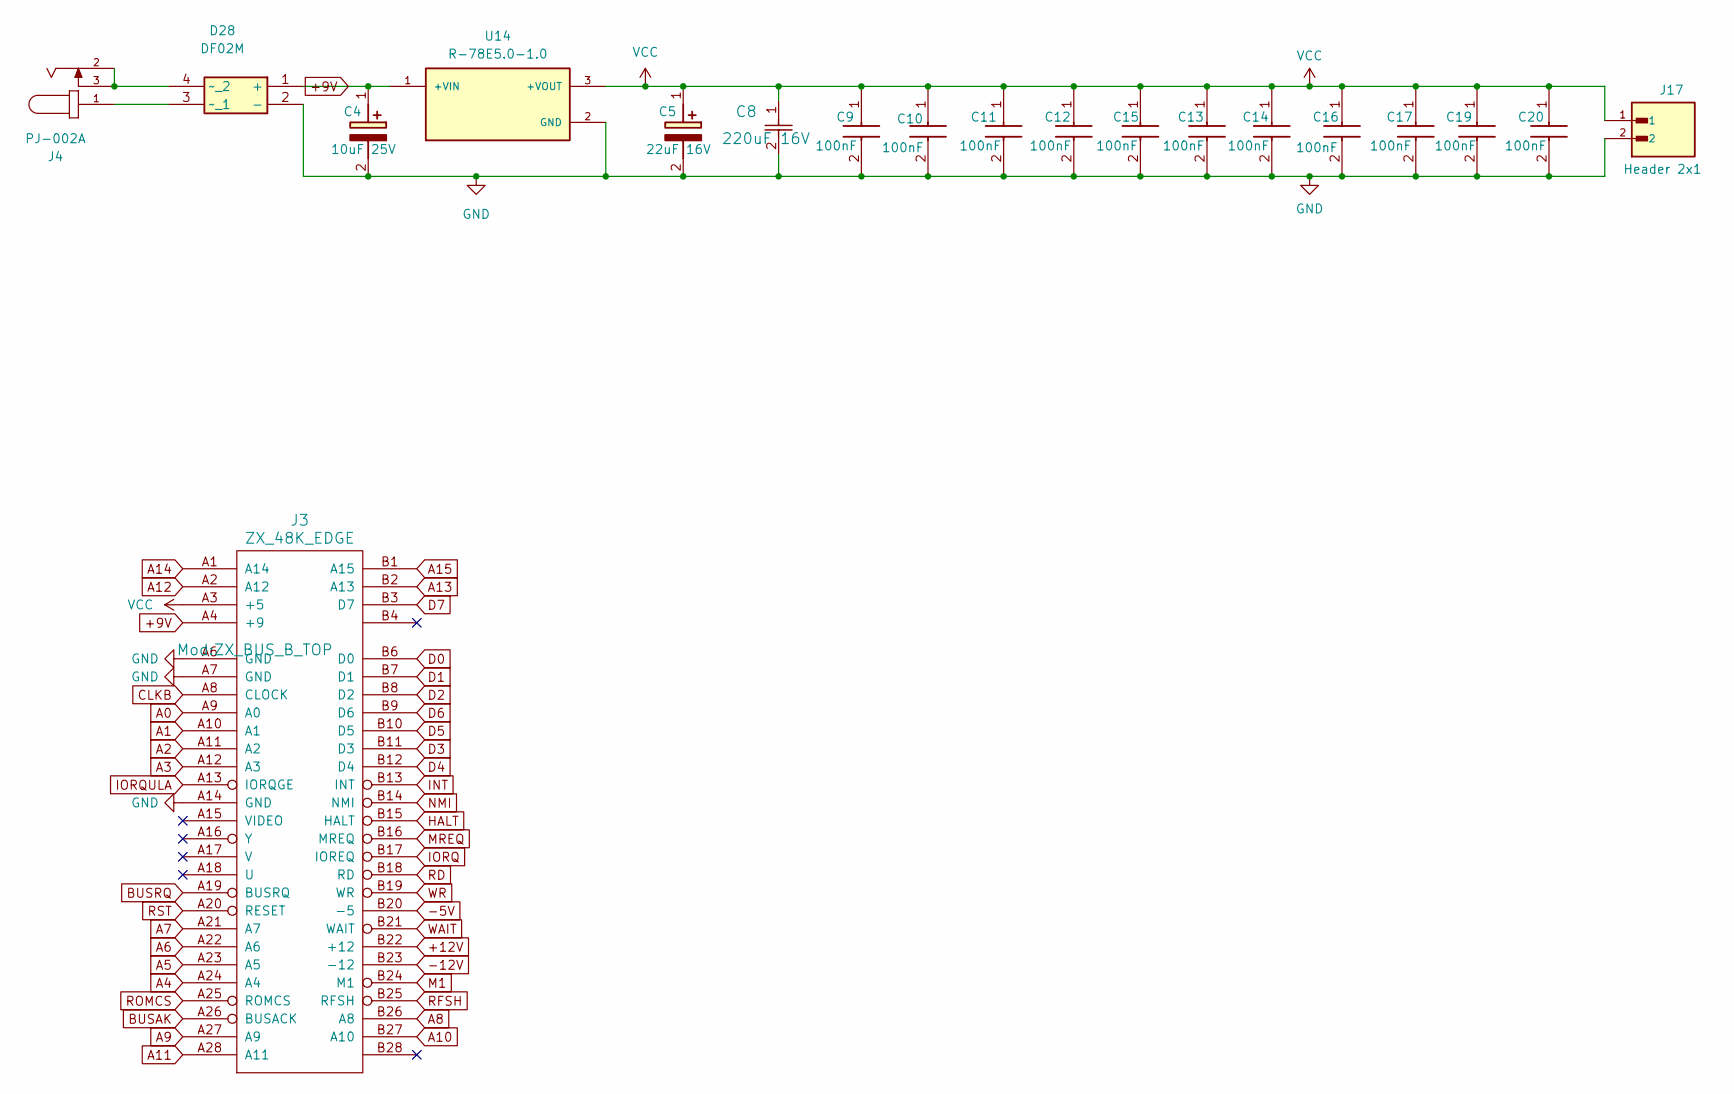
[picture p69: schematic Power&Filter.kicad_sch]

Parts:
C4: 10uF 25V; CAPPRD200W50D500H1100; Mouser Part Number 667-ECA-1EM100B
C5: 22uF 16V; CAPPRD200W50D500H1100; Mouser Part Number 667-ECA-1EM100B
C8: 220uF 16V; CAPPRD200W50D500H1100
C9, C10, C11, C12, C13, C14, C15, C16, C17, C19, C20: 100nF; CAPRB250W50L400T250H550; Mouser Part Number 594-K104Z15Y5VF5TL2
D28: DF02M; DIP825W58P510L832H543Q4N; Mouser Part Number 621-DF02M
J3: ZX_48K_EDGE; ZX_BUS_B_TOP
J4: PJ-002A; CUI_PJ-002A
J17: Header 2x1; HARWIN_M20-9990246; PARTREV 14
U14: R-78E5.0-1.0; CONV_R-78E5.0-1.0; PARTREV 6

Connections:
+9V: C4.1 (+), D28.1 (+), J3.A4 (+9), U14.1 (+VIN)
+12V: J3.B22 (+12)
-5V: J3.B20 (-5)
-12V: J3.B23 (-12)
A0: J3.A9 (A0); also elsewhere on the board
A1: J3.A10 (A1); also elsewhere on the board
A2: J3.A11 (A2); also elsewhere on the board
A3: J3.A12 (A3); also elsewhere on the board
A4: J3.A24 (A4); also elsewhere on the board
A5: J3.A23 (A5); also elsewhere on the board
A6: J3.A22 (A6); also elsewhere on the board
A7: J3.A21 (A7); also elsewhere on the board
A8: J3.B26 (A8); also elsewhere on the board
A9: J3.A27 (A9); also elsewhere on the board
A10: J3.B27 (A10); also elsewhere on the board
A11: J3.A28 (A11); also elsewhere on the board
A12: J3.A2 (A12); also elsewhere on the board
A13: J3.B2 (A13); also elsewhere on the board
A14: J3.A1 (A14); also elsewhere on the board
A15: J3.B1 (A15); also elsewhere on the board
BUSAK: J3.A26 (BUSACK); also elsewhere on the board
BUSRQ: J3.A19 (BUSRQ); also elsewhere on the board
CLKB: J3.A8 (CLOCK); also elsewhere on the board
D0: J3.B6 (D0); also elsewhere on the board
D1: J3.B7 (D1); also elsewhere on the board
D2: J3.B8 (D2); also elsewhere on the board
D3: J3.B11 (D3); also elsewhere on the board
D4: J3.B12 (D4); also elsewhere on the board
D5: J3.B10 (D5); also elsewhere on the board
D6: J3.B9 (D6); also elsewhere on the board
D7: J3.B3 (D7); also elsewhere on the board
GND: C4.2 (-), C5.2 (-), C8.2, C9.2 (-), C10.2 (-), C11.2 (-), C12.2 (-), C13.2 (-), C14.2 (-), C15.2 (-), C16.2 (-), C17.2 (-), C19.2 (-), C20.2 (-), D28.2 (-), J3.A6 (GND), J3.A7 (GND), J3.A14 (GND), J17.2, U14.2 (GND); also elsewhere on the board
HALT: J3.B15 (HALT); also elsewhere on the board
INT: J3.B13 (INT); also elsewhere on the board
IORQ: J3.B17 (IOREQ); also elsewhere on the board
IORQULA: J3.A13 (IORQGE); also elsewhere on the board
M1: J3.B24 (M1); also elsewhere on the board
MREQ: J3.B16 (MREQ); also elsewhere on the board
NMI: J3.B14 (NMI); also elsewhere on the board
unnamed: D28.3 (~_1), J4.1
unnamed: D28.4 (~_2), J4.2, J4.3
RD: J3.B18 (RD); also elsewhere on the board
RFSH: J3.B25 (RFSH); also elsewhere on the board
ROMCS: J3.A25 (ROMCS); also elsewhere on the board
RST: J3.A20 (RESET); also elsewhere on the board
VCC: C5.1 (+), C8.1, C9.1 (+), C10.1 (+), C11.1 (+), C12.1 (+), C13.1 (+), C14.1 (+), C15.1 (+), C16.1 (+), C17.1 (+), C19.1 (+), C20.1 (+), J3.A3 (+5), J17.1, U14.3 (+VOUT); also elsewhere on the board
WAIT: J3.B21 (WAIT); also elsewhere on the board
WR: J3.B19 (WR); also elsewhere on the board

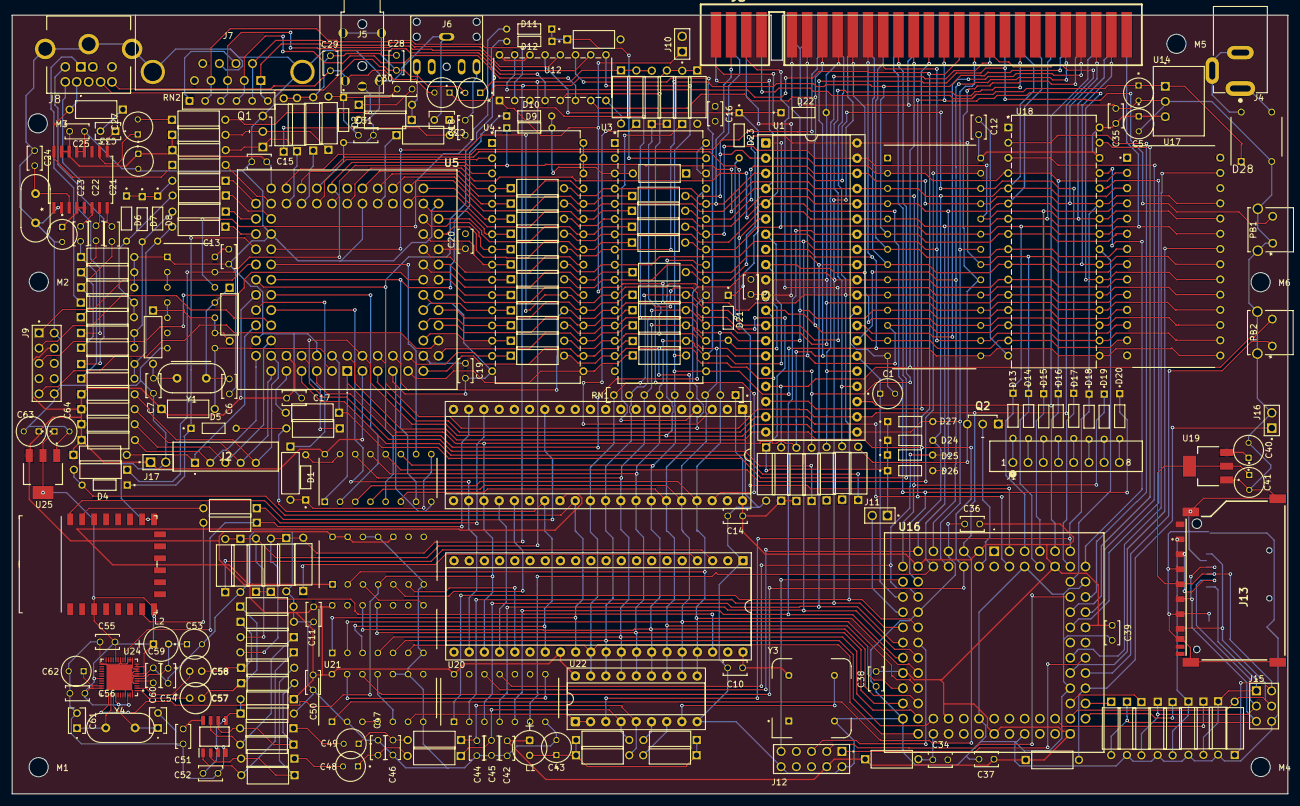
[picture p70: board ZX Max 128 Issue 5 PCB.kicad_pcb from above]

Board: 2 copper layers, 213.0 x 130.0 mm, 262 parts (1 on the bottom side), 231 nets.

Other parts of the board:
C2, C3: 10uF 25V; CAPPRD200W50D500H1100
D4, D5: 1N4148; DIOAD753W49L380D172B
J5: AV Jack; PJ-322A
R57, R58, R81, R82: 470R; STA_CF14_STP
R59, R62, R63, R64, R65, R68, R69, R70: 1K00; STA_CF14_STP
R60, R61, R66, R67: 2K20; STA_CF14_STP
U8, U9: AY-3-8910; Z80_Socket
U10: CD74HC30E; DIP794W53P254L1930H508Q14N
U11: 74HC74; DIP794W53P254L1930H508Q14N
U15: ESP8266-12E; WIFI_Module_ESP8266_12E

Their connections:
+3V3D: U15.3 (EN), U15.8 (VCC); also elsewhere on the board
A14: R57.1; also elsewhere on the board
A-AY: R59.1, U8.4 (CHANNEL_A)
A-AY2: R65.1, U9.4 (CHANNEL_A)
AY1: U8.25 (A8), U11.5 (Q)
AY2: U9.25 (A8), U11.6 (~Q)
Audio-L: C3.2 (-), J5.3; also elsewhere on the board
Audio-R: C2.2 (-), J5.4; also elsewhere on the board
B-AY: R62.1, U8.3 (CHANNEL_B)
B-AY2: R68.1, U9.3 (CHANNEL_B)
BC1: D4.A, R57.2, U8.29 (BC1), U9.29 (BC1), U10.1
BDIR: D5.A, R58.2, U8.27 (BDIR), U9.27 (BDIR), U10.3
C-AY: R60.1, R61.1, U8.38 (CHANNEL_C)
CLKAY: U8.22 (CLK), U9.22 (CLK); also elsewhere on the board
Comp: J5.1; also elsewhere on the board
D0: U8.37 (DA0), U9.37 (DA0), U11.2 (D); also elsewhere on the board
D1: U8.36 (DA1), U9.36 (DA1), U10.2; also elsewhere on the board
D2: U8.35 (DA2), U9.35 (DA2); also elsewhere on the board
D3: U8.34 (DA3), U9.34 (DA3), U10.12; also elsewhere on the board
D4: U8.33 (DA4), U9.33 (DA4), U10.11; also elsewhere on the board
D5: U8.32 (DA5), U9.32 (DA5), U10.4; also elsewhere on the board
D6: U8.31 (DA6), U9.31 (DA6), U10.5; also elsewhere on the board
D7: U8.30 (DA7), U9.30 (DA7), U10.6; also elsewhere on the board
GND: J5.2, R63.2, R64.2, R69.2, R70.2, U8.1 (VSS), U8.24 (~A9), U9.1 (VSS), U9.24 (~A9), U10.7 (GND), U11.7 (GND), U11.11 (C), U11.12 (D), U15.15 (GND), U15.16 (TXD2/IO15); also elsewhere on the board
IN4: U8.14 (IOA7), U15.22 (TXD0/TXD)
L-in: C3.1 (+), R61.2, R62.2, R64.1, R67.2, R68.2, R70.1; also elsewhere on the board
MIDI: R81.2, U15.7 (MOSI/IO13)
unnamed: R66.1, R67.1, U9.38 (CHANNEL_C)
unnamed: U10.8, U11.3 (C)
unnamed: R82.2, U15.21 (RXD0/RXD)
OUT3: R81.1, U8.19 (IOA2); also elsewhere on the board
OUT4: R82.1, U8.18 (IOA3)
PSG: D4.K, D5.K; also elsewhere on the board
R-in: C2.1 (+), R59.2, R60.2, R63.1, R65.2, R66.2, R69.1; also elsewhere on the board
RD: R58.1; also elsewhere on the board
RST: U8.23 (~RESET), U9.23 (~RESET), U11.4 (~S); also elsewhere on the board
VCC: U8.28 (BC2), U8.40 (VCC), U9.28 (BC2), U9.40 (VCC), U10.14 (VCC), U11.1 (~R), U11.10 (~S), U11.13 (~R), U11.14 (VCC); also elsewhere on the board
