liveboxandy/ZX-Max-128-Issue-5/(commit log)

2026-02-06 Enhance README with warnings and usage notes
    Added warnings and clarifications about the PCB layout and usage.
2026-07-04 Add files via upload
    Latest additions to include full track routing and vias to allow a full ibom to be created. Part 1.
2026-07-04 Add files via upload
    Latest additions to include full track routing and vias to allow a full ibom to be created. Part 2.
    [10129381-906002BLF.step, 10129381-910002BLF.step, 4606X-101-103LF.STEP, 4609X-101-103LF.step, 5-520315-5.stp, 84-PLCC_ALR.step, 9Pin D MRA Assmannn A-DS_09_A_KG-T4S.step, Audio Connector SJ1-3525N.step]
2026-07-04 Add files via upload
    Latest additions to include full track routing and vias to allow a full ibom to be created. Part 3. While Kicad created the gerbers without error I am not convinced about getting any pcbs manufactured without someone else verifying the created schematics against the originals from DonSuperFo and then verifying that schematic against the pcb layout. I only did this as an exercise to create a full ibom to assist in component assembly.
    [CPU-ROM-RAM.kicad_sch, DivMMC.kicad_sch, EPM7128S.kicad_sch, Joystick.kicad_sch, Midi.kicad_sch, Power&Filter.kicad_sch, SAA1099.kicad_sch, Turbo Sound.kicad_sch]
2026-07-05 Revise README for KiCAD version and layout warnings
    Updated KiCAD version from 9 to 10 and clarified warnings about the PCB layout.
2026-07-26 Update README with assembly and part number details
    Added notes about part numbers and ordering PCBs.
