liveboxandy/ZX-Max-128-Issue-5/(notices)

Notices in the files:
Step/DIP-18_W7.62mm_Socket.step:
Copyright (C) 2017, Terje Io
This program is free software: you can redistribute it and/or modify
it under the terms of the GNU General Public License as published by
the Free Software Foundation, either version 3 of the License, or
any later version.
itself might be covered by the GNU General Public License.
Step/DIP-40_W15.24mm.step:
Copyright (C) 2017, your name
Step/Resistor.08.88.step:
Copyright (C) 2026, KiCAD
This work is licensed under the
[Creative Commons CC-BY-SA 4.0 License](https://creativecommons.org/licenses/by-sa/4.0/legalcode),
with the following exception:
project files under this or any other license agreement. However, if you wish to distribute
